Teukka/FlexHomeElPower/README.md

# JouKo - FlexHomeElPower (suom. 'Joustava Kotitalous')

Flexible Power Usage at Home, JouKo project main repository
This repository contains the public documentation of JouKo project.
The leader of the JouKo project is XAMK, Digital Economy: https://www.xamk.fi/en/digital-economy-spearheads-of-competence/

Links to the software of JouKo Project:
- Control Device software repository: https://github.com/Teukka/Jouko
- Server and user interfaces software repository: https://github.com/Metatavu/jouko
- Server API (interface desctriptions): https://github.com/Metatavu/jouko-api-spec
