Teukka/FlexHomeElPower/ControlDeviceDocuments/README.md

# Jouko Control Device Software documents

This folder contains the installation guides of JouKo control device.
