Teukka/FlexHomeElPower/HW_Descriptions/Voltage Source for GSM 2G/JouKo 5 V Source Schematics.pdf

# Home Electricity IoT

PROJECT ”JOUKO” BY SOUTH-EASTERN FINLAND UNIVERSITY OF APPLIED SCIENCES LTD
WWW.XAMK.FI/EN/FRONTPAGE/

# 5 V 2 A AC/DC Voltage Source for the JouKo GSM versions ( Countryside Control Unit )

THE MOTHERBOARD CONVERTS THIS 5 V DC INTO 4 V DC ACTUALLY REQUIRED BY THE GSM RADIO CHIPS BY SIMCOM. THIS CIRCUIT GENERATES

### 5 V 2 A FROM THE MAINS VOLTAGE. THERE ARE COUNTERMEASURES

AGAINST BOTH RADIATED AND CONDUCTED DISTURBANCE EMISSIONS
( EMI ) . THIS MODULE IS NOT REQUIRED WITH THE LORAWAN ONLY OR BLUETOOTH ONLY VERSIONS.

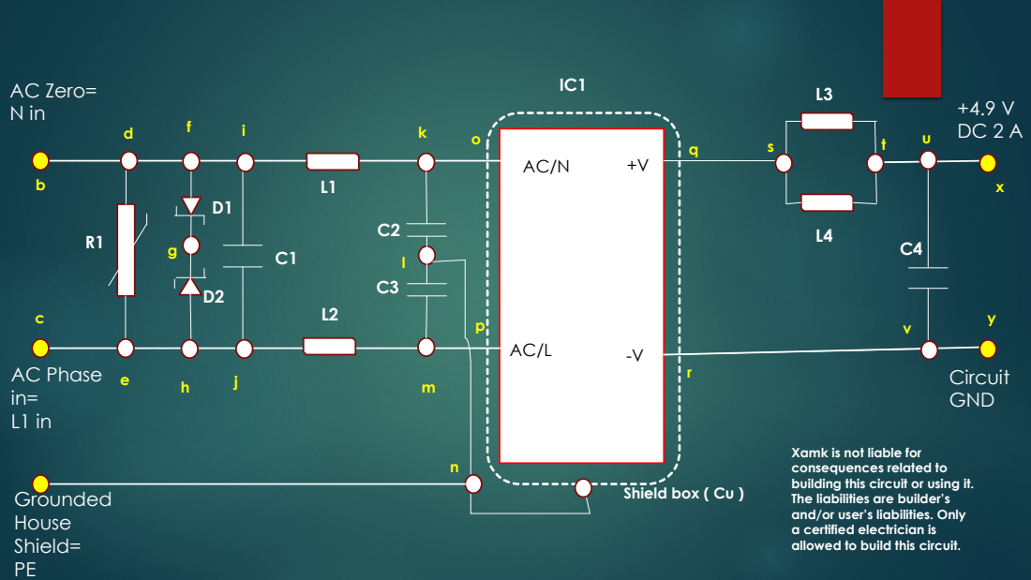
[picture p6: page 3]
AC Phase in= L1 in; AC Zero= N in; Grounded House Shield; Circuit GND

Xamk is not liable for consequences related to
building this circuit or using it.
The liabilities are builder’s
and/or user’s liabilities. Only
a certified electrician is
allowed to build this circuit

Shield box ( Cu
