Teukka/FlexHomeElPower/BusinessStudies/Business_Studies_Report_JouKo_in_Finnish.pdf

## Marjo Puikkonen & Roope Raati

# JouKo-joustava kotitalous projekti

## Kysyntäjoustopalvelun liiketoimintamallit

2018

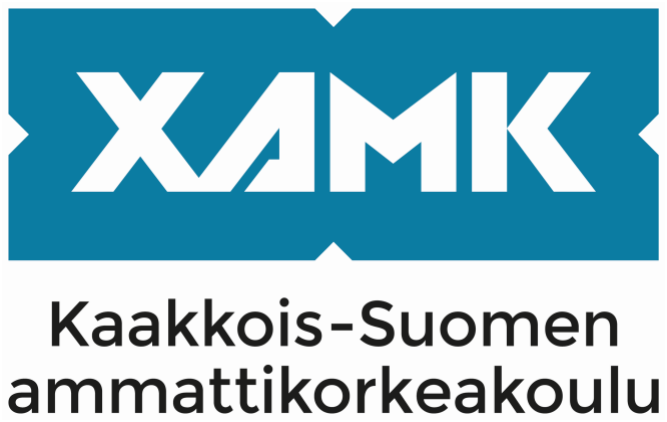
[picture p7: figure]

SISÄLLYS

LIITTEET

Liite 1. Haastattelun esitys

Liite 2. Kuvaluettelo

### 1 JOHDANTO

Tämä raportti käsittelee JouKo – laitteen kotitalousasiakkaille suunnatun ky-

syntäjoustopalvelun liiketoimintamallien tutkimista, potentiaalisten markkina-

paikkojen selvittämistä sekä laitteen teknistä soveltuvuutta kysyntäjoustoon.

Tutkimuksen lähdeaineistona olemme käyttäneet älysähköverkkoon liittyviä ai-

kaisempia tutkimusaineistoja sekä suorittamiemme haastatteluiden aineistoja.

### 2 KYSYNTÄJOUSTO SUOMESSA

Tähän mennessä kysyntäjoustoon ollaan osallistuttu teollisuuden isoilla kuor-

milla. Lisäksi muutamia pilotti kokeiluja on tehty muun muassa kauppakeskus-

ten kuormien ohjauksella sekä varavoiman hyödyntämisenä sähköverkkoon.

Kotitalouksien keskuudessa kysyntäjoustosta on kokeiluja muutamien sähkö-

yhtiöiden toteuttamana erilaisten projektien tiimoilta, jossa kotitalouksien läm-

minvesivaraaja ohjataan käyttämään lämmitykseen sähköpörssin halvimpia

tunteja kulutuksen tasaamiseksi. Tällaisia kokeiluja ovat toteuttaneet esimer-

kiksi Fortum ja Helen.

Uusia toimijoita kysyntäjoustoon ovat aggregaattorit, jotka osallistuvat markki-

noille keräämänsä pienkulutuksen ja –tuotannon avulla. Tällainen toiminta

mahdollistaa myös tulevaisuudessa kotitalouksien osallistumisen kysyntäjous-

toon. Vaikka alkuinvestoinnit ovat aluksi suuret, katsotaan sen olevan pitkällä

aikavälillä kustannustehokas niin itse yrittäjälle kuin koko kansantaloudellekin.

Tehomäärältään eniten kauppaa käydään taajuusohjatun häiriöreservin, sää-

tösähkö- sekä vuorokausimarkkinoilla (kuva 1). [8.]

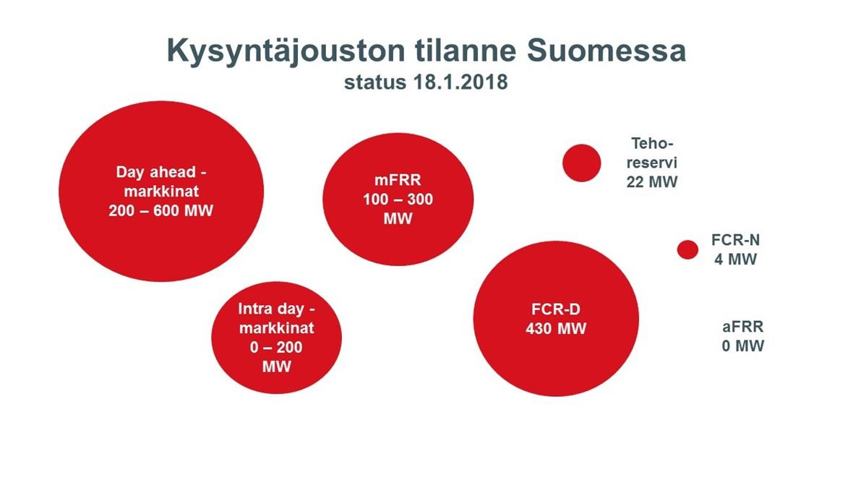
[picture p8: figure]

Kuva 1. Kysyntäjouston tilanne Suomessa. (Fingrid, 2018)

Sähkön hinta kuluttajalle rakentuu sähkön siirrosta (29%), myynnistä (37 %)

sekä sähköverosta (34%). Energiavirasto valvoo sähkön siirtohinnan kohtuulli-

suutta vuoden valvontajaksoissa. Mikäli siirtoliiketoiminnan tuotto ylittyy koh-

tuullisen tuoton rajan koko valvontajaksolla, otetaan se huomioon hinnoitte-

lussa seuraavalla valvontajaksolla. Sähkön siirtohinnasta peritään kulloinkin

voimassa olevat sähköverot. [15.]

Sähköliittymä on hinnoiteltu niin, että niillä katetaan jakeluverkon rakennus-

kustannuksia. Se koostuu liittymis- ja mittarointiosasta, ja on kokonaisuudes-

saan arvonlisäverotonta. Energiahinta määräytyy kunkin yhtiön sopimusten

mukaisesti joko määräaikaisena, toistaiseksi voimassa olevana tai Spot-hin-

taan perustuvana sopimuksena. [15.]

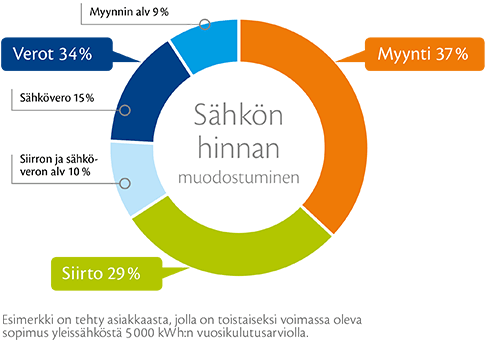
[picture p9: figure]

Kuva 2. Sähkön hinnan muodostuminen. (Lappeenrannan energia oy)

### 2.1 Tulevaisuuden energiamarkkinat 2019-2024

Tulevaisuudessa energia-alan toimintatavat tulevat muuttumaan, joka näkyy

niin energian tuotannossa, käytössä kuin siirrossakin. Järjestelmät pyritään te-

kemään hiilineutraaleiksi, jossa fossiilisilla polttoaineilla toimiva perusvoima

korvataan vaihtelevalla tuotannolla. Tämä tuotetaan uusiutuvalla tai muuten

päästöttömillä energialähteillä kuten tuuli-, aurinko- ja vesivoimalla. Pariisin il-

mastosopimuksen mukaan energiajärjestelmä tulee olla päästötön vuoteen

2050 mennessä, joka tarkoittaa sitä, että fossiilisista polttoaineista on luovut-

tava kokonaan muutaman vuosikymmenen aikana. Suurin osa näistä polttoai-

neista käytetään energiana liikenteessä sekä lämmön ja sähkön tuotannossa.

Kehitys tuo tullessaan muutoksen, jossa edetään suurista tuotantoyksiköistä

kohti hajautetumpaa ja kaksisuuntaista järjestelmää. Muutosta pyritään vauh-

dittamaan myös erilaisilla ohjauskeinoilla kuten päästökaupalla ja tukijärjestel-

millä. [9]

Energiamurros kattaa koko Eurooppaa, sillä energian siirtoverkkoja ja markki-

noita integroidaan ja harmonisoidaan koko EU:n tasolla. Esimerkiksi Fingrid ja

Ruotsin kantaverkkoyhtiö ovat päättäneet toteuttaa uuden pohjoiseen sijoittu-

van rajasiirtoyhteyden vuoteen 2025 mennessä, jolloin edullista sähköä pää-

see virtaamaan Suomeen. Tämä parantaa muun muassa käyttövarmuutta ja turvaa sähkön riittävyyteen talvipakkasilla. Yhteisten markkinoiden avulla saa-

vutetaan järjestelmän mahdollisimman tehokas käyttö, joka tuo vakautta toi-

mintaan. [10.]

Asiakkaan rooli tulee myös muuttumaan. Tämän hetkisestä passiivisesta ku-

luttaja-asiakkaasta muovautuu aktiivinen markkinatoimija, kun vaihtelevan tuo-

tannon lisääntyessä myös kulutuksen pitää joustaa enemmän. Kehittyneen

teknologian myötä myös asiakas pääsee toimimaan osana vallitsevaa markki-

naa. Heidän rooli etenkin kysyntäjouston, pientuotannon sekä varastoinnin

osalla tulee olemaan tärkeässä osassa. Menestyäkseen energiamurroksessa,

vaatii se rohkeita toimijoita energiamarkkinoille. Heiltä odotetaan uudenlaista

ajattelua, innovaatioita, rohkeita päätöksiä ja kokeiluhalukkuutta. Kuluttajien

houkutteleminen energiamarkkinoille nousee myös tärkeäksi asiaksi ja se,

kuinka heitä tulisi aktivoida mukaan. Kuluttajien muuttuminen markkinatoimi-

joiksi vaatii kuitenkin helppokäyttöisiä ja ymmärrettäviä palveluita, joilla heräte-

tään kuluttajan kiinnostus palvelua kohtaan. Tämä luo vaatimukset itse sovel-

lukselle, jonka avulla omaa kulutusta ja tuotantoa ohjataan. [11.]

Aggregaattoritoiminnalle nähdään tarvetta tulevaisuudessa kulutuksen tasaa-

misessa. Mikäli siirrytään tehopohjaiseen hinnoitteluun, tarve kasvaa entises-

tään. Tällöin myös kotitalousasiakkaiden kiinnostus kysyntäjoustopalvelua

kohtaan kasvaa. Tulevaisuudessa myös ympäristötekijöiden merkitys kasvaa

ja kuluttajat ovat entistä tietoisempia kulutuksen lisääntymisen vaikutuksesta

ympäristötekijöihin. Näin ollen he ovat myös valmiimpia toimimaan sen eteen.

Tulevaisuuden tietoyhteiskunta edellyttää jakeluverkolta suurempaa jousta-

vuutta ja luotettavuutta. Sähkönkulutus kotitalouksissa tulee kasvamaan enti-

sestään, sillä sähkölaitteiden määrä lisääntyy. Näiden lisäksi sähköautojen

yleistyminen luo omat haasteensa verkon kapasiteetin riittävyydelle. Hajau-

tettu energiatuotanto vaatii nykyistä kehittyneempien säätö- ja tietoliikennelait-

teiden käyttöönottoa. [12]

Tulevaisuus avaa mahdollisesti uusia markkinapaikkoja ja näin tuo tullessaan

uusia mahdollisuuksia erilaiselle liiketoiminnalle. Näihin muutoksiin on kuiten-

kin kyettävä reagoimaan jo hyvissä ajoin, jolloin säästytään mahdolliselta te-

hopulalta. Ideaalisinta olisi pitää kuormat tasaisena, jolloin varavoimalaitoksia

ei tarvitsisi kytkeä päälle. Se olisi taloudellisesti kannattavaa, mutta ennen kaikkea ympäristöystävällistä. Kotitalouksien omatuotanto tulee tulevaisuu-

dessa kasvamaan sekä sen varastointi. Näin ollen kotitaloudet pystyvät myös

helpommin osallistumaan kysyntäjoustoon. Kokonaisvaltaisen kulutuksen opti-

mointi asiakkaan puolesta tulee olemaan avainasemassa uuden tyyppiselle

sähkösopimukselle. Datahub, energian keskuspankki ja energian internet tule-

vat olemaan tulevaisuuden kehityssuuntaa, jotka omilta osiltaan ovat muok-

kaamassa energiamarkkinoita.

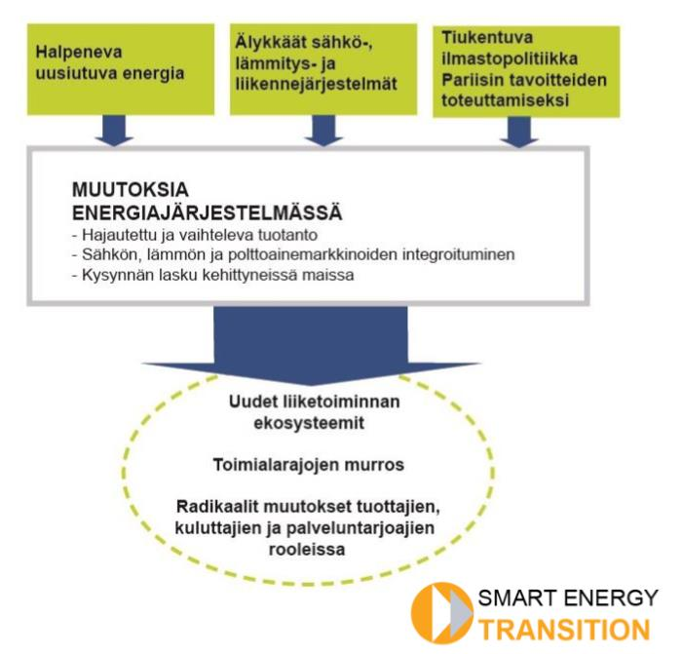
[picture p10: figure]

Kuva 3. Energiamarkkinan muutos. (Honkapuro, S. 2017).

### 2.2 Smart Grid – Älysähköverkko

Älykkäässä sähköverkossa yhdistyvät sähkövoimatekniikka sekä automaatio-,

tieto- ja viestintäteknologioiden ratkaisut. Älyverkko tarkkailee sähkön virtaa-

mista ja optimoi sähkön kulutusta sekä tuotantoa jatkuvasti. Tämä mahdollistaa kustannustehokkaan siirtymisen kohti hajautetumpaa ja vähähiilistä sähköjärjestelmää. Älyverkko toimii myös alustana uusille, innovatiivisille sähköön

liittyville palveluille. [2.]

Älyverkon avulla sähkönkuluttajalla on enemmän vaikutusmahdollisuuksia ja

hän voi osallistua nykyistä helpommin sähkömarkkinoille. Asiakkaalla on pa-

remmat mahdollisuudet vaikuttaa sähkönkäytön kokonaiskustannuksiin sekä

tehdä erilaisia arvovalintoja omassa energian käytössä. Kuluttaja voi tarjota

esimerkiksi sähkölämmityksen, lämminvesivaraajan tai sähköauton latauksen

ohjaamista sähkömarkkinoille. Tämä pitää tehdä ilman, että asumismukavuus

kärsii. [2.]

Suomessa sähköverkkoon investoidaan 2020-luvun loppuun mennessä yli 8

miljardia euroa. Tämä tarkoittaa jakeluverkoston uudelleen rakentamista suu-

relta osin. Samalla verkon rakenne muuttuu, kun ilmajohdoista siirrytään maa-

kaapelointiin. Kun sähköverkkoa täydennetään tietoliikenneverkolla sekä älyk-

käällä energiankäytön seurannalla, tuloksena on tulevaisuuden haasteisiin vastaava älykäs sähköjärjestelmä. Älykäs energiamittari sekä kaksisuuntainen

tiedonsiirto asiakkaan ja verkon välillä ovat keskeisiä asioita sähköverkkoa uu-

distettaessa. [14]

### 3 KYSYNTÄJOUSTOPALVELUN TARPEEN KARTOITUS

Suoritimme haastattelut hankkeessa mukana oleville sähköyhtiöille sekä kan-

taverkkoyhtiölle. Haastattelut suoritettiin osaksi paikan päällä sekä Skype for

Business-sovellusta käyttäen. Haastattelut toteutettiin heinä – elokuun 2018

aikana. Yhteensä yhtiöitä oli mukana 6 ja haastatteluihin osallistui niistä 11

henkilöä. Haastatteluiden pohjalta laadimme yhteenvedon saaduista tulok-

sista. Haastattelun esitys liitteenä (liite 1).

### 3.1 Haastattelun keskeisimmät kysymykset

Haastatteluiden tarkoituksena oli selvittää yhtiöiden intressi kuluttajille suun-

nattuun kysyntäjoustopalveluun sekä JouKo-laitteen sopivuus heidän tarpeeseensa nähden. Haastattelut koostuivat projektin lyhyestä esittelystä, kysy-

myksistä yhtiöille sekä kesän aikana saavutetuista tuloksista. Vastausten

avulla rakensimme lopullisen liiketoimintamallin, joka esitellään luvussa 4.

Haastattelu koostui seuraavista kysymyksistä:

- Millaisiin tarpeisiin sähköyhtiöt tarvitsevat kysyntäjoustopalvelua?
- Miten lyhyt säätöviiveen tulisi olla, jotta yhtiöt pystyttäisivät vastaamaan markkinoiden tarjouspyyntöihin?
- Miten näette hitaan, 32 min tai yli, kysyntäjouston mahdollisuudet?
- Onko tulevaisuudessa mahdollista, että tulisi uusi kysyntäjoustolle suunnattu tarjouspyyntötyyppi? Jos löytyy uusi tai olemassa oleva tarjouspyyntötyyppi, johon voi vastata JouKo-palvelulla, pitääkö silloin olla valmis myös myymään lisäkulutusta?
- Onko tällä hetkellä olemassa sähkömyyntiyhtiöillä oma markkinapaikka JouKo:n kaltaiselle laitteelle?
- Kuinka usein ja kuinka pitkiä katkot tulisi olla, jotta vastaisivat
- tarpeeseen? Kuinka suuri tehomäärä jouston piirissä tulisi olla?
- Kattaako tämän hetkiset laiteominaisuudet tulevaisuuden tarpeet
- Kysyntäjoustopalvelussa (Lora verkko, suositus 5-30 min ja Gsm minimissään noin 5 sek)?
- Aggregaattorin asema lähitulevaisuudessa?
- Mihin suuntaan hinnoittelumallia tulisi kehittää?
- Asiakassegmentit: passiivinen, osittain aktiivinen vai aktiivinen asiakasmalli?
- Kotitalousasiakkaiden suhtautuminen kysyntäjoustoon?
- Hyötyykö sähköyhtiö joustosta itsessään vai tuleeko heille maksaa kompensaatiota katkoista, mikäli aggregaattori toimii kuluttajan ja sähköyhtiön välissä?
- Ovatko sähköyhtiöt valmiita maksamaan joustosta? Laitekustannukset? Palvelun ylläpitomaksut?
- Mahdollisia lisäominaisuuksia nykyiseen käyttöliittymään ja mobiilisovellukseen?
- Millaisia ominaisuuksia sähköyhtiön JouKo-palvelun käyttöliittymällä tulisi olla?
- Mitä dataa pitää kulkea JouKon ja sähköyhtiön verkkopalvelun välillä?

### 3.2 Yhteenveto haastatteluista

Yllä oleviin kysymyksiin perustuen, olemme laatineet seuraavan yhteenvedon

vastauksista. Haastattelemamme yhtiöt kokevat tarvitsevansa kysyntäjousto-

palvelua enemmän sähkönmyyntiyhtiöiden tarpeeseen kuin verkkoyhtiöiden tarpeeseen. Kysyntäjoustopalvelu vahvistaisi myyntiyhtiön kilpailukykyä mark-

kinoilla, jolloin he voisivat tarjota kokonaisvaltaista kulutuksen optimointia koti-

talousasiakkaalle.

### 3.2.1 Kysyntäjouston tarpeen kartoitus

Myyntiyhtiöt kokivat kysyntäjouston tarpeelliseksi muun muassa seuraaviin

asioihin: kulutuspiikkien tasaaminen, taseen hallinta, suojaksi sähkökaup-

paan sekä pääsy Fingridin säätösähkömarkkinoille asiakkaiden kysyntäjousto-

kuormien avulla. Verkkoyhtiöt olivat sitä mieltä, että sähköverkon kapasiteetti

on mitoitettu riittävästi yläkanttiin. Kysyntäjoustolle ei ole tarvetta verkon kapa-

siteetin puolesta. Tulevaisuudessa olosuhteet tulevat muuttumaan, jolloin

huipputeho kasvaa. Tämä voi aiheuttaa ongelmia mahdollisissa verkon pullon-

kauloissa. Verkkoyhtiö voisi ostaa kysyntäjoustopalvelua tarvittaessa esimer-

kiksi tehopulassa.

Tiedustelimme myös Jouko-laitteen nopeuden riittävyyttä. JouKo-laitteesta on

erilaisia versioita, joilla päästään erilaisiin tiedonsiirtonopeuksiin. Hitaimmalla

laitteella nopeus olisi luokkaa 32 min. Useiden yhtiöiden mielestä tämä no-

peus on liian hidas, koska sillä ei voida osallistua kaikille Fingridin markki-

noille. Säätöviiveen tulisi olla mahdollisimman lyhyt, jolloin päästäisiin reaaliai-

kaiseen säätöön. Hitain laite soveltuu tällä hetkellä pääasiassa vuorokausi-

markkinoille (Spot-markkinat). Nopeammalla (2G-yhteydellä) sekä kehitteillä

olevalla 4G-yhteydellä voitaisiin osallistua esimerkiksi säätösähkömarkkinoille

(mFFR) tai häiriöreservimarkkinoille (FCR-N). Tulevaisuudessa vuorokausi-

markkinoilla siirrytään tunnin kauppa-ajasta 15 minuutin kauppa-aikaan, jolloin

nopeaa säätöä tullaan tarvitsemaan enemmän. Myös muita uusia markkina-

paikkoja pidetään mahdollisena kaikkien yhtiöiden mielestä. Sähköyhtiöillä ei

ole omia markkinapaikkoja kysyntäjoustolle tällä hetkellä.

Katkon pituuteen tai niiden määrään, jolla joustoon osallistutaan, eivät yhtiöt

osanneet määrittää. Sopivana tehomääränä pidettiin Fingridin markkinoiden

nykyisiä vaatimuksia. Osa yhtiöistä arveli, että nykyiset säätökoot tulevat mah-

dollisesti pienenemään ja katkojen pituudet monipuoleistumaan. Katkoja to-

teuttaessa on huomioitava niiden aloituksen ja lopetuksen porrastaminen, jot-

tei verkkoon syntyisi hetkellisiä tehopiikkejä.

### 3.2.2 Aggregointi

Tiedustelimme yhtiöiltä aggregaattorin asemasta lähitulevaisuudessa. Heidän

mukaan aggregoinnille nähdään tarvetta itsenäisen aggregaattorin sekä säh-

kömyyntiyhtiön toteuttamana. Aggregaattorit voisivat erikoistua tiettyyn toi-

mialaan esimerkiksi kotitaloudet tai pienteollisuus. Itsenäinen aggregaattori

nähdään myös mahdollisena ongelmana sähkömyyntiyhtiölle, mikäli aggre-

gaattori ja myyntiyhtiö eivät tee yhteistyötä kysyntäjouston toteuttamisessa. It-

senäisen aggregaattorin toiminta voi sotkea myyntiyhtiöiden liiketoimintaa lain-

säädännön puutteellisuuden vuoksi. Ohjeistusta aggregointiin tulisikin tarken-

taa, sekä rooleista ja oikeuksista eri toimijoiden välillä sopia.

Myyntiyhtiöt kokevat aggregointipalvelun tarjoamisen asiakkaille tärkeäksi hei-

dän itsensä suorittamana, sillä se tukisi hyvin heidän muuta liiketoimintaa ja

samalla he pystyisivät tarjoamaan kokonaisvaltaisempaa palvelua asiakkail-

leen. Suurten asiakasmäärien kerääminen etenkin pienten yhtiöiden keskuu-

dessa saattaa koitua haasteelliseksi. Mahdollisuutena nähtiin, että pienet yh-

tiöt voisivat perustaa yhteisen aggregaattorin.

Tulevaisuuden hinnoittelusta yhtiöt olivat yhtä mieltä siitä, että tehoperustei-

nen hinnoittelumalli on tulevaisuutta ja osa yhtiöistä on siihen siirtynytkin.

Tämä hinnoittelumalli kannustaisi asiakasta tarkkailemaan ja leikkaamaan

huipputehoaan. Nykyinen 2-tariffihinnoittelu eli yö- ja päiväsähkö on yhtiöiden

mielestä vanhentunut perinne, joka haittaa kysyntäjouston toteuttamista. Siitä

tulisi luopua, jolloin se tarjoaisi paremmat mahdollisuudet myös kysyntäjous-

tolle. Hinnoittelumallia ja siihen liittyvää kysyntäjoustoa tulisi viedä kohti koko-

naisvaltaista palvelua (Energy As a Service), joka olisi asiakkaan kannalta hel-

poiten ymmärrettävissä. Tämä vaatii eri järjestelmien rajapintojen tuomista yh-

teen paikkaan, jotta muun muassa laskutus saadaan yksinkertaisemmaksi.

Suunnitteilla oleva Datahub helpottaa tämän toteutumista tulevaisuudessa.

Yhtiöt näkivät, että kuukausiperusteinen pakettihinnoittelu ja kiinteä alennus

kysyntäjoustoon osallistumisesta houkuttelisi asiakkaita helpoiten palvelun pii-

riin. Passiivinen ja osittain aktiivinen asiakasmalli saivat yhtiöiltä eniten kanna-

tusta. (Asiakasmallit kuvataan tarkemmin luvussa 4.5). Yhtiöt olivat samaa mieltä siitä, että asiakkaat eivät ole valmiita maksamaan laitetta, mikäli se pe-

rustuu pelkkään kuormanohjaukseen. Mikäli asiakas maksaisi laitteen tulisi

heidän saada lisäarvoa palvelusta tai kunnollinen korvaus joustoon osallistu-

misesta. Mikäli sähköyhtiö tai itsenäinen aggregaattori maksaa laitteen asiak-

kaalle, tulisi sen olla valmistuskustannuksiltaan, asennukseltaan ja ylläpidol-

taan edullinen. Isommat yhtiöt olivat valmiimpia maksamaan laitekustannukset

kuin pienet. Yhteisasennusta asiakkaan oman tuotannon kanssa pidettiin

mahdollisena vaihtoehtona.

Monet yhtiöt kokevat itsenäisen aggregaattorin tulemisen haastavaksi sähkö-

myyntiyhtiön näkökulmasta. Aggregaattorin tulisikin tehdä yhteistyötä myynti-

yhtiön kanssa joustoa toteuttaessa tai maksaa yhtiölle kompensaatiota mah-

dollisista joustoista aiheutuneista profiilikustannusten kasvusta. Roolit näiden

toimijoiden välillä tulisi selkeästi määritellä, jotta molempien liiketoimintamah-

dollisuus säilyy kannattavana.

Haastattelun lopussa esittelimme suunnittelemamme liiketoimintamallit an-

saintamahdollisuuksineen sekä asiakassegmentit. Yhtiöt näkivät toiminnan

edelleen mahdollisena, vaikka kannattaviin tuottoihin tämän hetkisillä markki-

noilla ei päästäkään. Kotitalouksille suunnattu kysyntäjoustopalvelu sai kanna-

tusta vähäisistä tuotto-odotuksista huolimatta.

### 3.2.3 Palvelussa kehitettävät asiat

Nykyisten käyttöliittymän ja mobiilisovelluksen ominaisuuksien lisäksi yhtiöt pi-

tivät huonelämpötilanmittausta, laskutustietojen saatavuutta, asunnon koko-

naiskulutus tietoa reaaliajassa, kysyntäjoustoon osallistumisesta saadun sääs-

tön määrää sekä kotona/pois-kytkin mahdollisuutta tärkeinä kehitettävinä omi-

naisuuksina. Tietojärjestelmien rajapintojen luominen JouKo-palvelun ja yhtiöi-

den välillä sai ristiriitaisia vastauksia, sillä osa yhtiöistä piti sitä hankalana ja

kalliina toteuttaa. Osa puolestaan ei kokenut sen olevan ongelma.

Haastatteluissa esitettiin ajatusta sähköautonlatauksen ohjauksesta. Osa yhti-

öistä piti tätä kehittämisen arvoisena ideana ja osa koki sen vielä liian kau-

kaiseksi tarpeeksi. Taloyhtiöiden sähköjärjestelmien kapasiteetti tiedostettiin tulevaisuuden ongelmaksi, kun sähköautojen lataaminen lisääntyy. Ongel-

maksi kuitenkin koettiin sähköautojen vähäinen määrä sekä epävarmuus mää-

rän kasvamisesta. Myöskin ohjauksen toteutuksen hankaluus koettiin ongel-

maksi.

Kaiken kaikkiaan yhtiöt olivat samaa mieltä kysyntäjouston mahdollisuuksista

sekä heikkouksista. Palvelun tarve tulevaisuudessa kasvaa ja kotitalousasiak-

kaat nähdään potentiaalisena joustoryhmänä. Haasteelliseksi kuitenkin koe-

taan heidän saaminen kysyntäjouston piiriin. Yhtiöiden vastaukset helpottivat

liiketoimintamallien suunnittelussa suuresti.

### 4 KYSYNTÄJOUSTON LIIKETOIMINTAMALLIT

Tässä luvussa esittelemme suunnittelemamme liiketoimintamallit kysyntäjous-

topalvelulle, jotka perustuvat suorittamiimme haastatteluihin sekä muuhun tut-

kimaamme aineistoon. Kerromme tarkemmin myös tämän hetkisestä markki-

natilanteesta sekä Jouko-laitteen mahdollisuuksista markkinoilla.

### 4.1 Markkinatilanne

Tällä hetkellä kysyntäjoustoon pystytään osallistumaan vain Fingridin markki-

noilla, joten kannattavuuslaskelmamme perustuvat näihin markkinoihin. Koska

osalla markkinapaikalla säätöaika on hyvinkin pieni, olemme käsitelleet vain

niitä markkinoita, joille JouKo-laitteella on mahdollisuus osallistua. Osalla

markkinoista pitää pystyä myymään myös lisäkulutusta, mutta lisäkulutuslas-

kelmia emme ole tässä esittäneet. Sen toteutus kotitalouksissa on haastavaa

ilman erillistä akkua. Näin ollen laskelmat perustuvat vain ylössäätötarjouksiin

Fingridille.

Osallistuminen kysyntäjoustoon tarkoittaa sitä, että sähkönkäyttöä siirretään

korkean kulutuksen ja hinnan tunneilta edullisempaan ajankohtaan. Tämä voi

olla myös käytön hetkellistä muuttamista tehotasapainon hallinnan tarpeisiin.

Tällä hetkellä tehotasapainon ylläpidossa ovat toimineet suurteollisuuden

kuormat, mutta tulevaisuudessa entistä enemmän tarvetta tulee myös pienem-

pien toimijoiden osallistumiselle. Fingridin markkinoille osallistuessa on otettava huomioon minimitarjouskoot, ennen kuin markkinoille pystytään osallistu-

maan. Olemme laskeneet JouKo-palvelun ansaintamallit seuraaville Fingridin

markkinoille: Säätösähkömarkkinat (mFFR), taajuusohjattu käyttöreservi

(FCR-N), vuorokausimarkkinat (Elspot) sekä päivän sisäiset markkinat (El-

bas). [1] Nämä markkinapaikat vaativat useamman tuhannen asiakkaan ryh-

män kotitalouksista. Jotta markkinoille voidaan osallistua, tulee Fingridin vaati-

musten täyttyminen osoittaa säätökokeilla. Tarkemmat tekniset vaatimukset

löytyvät Fingridin sivuilta sekä kunkin markkinapaikan omasta sovellusoh-

jeesta. Sieltä löytyvät myös raportointiin ja seurantaan liittyvät vaatimukset.

Ansaintalaskelmat on esitelty kohdassa 4.4.

### 4.1.1 Taajuusohjattu käyttöreservi (FCR-N)

Taajuusohjattua käyttöreserviä käytetään jatkuvaan taajuuden hallintaan ja se

aktivoituu automaattisesti taajuudenmuutoksista. Taajuusohjatun käyttöreser-

vin tehtävänä on pitää taajuus normaalitaajuusalueella eli 49,9 – 50,1 Hz vä-

lillä. Säädön vähimmäiskoko markkinapaikalla on 0,1 MW ja sen aktivoitumi-

nen tulisi tapahtua 3 minuutissa. [5.] Tällä markkinapaikalla toteutetaan sym-

metristä säätöä eli osallistuessaan markkinoille, tulee toimijan pystyä sekä te-

honlisäykseen että –pudotukseen. [6.]

Taajuusohjattujen reservien markkinapaikat perustuvat vuosi- sekä tuntimark-

kinoihin. Vuosimarkkinoilla tarjouskilpailu järjestetään aina syksyisin seuraa-

valle vuodelle, jossa määritellään toimijakohtainen vuosisopimusmäärä sekä

vuosimarkkinahinta. Vuosimarkkinahinta määräytyy kalleimman hyväksytyn

tarjouksen mukaisesti ja on kaikille toimijoille sama. Kesken kalenterivuotta ei

pystytä osallistumaan markkinoille. Reservinmyyjä tulee jättää sitovat tuntikoh-

taiset reservisuunnitelmat (MW) ylläpitämästään reservistä edellispäivänä klo

18:00 mennessä ja Fingrid puolestaan ostaa reservisuunnitelman mukaisesti

täysimääräisenä kiinteällä hinnalla. [6.]

Tuntimarkkinoille pystytään osallistumaan mihin aikaa vuotta tahansa. Myy-

dessään tuntimarkkinoilla, reservinmyyjä jättää tuntikohtaiset reservitarjoukset

edellisenä päivänä klo 18:30 mennessä. Fingrid puolestaan ostaa vain tarvit-

semansa määrän kullekin tunnille. Huomioitava on, että välttämättä kaikkina

tunteina ostoa ei tapahdu ja kullekin tunnille tulee oma hintansa. Tuntihinnat määräytyvät kalleimman käytetyn tarjouksen mukaisesti. Tärkeää on myös tie-

dostaa, että vuosisopimuksen omaava reservimyyjä voi osallistua tuntimarkki-

noille vain, jos kyseisellä tunnilla vuosisopimusmäärä on täyttynyt täysimääräi-

sesti. [6.]

### 4.1.2 Säätösähkömarkkinat (mFFR) ja nopea häiriöreservi

Säätösähkömarkkinoille tuotannon ja kuorman haltijat voivat antaa säätötar-

jouksia säätökykyisestä kapasiteetistaan. Säätösähkömarkkinoille osallistumi-

nen edellyttää säätösähkömarkkinasopimuksen tekemistä Fingridin kanssa.

Kantaverkkoyhtiö aktivoi tarvittaessa tarjouksia säätösähkömarkkinoilta teho-

tasapainon hallitsemiseksi normaalitilanteessa ja häiriötilanteissa. [13.]

Säätösähkömarkkinoille osallistuminen edellyttää Fingridin säätökokeiden lä-

päisyä. Säätösähkömarkkinoilla 5MW:n tehonmuutos pitää kyetä tekemään 15

minuutin kuluessa aktivointipyynnöstä. Tarjoukset tulee jättää erikseen ylös- ja

alassäädöistä. Tarjoukset jätetään Fingridille viimeistään 45 minuuttia ennen

käyttötuntia säätösähkötarjousohjeen mukaisesti. Korvaus säädöstä lasketaan

tilatun energian ja kalleimman tunnin aikana käytetyn tarjouksen mukaan. [13.]

Säätötarjouksen tulee sisältää seuraavat tiedot säädettävästä kapasiteetista:

- Teho (MW)
- Hinta (€/MW)
- Tuotanto/kulutus
- Siirtoalue, jossa tarjottu resurssi sijaitsee
- Säätöresurssin nimi, esimerkiksi voimalaitos, tuotantolaji tai muu vastaava
Säätökapasiteettimarkkinoilla Fingrid varmistaa, että heillä on riittävästi käytet-

tävissä ylössäätötarjouksia säätösähkömarkkinoille seuraavana päivänä. Sää-

tökapasiteettimarkkinoita käytetään varavoimalaitosten huoltojen ja muun epä-

käytettävyyden aikaiseen nopean häiriöreservin hankintaan. Säätökapasiteetti

kilpailutetaan viikoksi kerrallaan. Valituksi tullut reservinmyyjä sitoutuu jättä-

mään ylös säätötarjouksia edellispäivänä klo 13.00 mennessä. Säätökapasi-

teettitarjoukset käytetään säätösähkömarkkinoilla markkinaehtoisten säätötar-

jousten jälkeen. Säätösähkömarkkinoista poiketen reservinmyyjä saa korvausta ylössäätötarjouksen jättämisestä. Tarjouksen mahdollisesta aktivoitu-

misesta saatavat korvaukset sekä sen pysyvyys vaikuttavat myyjän saamaan

korvaukseen. [13.]

### 4.1.3 Päivän sisäinen markkina (Elbas) ja vuorokausimarkkina (Elspot)

Päivän sisäisen markkinan ja vuorokausimarkkinan hinnat määräytyvät Poh-

joismaiden sähköpörssin (Nord Pool) mukaisesti. Vuorokausimarkkinoilla käy-

dään kauppaa seuraavan vuorokauden jokaiselle tunnille tarvittavasta sähkön-

tuotannosta tyydyttämään kysynnän tarpeet. Näiden markkinoiden sulkeudut-

tua, siirrytään kauppaa käymään jokaiselle tunnille erikseen päivän sisäisille

markkinoille. Tämän markkinapaikan kaupoilla pystytään täsmäyttämään ky-

syntä ja tarjonta, mikäli niissä tapahtuu muutosta päivän kuluessa. Näille säh-

kön tukkumarkkinoille pystyvät osallistumaan sähkön tuottajat sekä sähkön

suuret kuluttaja- ja välittäjäyhtiöt. [7.]

Vuorokausimarkkinoille tarjous tulee jättää edellisenä päivänä klo 13 men-

nessä ja päivän sisäiselle markkinalle 30 minuuttia ennen käyttötuntia. Aktivoi-

tumisaika vuorokausimarkkinoilla on 12 tuntia, kun taas päivän sisäisellä

markkinalla 1 tunti. [7.]

### 4.2 JouKo-laitteen SWOT analyysi

SWOT-analyysissä olemme käyneet läpi JouKo-laitteen ja palvelun vahvuuk-

sia, heikkouksia, mahdollisuuksia ja uhkia. Olemme verranneet laitetta alalla

toimiviin kilpaileviin laitteisiin. Koska laite on valmistettu sähköyhtiöiden tar-

peita ajatellen, ovat laitteen lisäominaisuudet olemattomat. Mahdollisuus on

kuitenkin räätälöidä tuotetta suhteellisenkin edullisilla lisäkomponenteilla tuo-

den asiakkaalle lisämukavuutta.

Laitteen vahvuuksina voidaankin pitää tuotteen edullisuutta muihin kilpaileviin

tuotteisiin nähden. Se on myös yksinkertainen käyttää, joten tuotteen sekä

palvelun käyttöönotto ei vaadi kotitalousasiakkailtakaan paljoa. Vaikka laite on

halpa, on se tietoturvaltaan erittäin hyvä. Se ei käytä kodin verkkoa tiedonsiir-

toon, jolloin tietomurron riski on pienenpieni. Halpa hinta tuo kuitenkin heik-

kouksia, joita ovat muun muassa hitaus, yksinkertaisuus ja ominaisuuksien vähyys. Kotitalousasiakkaan saama arvo ja hyöty ovat suhteessa vähäistä

verrattuna kilpaileviin laitteisiin ja siihen, mitä hän joutuu mahdollisesti maksa-

maan laitteesta ja miten hän joutuu rajoittamaan itse sähkönkäyttöä.

Jouko-laite avaa mahdollisuuksia sähkömyyntiyhtiöille ja itsenäisille aggre-

gaattoreille osallistua kysyntäjoustoon hyödyntäen kotitalousasiakkaiden säh-

könkulutusta. Tämä täydentäisi etenkin sähkömyyntiyhtiöiden jo olemassa ole-

vaa liiketoimintaa. Tällä tavoin he pystyisivät myös sitouttamaan kotitalous-

asiakkaat paremmin asiakkaakseen. Kilpailu sähkömarkkinoilla on kovaa ja

olemassa olevia asiakassuhteita tulisi pystyä säilyttämään. JouKo-laitteen

avulla ja uudella kysyntäjoustopalvelulla he pystyisivät osallistumaan jo ole-

massa oleville Fingridin markkinoille. Tulevaisuus tuo tullessa varmasti myös

uusia markkinapaikkoja.

Suurimpana uhkana laitteen ja palvelun menestykselle nähdään sen hitaus.

Tällaisenaan se ei tule palvelemaan tulevaisuuden tarpeita, sillä tulevaisuu-

dessa mennään yhä lyhyempiin aktivointiaikoihin. Nopean säädön tarve kas-

vaa. Kotitalouksia ajatellen myös laitteen ominaisuuksien vähyys saattaa koi-

tua haasteelliseksi houkuttamaan palvelun piiriin. Kokonaisvaltaisen palvelu-

konseptin rakentaminen (EaaS) kotitalousasiakkaille motivoisi paremmin si-

toutumaan siihen.

Seuraavassa kuvassa (kuva 4.) on esiteltyinä JouKo – laitteen vahvuudet,

heikkoudet, mahdollisuudet ja uhat.

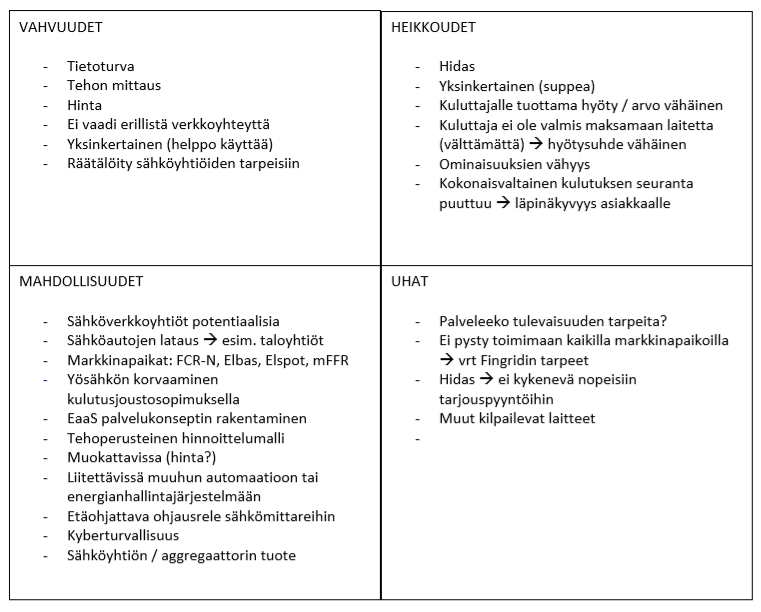
[picture p11: figure]

Kuva 4. JouKo-laitteen SWOT-analyysi.

### 4.3 Teknillinen toteuttaminen kodeissa

JouKo-laite on suunniteltu katkaisemaan ja uudelleen kytkemään 16 ampeerin

virran kolmelta vaiheelta. Kotitalouksissa tyypillisiä kolmivaiheisia laitteita ovat

kiuas, liesi/uuni sekä kolmivaiheinen lämminvesivaraaja. Kiuas ja liesi ovat

molemmat suuritehoisia laitteita ja tehon puolesta ne sopisivatkin hyvin kysyn-

täjoustoon. Ongelmaksi kuitenkin muodostuu näiden laitteiden käyttötarve, -

ajankohta sekä –määrä. Esimerkiksi liesi on päällä vain silloin kun sillä laite-

taan ruokaa, ja kuluttaja ei ole valmis keskeyttämään ruuanlaittoa kysyntä-

jouston vuoksi. Kiukaassa vastaan tulee saman tyyppinen ongelma. Kuluttaja

ei kovin herkästi ole valmis siirtämään saunomisen ajankohtaa. Molemmissa

tapauksissa ongelmaksi muodostuu laitteiden vähäinen käyttö, kumpaakaan

laitetta ei välttämättä käytetä päivittäin ja käyttöajat ovat melko lyhyitä. Nämä

kuormat eivät siis sovellu kysyntäjouston piiriin.

Lämminvesivaraaja sekä sähköinen lämmitys ovat järkevimpiä jouston piiriin

kytkettäviä kuormia kotitalouksissa. Laskimme, että asunnon lämmitys jakau-

tuisi eri vuoden ajoille seuraavasti: kylmät kuukaudet joulu-helmikuu 2kW, syys-marraskuu + maalis-toukokuu 1kW eli 50 prosenttia kylmienkuukausien

tehosta ja kesä-elokuu 0kW. Tämän lisäksi mukaan voidaan kytkeä lämminve-

sivaraaja, joka kasvattaa kokonaiskuormaa hieman. Asunnon koko lämmityk-

sen sekä lämminvesivaraajan liittäminen JouKo-laitteeseen vaatii useamman

kuin kolme relettä. Tämä tarkoittaa, että tarvitaan kahden JouKo-laitteen eli

niin kutsutun TuplaJoukon asennus.

JouKo-laitteen releitä ohjataan JouKo-palvelimen kautta etänä. Suunnitellusta

katkosta tulee ilmoitus asiakkaalle ja hänellä on mahdollisuus kieltäytyä kat-

kosta sopimuksesta riippuen. Mikäli sopimuksessa ei ole mahdollisuutta kat-

kon kieltoon, voidaan kyseistä kuormaa ohjata mahdollisesti nopeammin. No-

peampi ohjaus mahdollistaa osallistumisen useammalle Fingridin markkina-

paikalle, jolloin mahdollisuus suurempaan ansaintaan kasvaa.

### 4.4 Ansaintamallit

Ansaintamalleissa olemme keskittyneet Fingridin tällä hetkellä olemassa ole-

viin markkinoihin. Laskelmat perustuvat Fingridin sivuilta löytyvään ansainta-

malliin, jotka ovat laskettu pääasiassa vuoden 2017 keskiarvomarkkinahinnan

mukaisesti. Laskelmilla olemme pyrkineet osoittamaan ylössäädöstä saata-

vissa olevat tuotot. Laitekustannukset asennuksineen on laskettu joustoon tar-

vittavan kotitalousasiakasmäärän mukaisesti. Mitä lyhyempi aktivointiaika

markkinoilla, sen parempiin tuottoihin pystytään pääsemään.

Laskelmissa olemme tehneet seuraavia olettamuksia:

- JouKo – laite on kytketty kodin sähkökäyttöiseen lämmitykseen sekä lämminvesivaraajaan. Lämminvesivaraajan tehoa emme ole huomioineet laskelmissa.
- JouKo-laitteena toimii haja-asutukseen suunniteltu Tupla-JouKo, joka mahdollistaa sen, että kaikki kodin edellä mainitut laitteet saadaan kytkettyä siihen. Kysyntäjoustossa ohjataan siis näitä laitteita. Kyseinen laite käyttää 2G verkkoyhteyttä, hitaamman ja halvemman Lora-verkon sijaan.
- Asunnon lämmityksen kulutus jakautuu vuoden aikana seuraavasti: Joulu – helmikuu → 2 kW
Maalis – toukokuu + syys – marraskuu → 50%:a (2 kW:sta) eli 1 kW Kesä – elokuu → 0 % eli 0kW
Keskiarvo ajalle syyskuu – toukokuu on 1,33 kW ja päiviä 273
- Markkinoille osallistutaan markkinapaikan minimitarjouskoon mukaisella määrällä

Seuraavaksi on esiteltyinä, millaisia ansaintamahdollisuuksia Fingridin eri

markkinapaikoilla on mahdollista saavuttaa.

- FCR-N (3min) korvaus reservin ylläpidosta vuosimarkkinoilla, kun saatava korvaus on 14 e / MWh (v. 2018 markkinahinta) ja oletetaan, että markkinoille osallistutaan 80 %:n tuntimäärällä jokaisena mahdollisena vuorokautena 24 h ajan eli
- 273 vrk x 24 h x 0,8 = 5241 h
- 0,1 MW x 14 e / MWh x 5241 h = 7337 e / vuosi
- 1MW osallistuessa tuotto olisi jopa
1 x 14 e x 5241 h = 73 374 e / vuosi
- FCR-N (3min) korvaus taajuusohjattua käyttöreserviä tuntimarkkinoilla, kun oletetaan, että markkinoille osallistutaan 57 %:n tuntimäärällä edellisestä tuntimäärästä eli
- 5241 h x 0,57 = 2987 h
- 0,1 MW x 27,40 e / MWh x 2987 h = 8184 e / vuosi
- 1 MW osallistuessa tuotto olisi jopa
1 MW x 27,40 e / MWh x 2987 h = 81 843 e / vuosi
- Korvaushintana ollaan käytetty vuoden 2017 tuntimarkkinatoteumahintaa
- Aktivoituneen energian korvausta emme ole laskelmissa huomioineet
- Osallistuessaan näille markkinoille, tulisi asiakkaita olla mukana vähintään 2400, jotta tarvittava 0,1 MWh teho saavutetaan vuorokauden jokaisena tuntina. 0,1 MWh x 24 h = 2,4 MWh = 2400 kW => 2400 asiakasta [4.]
- mFFR (15 min) säätösähkömarkkinat vuoden keskiarvo tuotto
- Minimi tarjouskoko tälle markkinapaikalle on 5 MW, jolloin 1,33 kW keskiarvokulutuksella tarvitsee asiakkaita olla mukana vähintään 3760 asiakasta. Ottaen huomioon se, että maalis – toukokuussa ja syys – marraskuussa saatavilla oleva teho on vain 1kWh / asiakas, tulisi näin ollen mukana olla vähintään 5000 asiakasta.
- Markkinoille osallistutaan kaikkina mahdollisina vuorokausina yhden tunnin ajan eli 273 vrk x 1 h = 273 h. Laskelmassa olemme käyttäneet vuoden 2017 keskiarvo markkinahintaa, jota voitto-osuutta laskiessamme olemme verrannut saman vuoden vuorokausimarkkinan keskihintaan €/MWh eli
37,27 €/MWh - 33,19 € / MWh = 4 € / MWh [3.]
- 1,33 kWh x 5000 asiakasta = 6650 kWh eli 6,65 MWh
- 6,65 MWh x 273 (h) = 1815,45 MWh
- 1815,45 MWh x 37,27 €/MWh = 67 661 € / vuosi (1h säätö / pv)
- Sähkön osto huomioiden, voittoa jää: 1815,45 MWh x 4 e / MWh = 7261 e/v [1.]
- mFFR (15 min) säätösähkömarkkinat osallistuminen tietyille tunneille (ylössäätö), kun tuntihinta ylittää 100 € / MWh
- 5 MW ylössäätötarjous 100 €/MWh hintaan säätösähkömarkkinoille, oletuksena vuoden 2017 toteumat ja tarjouksen hyväksyntä kaikkina tunteina, kun ylössäätöjä on tehty ja säätöhinta on ylittänyt 100 €/MWh (137 kertaa eli 2 % tunneista). Korvaus määräytyy kalleimman hyväksytyn tarjouksen mukaisesti, tälle ajalle yli 100 €/MWh ylössäätöjen keskihinta on ollut 176 €/MWh.
- 273 vrk x 24 h = 6552 h
- 6552 h x 0,02 = 131 h
- 5 MW * 176 €/MWh * 131 h = 115 280 € / vuosi
- Kun huomioidaan sähkön osto, voitto-osuudeksi jää:
Laskelma on tehty käyttäen vuoden 2018 päivän sisäisen markkinan kesä - heinäkuun keskiarvohintojen keskiarvoa eli
48,50 €/MWh x 5 MWh x 131 h = 31 767 € / vuosi, jolloin voittoosuus on 115 280 € - 31 767 € = 83 513 € / vuosi
- Laskelmassa emme ole huomioineet sitä, että hinta saattaa olla korkea (yli 100 € / MWh) monta tuntia peräkkäin. Tällöin ei välttämättä voida kaikilla tunneilla osallistua.
- Laskelmissa olemme myös olettaneet, että kalliit tunnit jakautuvat tasaisesti koko vuoden ajalle.
- Laskelmat perustuvat Fingridin sivuilta löytyvään ansaintamalliin [4.]
- Päivän sisäisen markkinan (Elbas 1h) minimitarjouskoko on 0,1 MW. Olemme laskeneet tuoton käyttäen samaa asiakaspotentiaalia kuin yllä mainituilla markkinoilla eli 5000 asiakasta 1,33 kW teholla. Säätöä tehdään jokaisena mahdollisena vuorokautena (273 vrk) yhden tunnin ajan.
- 6,65 MWh x 273 h = 1815,45 MWh
- 1815,45 MWh x 48,50 € / MWh = 88 049 € / vuosi
- Laskelma on tehty käyttäen vuoden 2018 päivän sisäisen markkinan kesä – heinäkuun keskiarvohintojen keskiarvoa.
- Laskelmassa emme ole huomioineet seuraavien tuntien kulutuspiikkiä. [1.]
- Vuorokausimarkkina (Elspot 12h) minimitarjouskoko on 0,1 MW, joten laskelmassa käytetään samaa olettamusta kuin päivän sisäisessä markkinassa. Tuoton laskennassa tuntikorvaushintana toimii vuoden 2017 keskiarvo markkinahinta eli 33,19 €/MWh.
- 6,65 MWh x 273 h = 1815,45 MWh
- 1815,45 MWh x 33,19 € / MWh = 60 254 € / vuosi
- Laskelmassa emme ole huomioineet seuraavien tuntien kulutuspiikkiä [1.]
- Laitteen valmistushinta asennuksineen 5000 asiakkaalle, kun kyseessä on TuplaJouKon haja-asutusversio.
- Laite 5000 asiakasta x 150 € / laite = 750 000 € ja asennus 5000 asiakasta x 100 € / laiteasennus = 500 000 €, joka on yhteensä 1 250 000 €
- Asiakaskuntaa hankkiessa tulisi huomioida se, että kaikki asiakkaat eivät välttämättä osallistu / pysty osallistumaan joustoon (n. 25%). Näin ollen todelliset laitekustannukset tulevat olemaan kalliimmat.
- Jos asiakastarve jouston piiriin on 5000 asiakasta, todellisuudessa asiakkaita tulisi olla tällöin 25%:a enemmän eli
5000 / 0,75 = 6667 asiakasta, jotta haluttu jousto saavutetaan Asennus + TuplaJouko 6667 asiakkaalle
666 700 e + 1 000 050 e = 1 666 750 €

### 4.5 Asiakassegmentit

Suunnittelimme JouKo-palvelulle seuraavat asiakassegmentit: Passiivinen-,

osittain aktiivinen ja aktiivinen asiakas. Passiiviselle asiakkaalle sähkömyynti-

yhtiö tai aggregaattori maksaa laitteen asennuksen hänen kotiin. Asiakas lu-

pautuu sähköyhtiön katkoihin, eikä hän voi halutessaan kieltäytyä niistä. Hän

ei voi myöskään itse suorittaa katkoja. Hinnoittelumallina tässä asiakasmal-

lissa toimii kiinteähintainen kuukausimaksu ja kiinteä alennus kysyntäjoustoon

osallistumisesta. Tämä tekee laskutuksesta asiakkaalle helposti ymmärrettä-

vän sekä sähkömyyntiyhtiölle helposti toteutettavan.

Osittain aktiivisessa asiakasmallissa sähkömyyntiyhtiö tai aggregaattori mak-

saa laitteen asennuksen. Asiakas lupautuu sähköyhtiön katkoihin, mutta hän

voi halutessaan myös kieltäytyä niistä. Tässäkään sopimusmallissa asiakas ei

voi itse suorittaa katkoja. Hinnoittelumallina tässä asiakastyypissä toimii kiin-

teähintainen kuukausimaksu ja kiinteä alennus kysyntäjoustoon osallistumi-

sesta. Mikäli asiakas kuitenkin kieltäytyy asetetuista katkoista, ei alennusta

tule ja hän saa sanktiona jopa lisämaksua.

Aktiivisessa asiakasmallissa asiakas maksaa itse laitteen asennuksen ko-

tiinsa. Asiakas lupautuu sähköyhtiön katkoihin, mutta hän voi halutessaan

myös kieltäytyä niistä. Tässä sopimusmallissa asiakas voi suoritta myös itse

katkoja. Asiakas saa alennusta sähkölaskusta kiinteän alennuksen verran. Tä-

hän sopimusmalliin suositellaan pörssisähköön perustuvaa tuntihinnoittelua,

sillä se kannustaa seuraamaan pörssihintaa ja katkomaan kalleimmat tunnit

pois. On kuitenkin huomioitavaa, että peräkkäisissä katkoissa sähköyhtiön tai

aggregaattorin asettamat katkot menevät etusijalle. Asiakkaan itseasettama

katko ei saa estää näiden yhtiöiden katkoja. Mikäli asiakas kieltäytyy kaikista

asetetuista katkoista, ei alennusta tule ja hän voi jopa saada lisämaksua.

### 4.6 Sähköauton latauksen ohjaus

Kesän aikana havaitsimme, että Fingridin markkinoilta saatava tuotto lämmi-

tyksen ja lämminvesivaraajan kysyntäjoustosta ei ole kovin merkittävä inves-

tointeihin nähden. Pohdinnoissa ja haastatteluissa kävi ilmi, että mikäli sähkö-

autot lisääntyvät, kotitalouksien ja taloyhtiöiden sähköliittymien kapasiteetin raja alkaa tulla vastaan. Aloimme tutkimaan voisiko JouKo-laitetta hyödyntää

sähköauton latauksen ohjauksessa. Seuraavissa kappaleissa ovat esimerkit

sähköauton latauksen ohjauksesta omakotitalossa ja taloyhtiöissä.

JouKo-laitteita asennetaan 1-2 kpl taloon, riippuen käyttääkö latauslaite 1-

vaihe vai 3-vaihe sähköä. Laitteeseen kytketään sähköauton latauslaitteen li-

säksi lämmitys. Applikaation avulla määritetään, milloin sähköauton akun ha-

lutaan olevan täysi, esimerkiksi klo 07:00. JouKo-laite vuorottelee sähköauton

ja lämmityksen välillä, jotta huipputeho tai yhden vaiheen kuormitus ei nouse

liian korkeaksi. Sähkömittariin kytkettävä kulutuksen mittauslaite helpottaisi

kodin kokonaiskulutuksen ohjausta. Vastaavasti tiedot voitaisiin saada Data-

hubin kautta. Tämän avulla voidaan asentaa latureita tai tehokkaampia latu-

reita asuntoihin, joiden kapasiteetti ei meinaa riittää. Tämä suosisi myös teho-

perusteiseen mittaukseen siirryttäessä, koska talon huipputehoa rajoitettai-

siin. Vaihtoehtoisesti laitteeseen voitaisiin kytkeä liesi/uuni/kiuas ja sähköauto.

Kun joku kyseisistä laitteista menee päälle, sähköauton laturi menee pois

päältä. Ja näin hetkellinen huipputeho ei pääse nousemaan liian korkeaksi.

Taloyhtiöissä ohjaus voisi tapahtua seuraavasti. JouKo-laitteita asennetaan

tarpeen mukainen määrä. Asukas määrittää applikaation avulla, mihin aikaan

sähköauton akun tulee olla täynnä. Palvelin ohjaa ja vuorottelee latauksia eri

latauspaikkojen välillä. Palvelimen sekä laturin välille olisi hyvä saada raja-

pinta, josta selviäisi akun varauksen taso. Näin pystyttäisiin priorisoimaan mitä autoa ladataan ensimmäisenä. Älykkäämmäksi latausjärjestelmästä tekisi

vielä mahdollinen tieto tai analyysi käyttäjäprofiilista. Käytetäänkö jotakin au-

toa enemmän kuin toista eli tarvitseeko auton akun olla edes täysi joka kerta.

Taloyhtiössä voitaisiin myös käyttää niin kutsuttua Bufferakustoa. Tätä akus-

toa ladattaisiin jatkuvasti niin suurella teholla kuin taloyhtiön kapasiteetti antaa

periksi ja akustosta syötettäisiin virtaa edelleen latureihin. Tämä mahdollistaisi

taloyhtiön kapasiteettia suuremmalla teholla lataamisen.

### 4.7 Kilpailija-analyysi

Yksi kesän työtehtävistä oli analysoida mahdollisia kilpailijoita. Merkittävimmät

kilpailija JouKo-laitteelle ja palvelulle ovat There Corporationin kehittämä Z-

wave teknologiaan perustuva kodin energianhallintajärjestelmä sekä OptiWatti kodin energianhallintajärjestelmä. Molemmat järjestelmät ovat JouKo-laitetta

huomattavasti kalliimpia, mutta asiakkaan saama arvo laitteistosta on niin

suuri, että asiakkaat ovat valmiita maksamaan laitteiston itse.

### 4.7.1 There Corporation

There Corporationin järjestelmää kauppaa muun muassa Fortum ja Karhu

Voima. Fortumilla palvelu on Fortum Fiksu sähkölämmittäjälle. Laitteisto sisäl-

tää ohjausyksikön, lämmityksen ohjauskytkimiä (releitä), lämpömittarin ja lisä-

hinnasta ilmalämpöpumpun IR-ohjaimen. [17.]

Ohjausyksikkö ohjaa kodin lämmitystä ja seuraa kodin lämpötilaa langatto-

masti ohjauslaitteiden avulla. Tämän lisäksi ohjausyksikkö on yhteydessä For-

tumin etäpalveluihin ja käyttöliittymään, josta se saa lämmitys-, sää- ja hinta-

tiedot sekä käyttäjäasetukset. Ohjausyksikkö käyttää kodin internetyhteyttä

langallisesti tai langattomasti. Lämmityksen ohjauskytkimet kytkevät suoran

sähkölämmityksen varaavan lattialämmityksen sekä lämminvesivaraajan

päälle ja pois annettujen ohjauskomentojen mukaisesti. Ohjauskytkimet asen-

netaan kodin sähkökeskukseen. Lämpötilamittari mittaa sähkölämmitystä sekä

mahdollista ilmalämpöpumpun asetuslämpötilaa varten kodin lämpötilaa. Ilma-

lämpöpumpun IR-ohjain ohjaa ilmalämpöpumpun asetuslämpötilaa ja se

asennetaan lähelle sitä. [17.]

Lämmitykselle voi antaa eri tavoitelämpötilan kodin eri tilanteille (kotona,

poissa, yö tai pitkään poissa). Näin lämpötilaa pystytään laskemaan asun-

nossa ja luomaan säästöjä asumismukavuutta huonontamatta, kun taloa ei

lämmitetä tarpeettomasti. Käyttöliittymä huomioi sähkön tuntihinnat lämmityk-

sessä ja luo säästöä myös tätä kautta. [17.]

### 4.7.2 OptiWatti

OptiWatti-laitteiston voi ostaa OptiWatin omilta sivuilta tai Helenin sivuilta säh-

kösopimuksen yhteydessä. OptiWatti-laitteisto ei ole sidottu mihinkään tiettyyn

sähköyhtiöön. Laitteisto sisältää keskusyksikön, langattomia releitä joilla ohjataan lämmittimiä, lämminvesivaraajan ohjaimen, lämpötilamittareita sekä lisä-

hinnasta ilmalämpöpumpun ohjauksen, vuotovahdin ja autonlämmityksen oh-

jauksen. [16.]

Keskusyksikkö ohjaa lämmitystä ja muodostaa yhteyden internettiin. Internet

yhteys muodostetaan Ethernet-kaapelilla tai OptiWatin kautta tilattavalla netti-

tikulla. Keskusyksikkö ohjaa releitä, ilmalämpöpumpun infrapunalähetintä ja

kerää anturitietoja langattomasti. Käytettävä taajuus on 868,8 MHz. Keskusyk-

sikkö mittaa antureiden avulla jatkuvasti huonekohtaista lämpötilaa ja huo-

neen lämmittämiseen kuluvaa energiaa. Datan perusteella laite oppii kuinka

kauan eri lämpötilojen saavuttaminen kestää. Huoneen datan lisäksi huomioi-

daan ulkolämpötila sekä sääennuste. [16.]

Releiden katkaisukyky on 2300W/230V=10A. Releet sijoitetaan lämmityslait-

teen kytkentärasiaan patterin taakse, lattialämmitystermostaatin taakse koje-

rasiaan tai sähkökeskukseen. Jokaiseen lämmittimeen tarvitaan oma rele.

Rele ohjaa lämmityslaitteeseen menevää sähkövirtaa keskusyksikön anta-

mien käskyjen mukaisesti. Kun huoneen lämpötila on käyttäjän määrittele-

mällä tasolla, rele sulkee sähkönsyötön lämmityslaitteeseen. Lämpötila-anturit

mittaavat huoneen lämpötilaa sekä kosteutta. Jokaiseen huoneeseen asenne-

taan oma mittari. [16.]

Lämminvesivaraajalle voidaan valita lämmitykseen tietyt tunnit. Mikäli käy-

tössä on pörssisähkö, laite hakee automaattisesti halvimmat tunnit. Lämmin-

vesivaraajan rele soveltuu ohjaamaan 1-vaiheen kuormaa. Lämminvesivaraa-

jan ohjaus edellyttää, että varaajan sähkönsyötössä on oltava kontaktori, jota

releellä ohjataan. Sellainen on mahdollista lisätä muun asennuksen yhtey-

dessä. OptiWatti ei mittaa veden lämpötilaa eikä veden lämmitysenergian ku-

lutusta. Varaajan oma termostaatti vastaa veden lämpötilan säädöistä. [16.]

Ilmalämpöpumppua ohjataan IR-lähettimen avulla. Muut lämmityslaitteet kyt-

keytyvät automaattisesti pois, kun ilmalämpöpumppu viilentää. Autonlämmi-

tykselle määritetään kellonajat, jolloin auton halutaan olevan lämmin. Laite

huomioi ulkolämpötilan ja ajoittaa lämmityksen siten, että auto on lämmin ha-

luttuna ajankohtana. Laitteeseen voidaan myös kytkeä langattomia vesivuo-

don tunnistavia antureita. [16.]

Keskusyksikköön on tallennettu jokaisen huoneen viikko-ohjelma. Jos inter-

net-yhteys katkeaa, laite ohjaa huoneen lämmitystä viimeisimpien asetusten

mukaan ja tarkistaa asetukset internet-yhteyden palattua ja ottaa uudet ase-

tukset tarvittaessa käyttöön. Järjestelmän tietoliikenneyhteydet suojataan pan-

keista tutulla salaustekniikalla. [16.]

### 5 YHTEENVETO

Projektissa tehtävänamme oli selvittää JouKo – laitteen mahdollisuuksia koti-

talouksille suunnatussa kysyntäjoustopalvelussa. Taustateorian tueksi haas-

tattelimme kuutta hankkeessa mukana olevaa yhtiöitä, sekä pyrimme selvittä-

mään heidän vaatimukset ja tarpeet kyseiselle palvelulle. Vastaukset olivat hy-

vin yhtenäisiä, joiden avulla oli helppo lähteä rakentamaan liiketoimintamallia

palvelun ympärille. Myös kyseisen palvelun tarve kotitalousasiakkaita hyödyn-

täen korostui.

Yhdeksi suureksi haasteeksi kysyntäjoustopalvelussa nousi kuitenkin kotita-

lousasiakkaiden sitouttaminen ja saaminen palvelun piiriin sekä se, että liike-

toiminnasta jäävä tuotto on varsinkin alkuvaiheessa hyvin pieni. Osallistumi-

nen kysyntäjoustomarkkinoille vaatii alkuun suuria investointeja, joiden takai-

sinmaksuaika on hyvin pitkä. Yhtiöt näkivätkin tämän palvelun ennemminkin

muun liiketoimintansa tukena, jolla saataisiin sitoutettua asiakkaat pidemmäksi

ajaksi. Kilpailun kiristyessä nämä keinot ovat ensiarvoisen tärkeitä. Myös li-

sääntyvä kulutus sekä sähköverkon kapasiteetin riittävyys tukevat tällaista

markkinamallia. Optimoimalla kotitalousasiakkaiden sähkön käyttöä voidaan

saavuttaa molemminpuolinen hyöty.

Palavereissa ja haastatteluissa tuli myös esille se, että täyttääkö JouKo-laite

Fingridin teknisiä vaatimuksia eri markkinapaikoille osallistumiseen kuten te-

hon leikkaamisen todentaminen. Fingrid vaatii, että leikatun tehon määrä pitää

pystyä todentamaan. Tästä emme ole Fingridin kanssa keskustelleet vielä ja

suosittelemmekin, että se on yksi projektin vaiheista jatkossa. Suosittelemme

myös JouKo-laitteen taajama-version hylkäämistä ja keskittymistä vain no-

peimpiin gsm-versioihin.

Jatkotutkimuksena ehdotamme kotitalousasiakkaille muodostuvan arvon tutki-

mista sekä heidän sitouttamista kysyntäjousto palveluun. Myös sähköauton la-

tauksen ohjaamisesta olisi hyvä tehdä lisätutkimuksia esimerkiksi latureiden

soveltuvuuksista sekä mahdollisen akuston asentamisesta taloyhtiöihin. Näitä

varten olisi hyvä tehdä haastatteluita niin kotitalouksien kuin taloyhtiöidenkin

keskuudessa.

Kysyntäjoustoon osallistuminen voitaisiin tehdä asiakkaalle myös houkuttele-

vammaksi. Laite ohjaisi lämmitystä pörssisähköön perustuen niin, että se kat-

koisi automaattisesti kalleimmat tunnit pois ja kytkisi lämmityksen päälle vasta

halvemmilla tunneilla. Mikäli laitetta ja sen ominaisuuksia kehitettäisiin enem-

män asiakaslähtöisiksi, asiakkaiden kiinnostus laitetta kohtaan kasvaisi ja he

olisivat jopa valmiita maksamaan sen itse.

LÄHTEET

Kirjoita tähän oma lähdeluettelosi. Alla on esimerkkejä Harvard-mallisesta läh-

deluettelosta. Lähteisiin viittaaminen esitellään lähdemerkintäohjeessa.

1.Fingrid (2018): Markkinapaikat. Viitattu [27.8.2018] https://www.fingrid.fi/sahkomarkkinat/kysyntajousto/markkinapaikat/. (https://www.fingrid.fi/sahkomarkkinat/kysyntajousto/markkinapaikat/)

2.Työ ja elinkeinoministeriö: Kysymyksiä ja vastauksia älykkäästä sähköjärjes-

telmästä. Viitattu [27.8.2018] https://tem.fi/perustietoja

3. NordPool (2018). Day-ahead prices. Viitattu [28.8.2018] https://www.nordpoolgroup.com/Market-data1/Dayahead/Area-Prices/FI/Yearly/?view=table. (https://www.nordpoolgroup.com/Market-data1/Dayahead/Area-Prices/FI/Yearly/?view=table)
4. Fingrid: Ansaintamallit. Viitattu [28.8.2018] https://www.fingrid.fi/sahkomark-

kinat/reservit-ja-saatosahko/kuinka-osallistua-reservimarkkinoille/ansaintamal-

lit/. (https://www.fingrid.fi/sahkomarkkinat/reservit-ja-saatosahko/kuinka-osallistua-reservimarkkinoille/ansaintamallit/)

5. Fingrid: Taajuusohjattu käyttö- ja häiriöreservi.Viitattu [28.8.2018] https://www.fingrid.fi/sahkomarkkinat/reservit-ja-saatosahko/taajuusohjattukaytto--ja-hairioreservi/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 (https://www.fingrid.fi/sahkomarkkinat/reservit-ja-saatosahko/taajuusohjattu-kaytto--ja-hairioreservi/)
6. Fingrid: Reservituotteet ja reservien markkinapaikat. Viitattu [28.8.2018]

https://www.fingrid.fi/globalassets/dokumentit/fi/sahkomarkkinat/reservit/reser-

vituotteet.pdf. (https://www.fingrid.fi/globalassets/dokumentit/fi/sahkomarkkinat/reservit/reservituotteet.pdf)

7. Nord Pool: See what Nord Pool can offer you. Viitattu [28.8.2018] https://www.nordpoolgroup.com/
8. Smart energy transition: Miten sähkömarkkinat toimivat. Viitattu [28.8.2018]

http://smartenergytransition.fi/fi/miten-sahkomarkkinat-toimivat/

9. Smart Energy Transition. Kysyntäjousto ja varastot markkinoille hinnoittelun

ja verotuksen uudistuksilla. Viitattu [29.8.2018] http://smartenergytransi-

tion.fi/fi/kysyntajousto-ja-varastot-markkinoille-hinnoittelun-ja-verotuksen-uu-

distuksilla/. (http://smartenergytransition.fi/fi/kysyntajousto-ja-varastot-markkinoille-hinnoittelun-ja-verotuksen-uudistuksilla/)

10. Fingrid (2018). Suomen ja Ruotsin kantaverkkoyhtiöt etenevät uuden siir-

toyhteyden rakentamisessa – tavoitteena saada yhteys käyttöön vuoteen

2025 mennessä. Viitattu [29.8.2018] https://www.fingrid.fi/sivut/ajankoh-

taista/tiedotteet/2016/suomen-ja-ruotsin-kantaverkkoyhtiot-etenevat-uuden-

siirtoyhteyden-rakentamisessa--tavoitteena-saada-yhteys-kayttoon-vuoteen-

2025-mennessa/. (https://www.fingrid.fi/sivut/ajankohtaista/tiedotteet/2016/suomen-ja-ruotsin-kantaverkkoyhtiot-etenevat-uuden-siirtoyhteyden-rakentamisessa--tavoitteena-saada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)

11. Nurmi. Simo (2018). Välttämättömyydestä mahdollisuudeksi. Reilua Ener-

giaa. Viitattu [29.8.2018] https://www.energiavirasto.fi/reilua-energiaa/-

/blogs/valttamattomyydesta-mahdollisuudeksi;jsessio-

nid=0CC9DDD2C91C767BB301EE9418F1512A?_33_redi-

rect=https%3A%2F%2Fwww.energiavirasto.fi%2Freilua-energiaa%3Bjsessio-

nid%3D0CC9DDD2C91C767BB301EE9418F1512A%3Fp_p_id%3D33%26p_

p_lifecycle%3D0%26p_p_state%3Dnor-

mal%26p_p_mode%3Dview%26p_p_col_id%3Dcolumn-

3%26p_p_col_pos%3D1%26p_p_col_count%3D3. (https://www.energiavirasto.fi/reilua-energiaa/-/blogs/valttamattomyydesta-mahdollisuudeksi;jsessionid=0CC9DDD2C91C767BB301EE9418F1512A)

12. Hirvonen, Ritva (2015). Suomen energiavisio 2030. Viitattu [29.8.2018] https://www.vtt.fi/files/projects/energy_book_series/ev_2030_tiivistelma.pdf
13. https://www.fingrid.fi/sahkomarkkinat/reservit-ja-saatosahko/saatosahko--ja-saatokapasiteettimarkkinat/
14. Energiateollisuus. Kohti älykästä energiajärjestelmää [Viitattu 29.8.2018]

https://energia.fi/energiateollisuuden_edunvalvonta/energiapolitiikka/energia-

verkot (https://energia.fi/energiateollisuuden_edunvalvonta/energiapolitiikka/energiaverkot)

15. Lappeenrannan energia oy. Sähkön hinnan muodostuminen. Viitattu

[29.8.2018] https://www.lappeenrannanenergia.fi/tuotteet/hinnas-

tot%20ja%20ehdot/sahkohinnasto/Sivut/Sähkön%20hinnastot%20ja%20eh-

dot.aspx.

16. OptiWatti. Viitattu [30.8.2018] https://www.optiwatti.fi/
17. Fortum Fiksu sähkölämmittäjälle. Viitattu [30.8.2018]

http://docplayer.fi/3143545-Fortum-fiksu-sahkolammittajalle.html

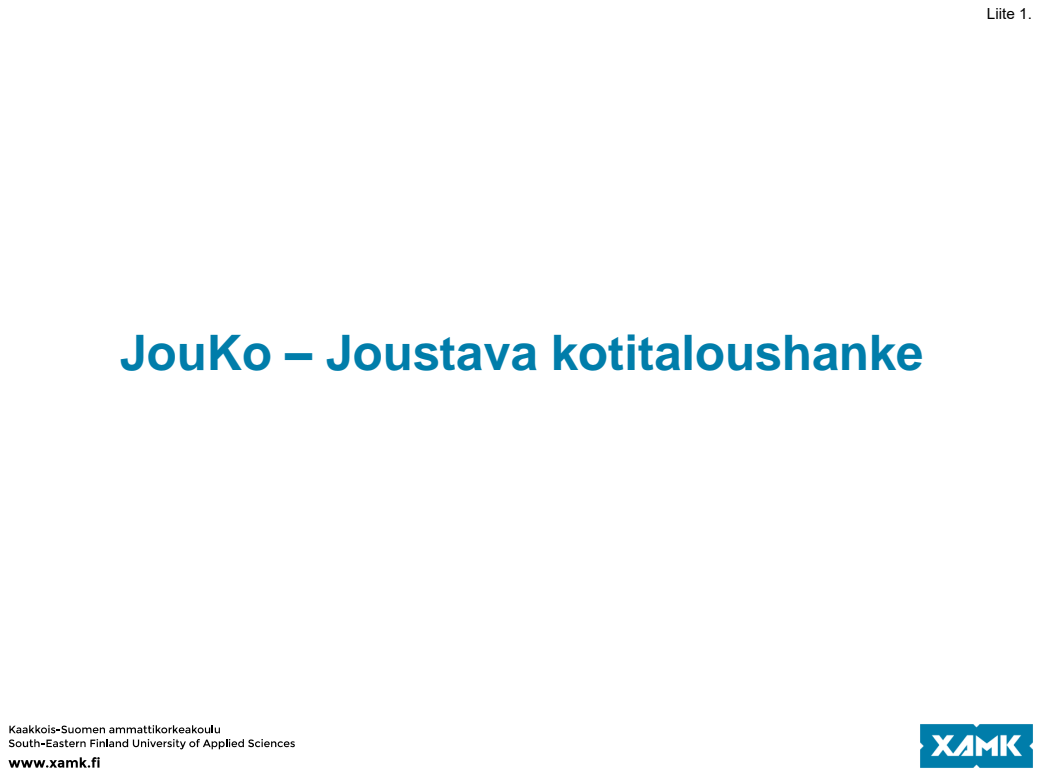
[picture p12: page 31]
Liite 1.

JouKo – Joustava kotitaloushanke

# Sisällys

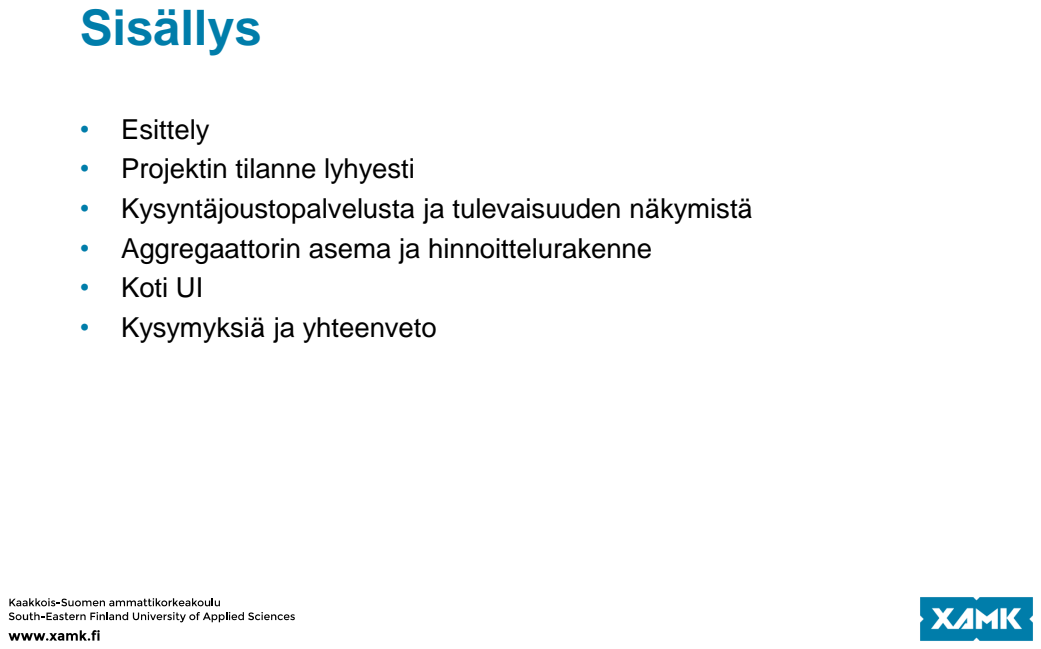
[picture p13: page 32]

• Esittely
• Projektin tilanne lyhyesti
• Kysyntäjoustopalvelusta ja tulevaisuuden näkymistä
• Aggregaattorin asema ja hinnoittelurakenne
• Koti UI
• Kysymyksiä ja yhteenveto

# Esittely

## Henkilöt: - Marjo Puikkonen (tietojärjestelmätieteiden, kauppatieteen maisteriopiskelija) ja Roope Raati (sähkötekniikan insinööriopiskelija) Projekti:

- JOUKO-hanke kehittää ratkaisuja, joiden avulla voidaan toteuttaa uudenlainen joustava sähkösopimus ja käyttää sitä myös jo rakennetuissa kodeissa. Kytkinlaite voi kytkeä sähkön syötön pois sähkösopimuksen perusteella myös kolmivaihelaitteilta, kuten kiukailta.
- Hanke kehittää sekä laitteistoja, ohjelmistoja, sähköisiä palveluja että liiketoimintamalleja.
- Kehitetään kodeissa käytettävät laitteet, joilla voidaan etäohjata/kytkeä 3-vaihevirran kulkua. Langattomat laitteet voidaan asentaa jo olemassa oleviin kotiympäristöihin ilman tietoliikennekaapelointeja.
– Malleja eri osapuolten välisiin sopimuksiin, jotta kysyntäjousto voidaan toteuttaa. – Kotiasiakkaan mobiilipalvelu, jolla hän hallitsee kotinsa helposti laitteiden kysyntäjoustoa.
– Ohjattavien laitteiden energiankulutusmittauksen, joka mahdollistaa seurantaa ja päätöksentekoa.
- Verkkopalvelun, joka palvelee aggregaattoriyhtiötä (joka kokoaa kodeista kysyntäjoustoryppäitä) , sähkön kantaverkkoyhtiötä sekä energiayhtiöitä. Koko järjestelmässä kiinnitetään huomiota erityisesti tietoturvaan.

# Projektin tilanne

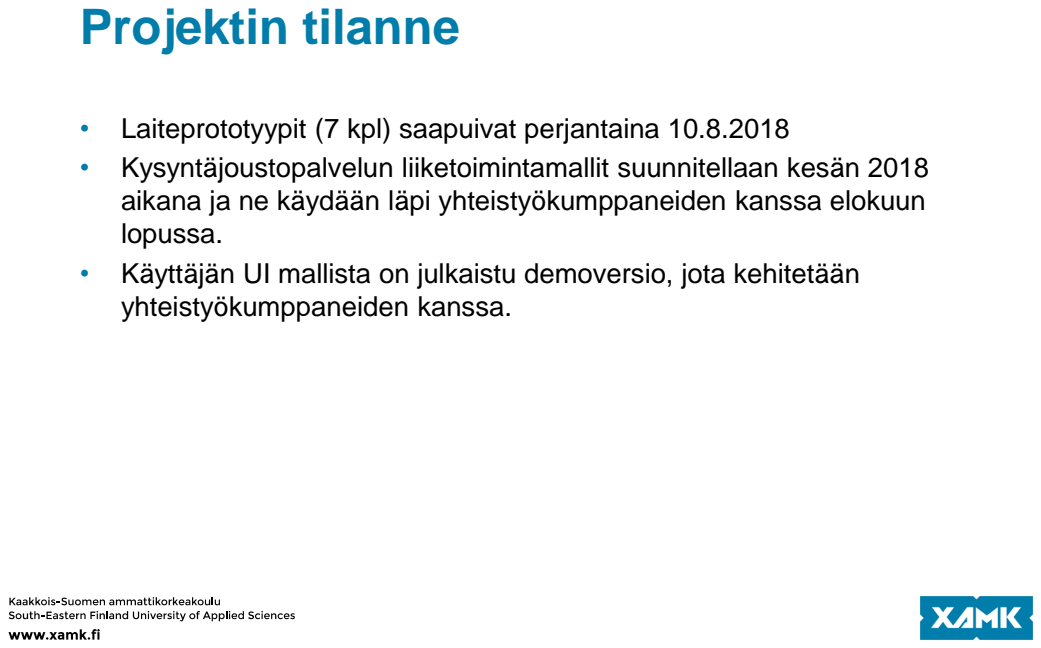
[picture p14: page 34]

• Laiteprototyypit (7 kpl) saapuivat perjantaina 10.8.2018
• Kysyntäjoustopalvelun liiketoimintamallit suunnitellaan kesän 2018
aikana ja ne käydään läpi yhteistyökumppaneiden kanssa elokuun
lopussa.
• Käyttäjän UI mallista on julkaistu demoversio, jota kehitetään
yhteistyökumppaneiden kanssa.

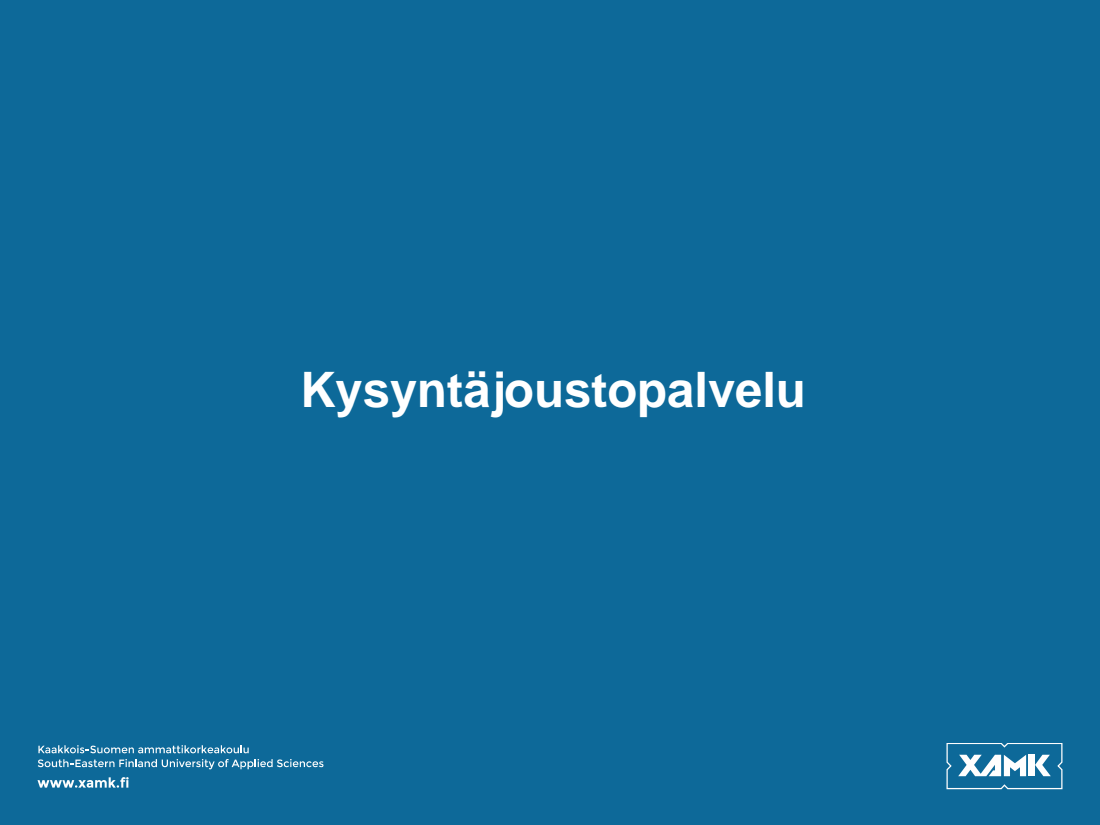
[picture p15: page 35]
Kysyntäjoustopalvelu

# Kysyntäjoustopalvelun mahdollisuudet lähitulevaisuudessa?

## - Millaisiin tarpeisiin sähköyhtiöt tarvitsevat kysyntäjoustopalvelua? - Miten lyhyt säätöviiveen tulisi olla, jotta firmat voisiva vastata

sähköyhtiöiden tarjouspyyntöihin? Miten näette hitaan, 32 min tai yli,

kysyntäjouston mahdollisuudet? - Onko tulevaisuudessa mahdollista, että tulisi uusi kysyntäjoustolle suunnattu tarjouspyyntötyyppi? – Jos löytyy uusi tai olemassa oleva tarjouspyyntötyyppi, johon voi vastata JouKo-palvelulla, pitääkö silloin olla valmis myös myymään lisäkulutusta? - Onko tällä hetkellä olemassa sähkömyyntiyhtiöillä oma markkinapaikka JouKo:n kaltaiselle laitteelle?

# Kysyntäjoustopalvelun mahdollisuudet lähitulevaisuudessa?

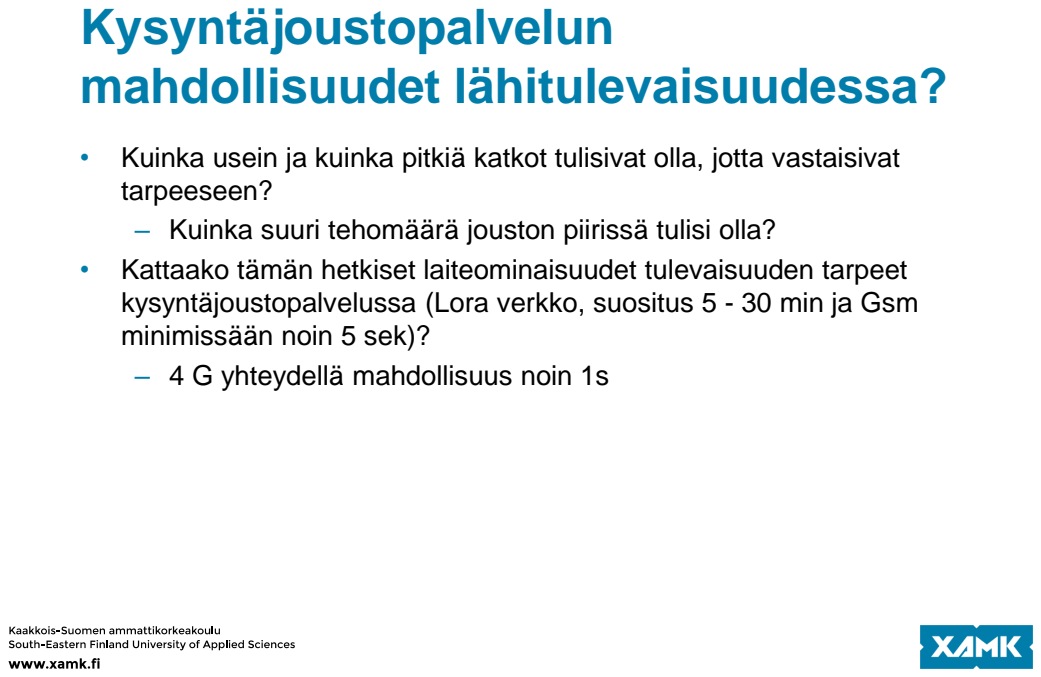
[picture p16: page 37]

• Kuinka usein ja kuinka pitkiä katkot tulisivat olla, jotta vastaisivat
tarpeeseen?
– Kuinka suuri tehomäärä jouston piirissä tulisi olla?
• Kattaako tämän hetkiset laiteominaisuudet tulevaisuuden tarpeet
kysyntäjoustopalvelussa (Lora verkko, suositus 5 - 30 min ja Gsm
minimissään noin 5 sek)?
– 4 G yhteydellä mahdollisuus noin 1s

# Aggregaattorin asema ja hinnoittelurakenne?

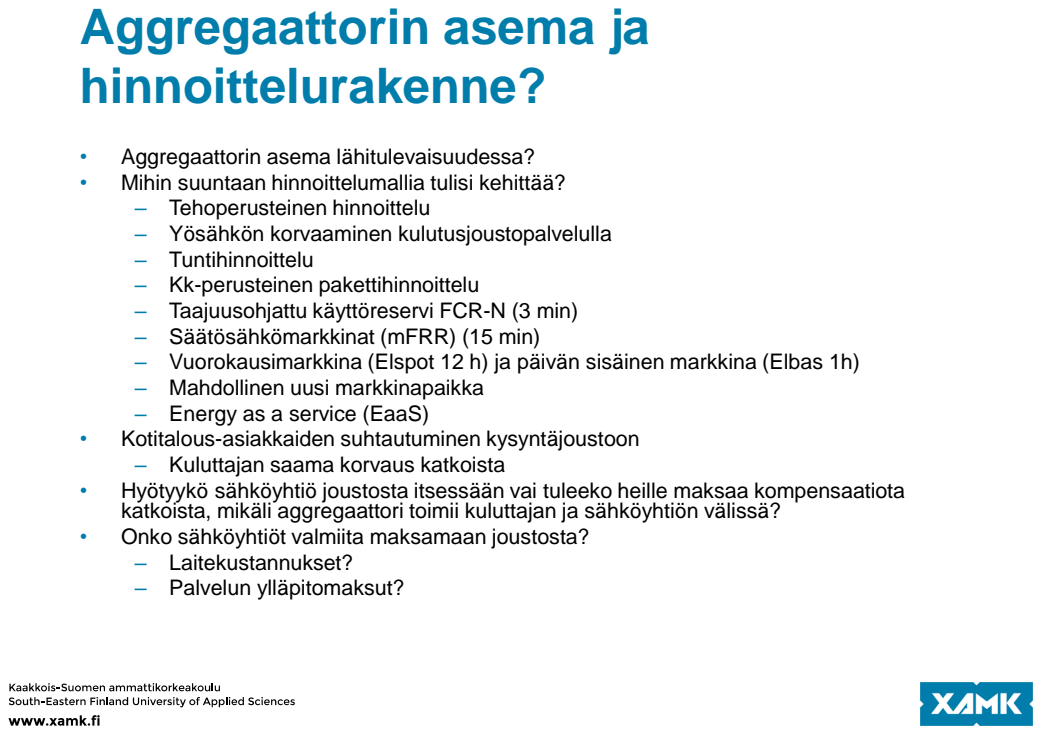
[picture p17: page 38]

• Aggregaattorin asema lähitulevaisuudessa?
• Mihin suuntaan hinnoittelumallia tulisi kehittää?
– Tehoperusteinen hinnoittelu
– Yösähkön korvaaminen kulutusjoustopalvelulla
– Tuntihinnoittelu
– Kk-perusteinen pakettihinnoittelu
– Taajuusohjattu käyttöreservi FCR-N (3 min)
– Säätösähkömarkkinat (mFRR) (15 min)
– Vuorokausimarkkina (Elspot 12 h) ja päivän sisäinen markkina (Elbas 1h)
– Mahdollinen uusi markkinapaikka
– Energy as a service (EaaS)
• Kotitalous-asiakkaiden suhtautuminen kysyntäjoustoon
– Kuluttajan saama korvaus katkoista
• Hyötyykö sähköyhtiö joustosta itsessään vai tuleeko heille maksaa kompensaatiota
katkoista, mikäli aggregaattori toimii kuluttajan ja sähköyhtiön välissä?
• Onko sähköyhtiöt valmiita maksamaan joustosta?
– Laitekustannukset?
– Palvelun ylläpitomaksut?

# BMC - Aggregaattori

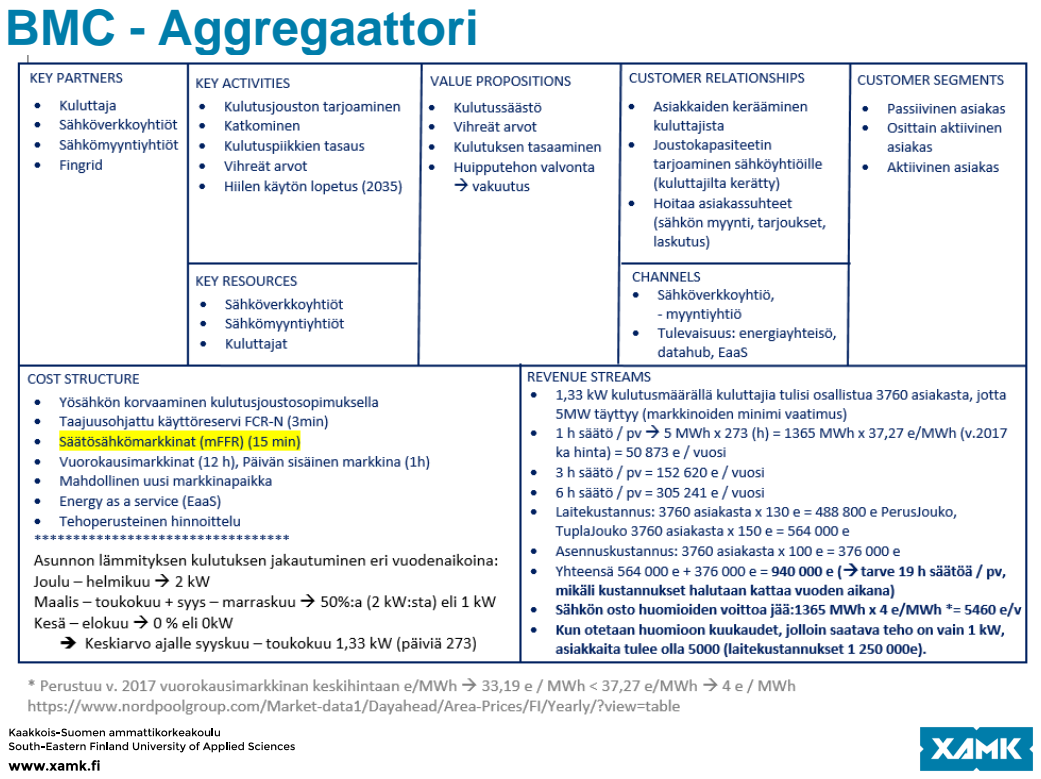
[picture p18: page 39]

# FCR-N taajuusohjattu käyttöreservi

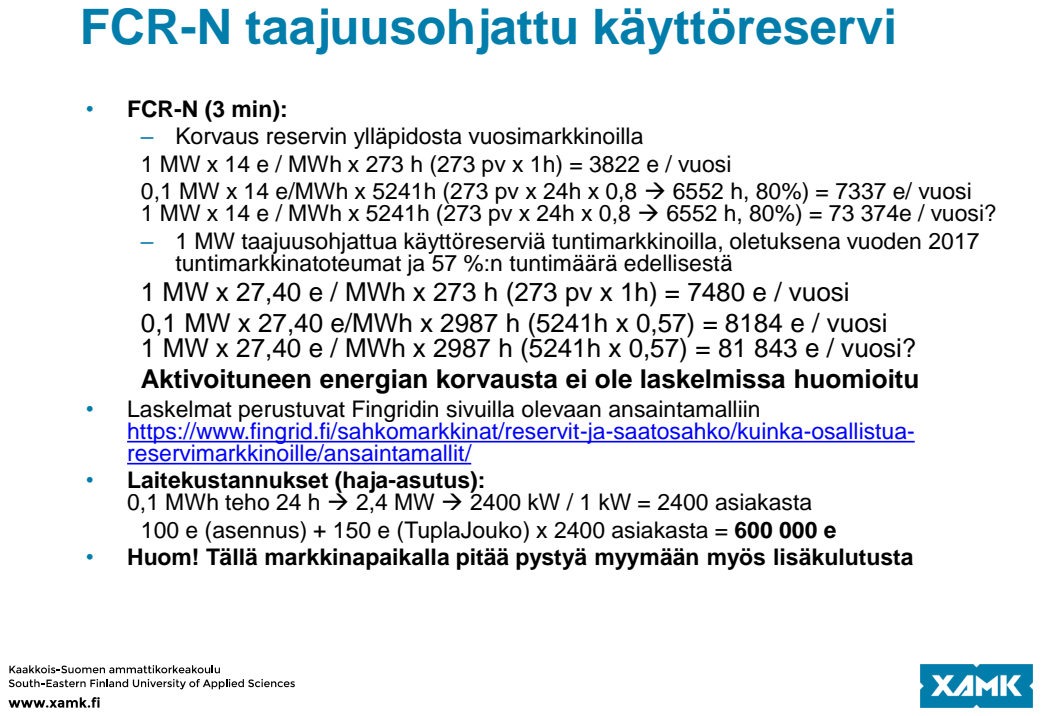
[picture p19: page 40]

• FCR-N (3 min):
– Korvaus reservin ylläpidosta vuosimarkkinoilla
1 MW x 14 e / MWh x 273 h (273 pv x 1h) = 3822 e / vuosi
0,1 MW x 14 e/MWh x 5241h (273 pv x 24h x 0,8 → 6552 h, 80%) = 7337 e/ vuosi
1 MW x 14 e / MWh x 5241h (273 pv x 24h x 0,8 → 6552 h, 80%) = 73 374e / vuosi?
– 1 MW taajuusohjattua käyttöreserviä tuntimarkkinoilla, oletuksena vuoden 2017
tuntimarkkinatoteumat ja 57 %:n tuntimäärä edellisestä
1 MW x 27,40 e / MWh x 273 h (273 pv x 1h) = 7480 e / vuosi
0,1 MW x 27,40 e/MWh x 2987 h (5241h x 0,57) = 8184 e / vuosi
1 MW x 27,40 e / MWh x 2987 h (5241h x 0,57) = 81 843 e / vuosi?
Aktivoituneen energian korvausta ei ole laskelmissa huomioitu
• Laskelmat perustuvat Fingridin sivuilla olevaan ansaintamalliin
https://www.fingrid.fi/sahkomarkkinat/reservit-ja-saatosahko/kuinka-osallistua-
reservimarkkinoille/ansaintamallit/ (https://www.fingrid.fi/sahkomarkkinat/reservit-ja-saatosahko/kuinka-osallistua-reservimarkkinoille/ansaintamallit/)
• Laitekustannukset (haja-asutus):
0,1 MWh teho 24 h → 2,4 MW → 2400 kW / 1 kW = 2400 asiakasta
100 e (asennus) + 150 e (TuplaJouko) x 2400 asiakasta = 600 000 e
• Huom! Tällä markkinapaikalla pitää pystyä myymään myös lisäkulutusta

# mFFR, Elbas ja Elspot - markkinat

- mFFR (15 min):
– | 1,33 kW / asiakas→ 5000 asiakasta → 6,65 MWh x 273 (h) = 1815,45 MWh
– | 1815,45 MWh x 37,27 e/MWh (v.2017 ka hinta) = 67 661 e / vuosi (1h säätö / pv)
– | Sähkön osto huomioiden, voittoa jää: 1815,45 MWh x 4 e / MWh = 7261 e/v
- Päivän sisäinen markkina (Elbas 1h):
– | 0,1 MW minimi koko → 1,33 kW / asiakas → 76 asiakasta 0,1 MW x 273 (h) x 48,50 e/MWh* = 1324,05 e / vuosi (yksi säätö / pv)
– | 5000 asiakasta → 6,65 MWh x 273 (h) = 1815,45 MWh 1815,45 MWh x 48,50 e/MWh* = 88 049,33 e / vuosi (1h säätö / pv)
– | * Laskettu v. 2018 päivän sisäisen markkinan kesä – heinäkuun keskiarvohintojen keskiarvon mukaan
– | Huom! Laskelmassa ei olla huomioitu seuraavien tuntien kulutuspiikkiä.
- Vuorokausimarkkina (Elspot 12h):
– | 0,1 MW minimi koko → 1,33 kW / asiakas → 76 asiakasta 0,1 MW x 273 (h) x 33,19 e/MWh* = 906 e / vuosi (yksi säätö / pv)
– | 5000 asiakasta → 6,65 MWh x 273 (h) = 1815,45 MWh 1815,45 MWh x 33,19 e / MWh* = 60 254 e / vuosi (1h säätö / pv)
– | * Laskettu v. 2017 ka-markkinahinnan mukaan
– | Huom! Laskelmassa ei olla huomioitu seuraavien tuntien kulutuspiikkiä.
- Laitekustannus (haja-asutus) ja asennus 5000 asiakkaalle:
– | Asennus: 5000 asiakasta x 100 e = 500 000 e
– | PerusJouko: 5000 asiakasta x 130 e = 650 000 e
– | TuplaJouko: 5000 asiakasta x 150 e = 750 000 e, asennuksen kanssa 1 250 000 e
– | Huom! Asiakaskuntaa hankkiessa tulisi huomioida se, että kaikki eivät välttämättä osallistu / pysty osallistumaan joustoon (n. 25%). Näin ollen todelliset laitekustannukset tulevat olemaan kalliimmat.
| • Jos tarve jouston piiriin 5000 asiakasta → todellisuudessa asiakkaita tulisi olla 5000 / 0,75 = 6667 asiakasta, jotta haluttu jousto saavutetaan
| • Asennus + TuplaJouko 6667 asiakkaalle → 666 700 e + 1 000 050 e = 1 666 750 euroa

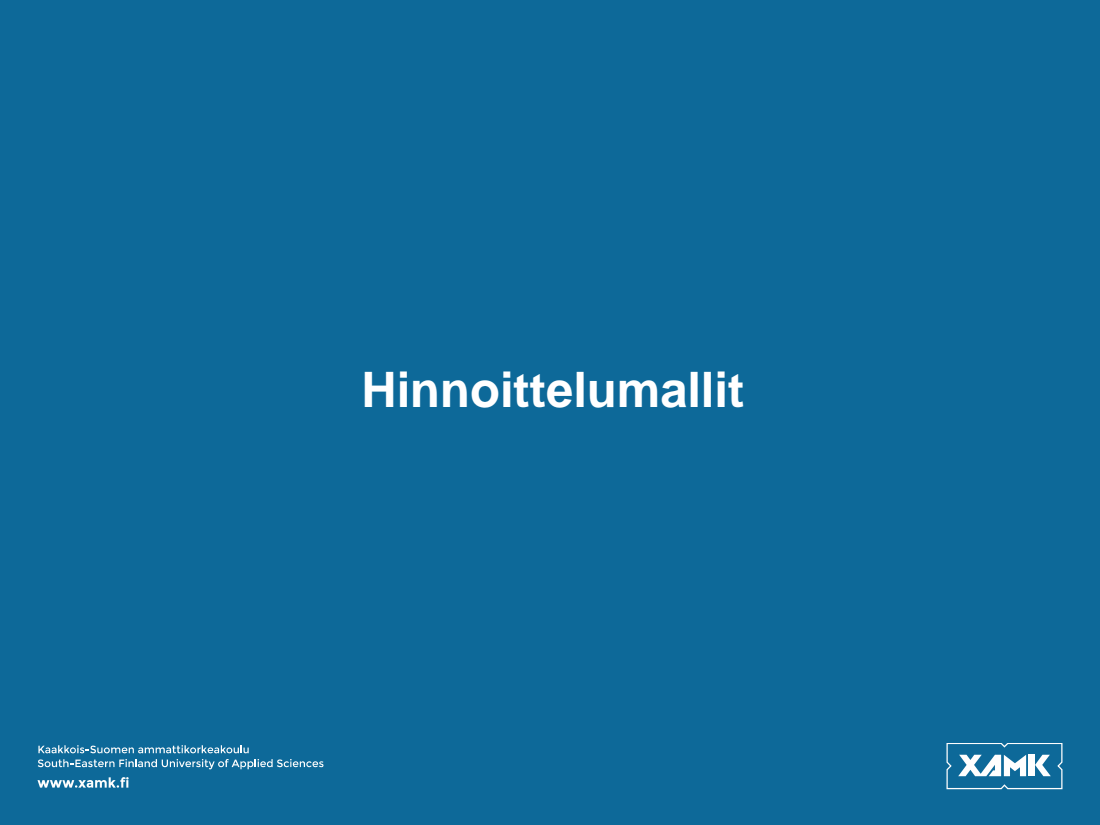
[picture p20: page 42]
Hinnoittelumallit

# Asiakassegmentit

- Passiivinen asiakas:
– Sähköyhtiö / aggregaattori maksaa laitteen asennuksen asiakkaan kotiin. Asiakas lupautuu sähköyhtiön katkoihin, eikä asiakas ei voi halutessaan kieltää katkoa. Asiakas ei voi myöskään suorittaa itse katkoja. Asiakas saa alennusta kiinteähintaisesta sähkösopimuksesta x%(perusprosentti + toteutuneista katkoista/vain perusprosentti/vain toteutuneista katkoista).
- Osittain aktiivinen asiakas:
– Sähköyhtiö / aggregaattori maksaa laitteen asennuksen asiakkaan kotiin. Asiakas lupautuu sähköyhtiön katkoihin, mutta asiakas voi halutessaan kieltää katkon. Asiakas ei voi suorittaa itse katkoja. Asiakas saa alennusta kiinteä hintaisesta sähkösopimuksesta x%(perusprosentti + toteutuneista katkoista/vain perusprosentti/vain toteutuneista katkoista). Mikäli asiakas kieltäytyy kaikista katkoista ei alennusta tule/jopa lisämaksua ”sakkoa” asiakkaalle?
- Aktiivinen asiakas:
– | Asiakas maksaa laitteen asennuksen kotiinsa. Asiakas lupautuu sähköyhtiön katkoihin, mutta asiakas voi halutessaan kieltää katkon. Asiakas voi suoritta myös itse katkoja. Asiakas saa alennusta sähkölaskusta x%. Asiakkaalla on käytössä pörssisähköön perustuva tuntihinnoittelu mikä kannustaa seuraamaan pörssihintaa ja katkomaan kalliit tunnit pois.
– | Peräkkäiset katkot: sähköyhtiön katko asetettava etusijalle. Asiakkaan itseasettama katko ei saa estää sähköyhtiön katkoa. Asiakas voi itse valita esimerkiksi 1-6 kalleinta tuntia riippuen mikä soveltuu hänen lämmitykseen parhaiten. Mikäli asiakas kieltäytyy kaikista katkoista ei alennusta tule/jopa lisämaksua ”sakkoa” asiakkaalle?
- Asiakkaan saama arvo:
– | Kulutussäästö
– | Vihreät arvot
– | Taloudelliset arvot
– | Oma tuotanto

# Hinnoittelurakenne / vaihtoehdot

- Passiivinen ja osittain aktiivinen asiakas: – Kiinteähintainen kk-maksu, kiinteä alennus + alennus toteutetuista katkoista – Kiinteä hintainen kk-maksu, kiinteä alennus – Kiinteä hintainen kk-maksu, alennus toteutuneista katkoista - Osittain aktiivinen asiakas saa sanktiota, mikäli hän kieltäytyy tulevista katkoista. Passiivinen asiakas ei pysty kieltäytymään

tulevista katkoista.

## - Aktiivinen asiakas: – Tuntihintainen sähkösopimus, kiinteä alennus + alennus

toteutetuista katkoista.

## - JouKo laite: perus okh = 140e (taajama), 150 e (haja-asutus), turbo 40% kalliimpi (100 kpl erä)

# JouKo-laitteen SWOT - analyysi

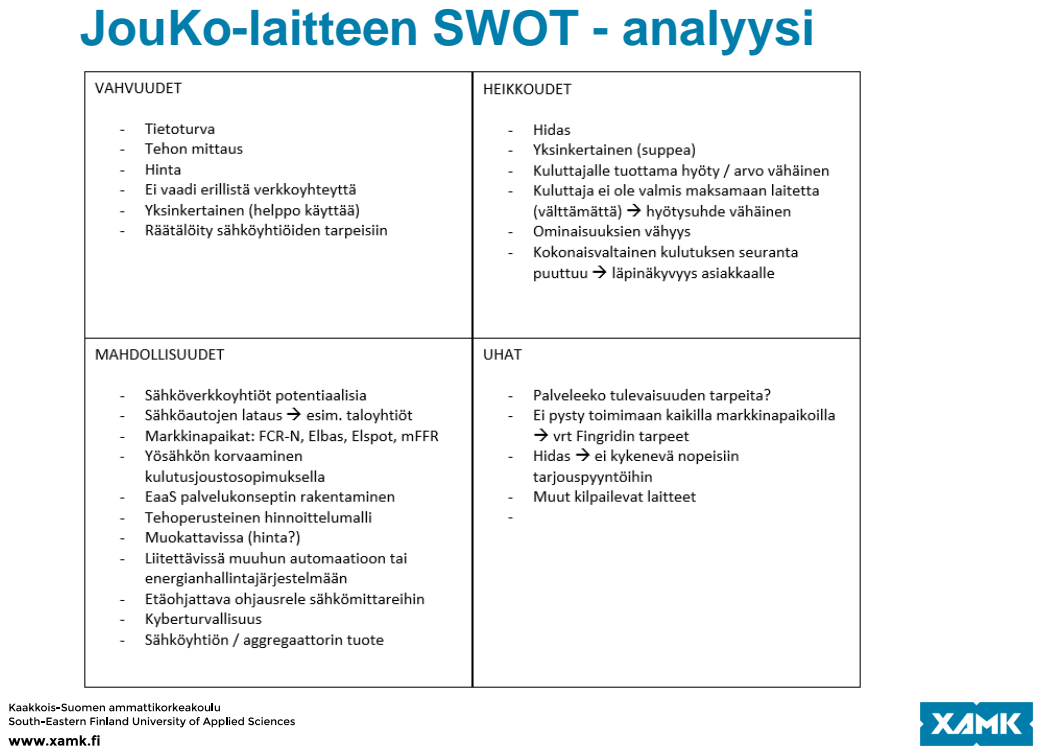
[picture p21: page 45]

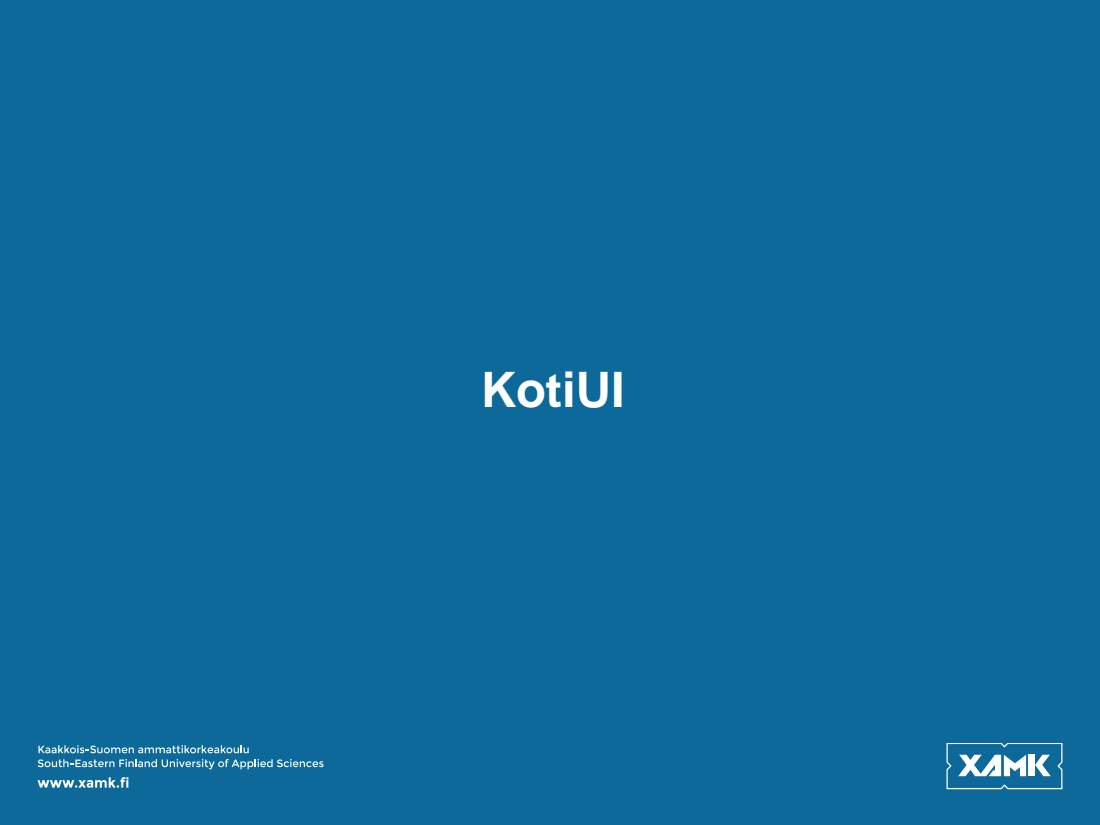
[picture p22: page 46]
KotiUI

# KotiUI selaimessa

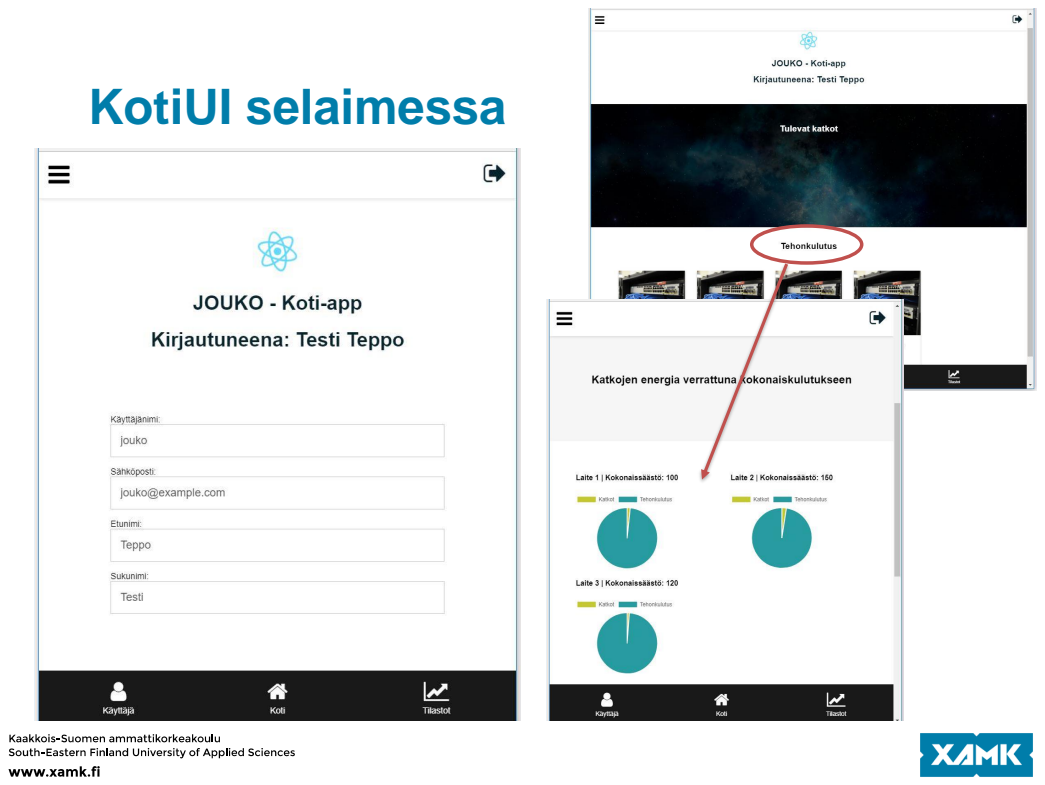
[picture p23: page 47]

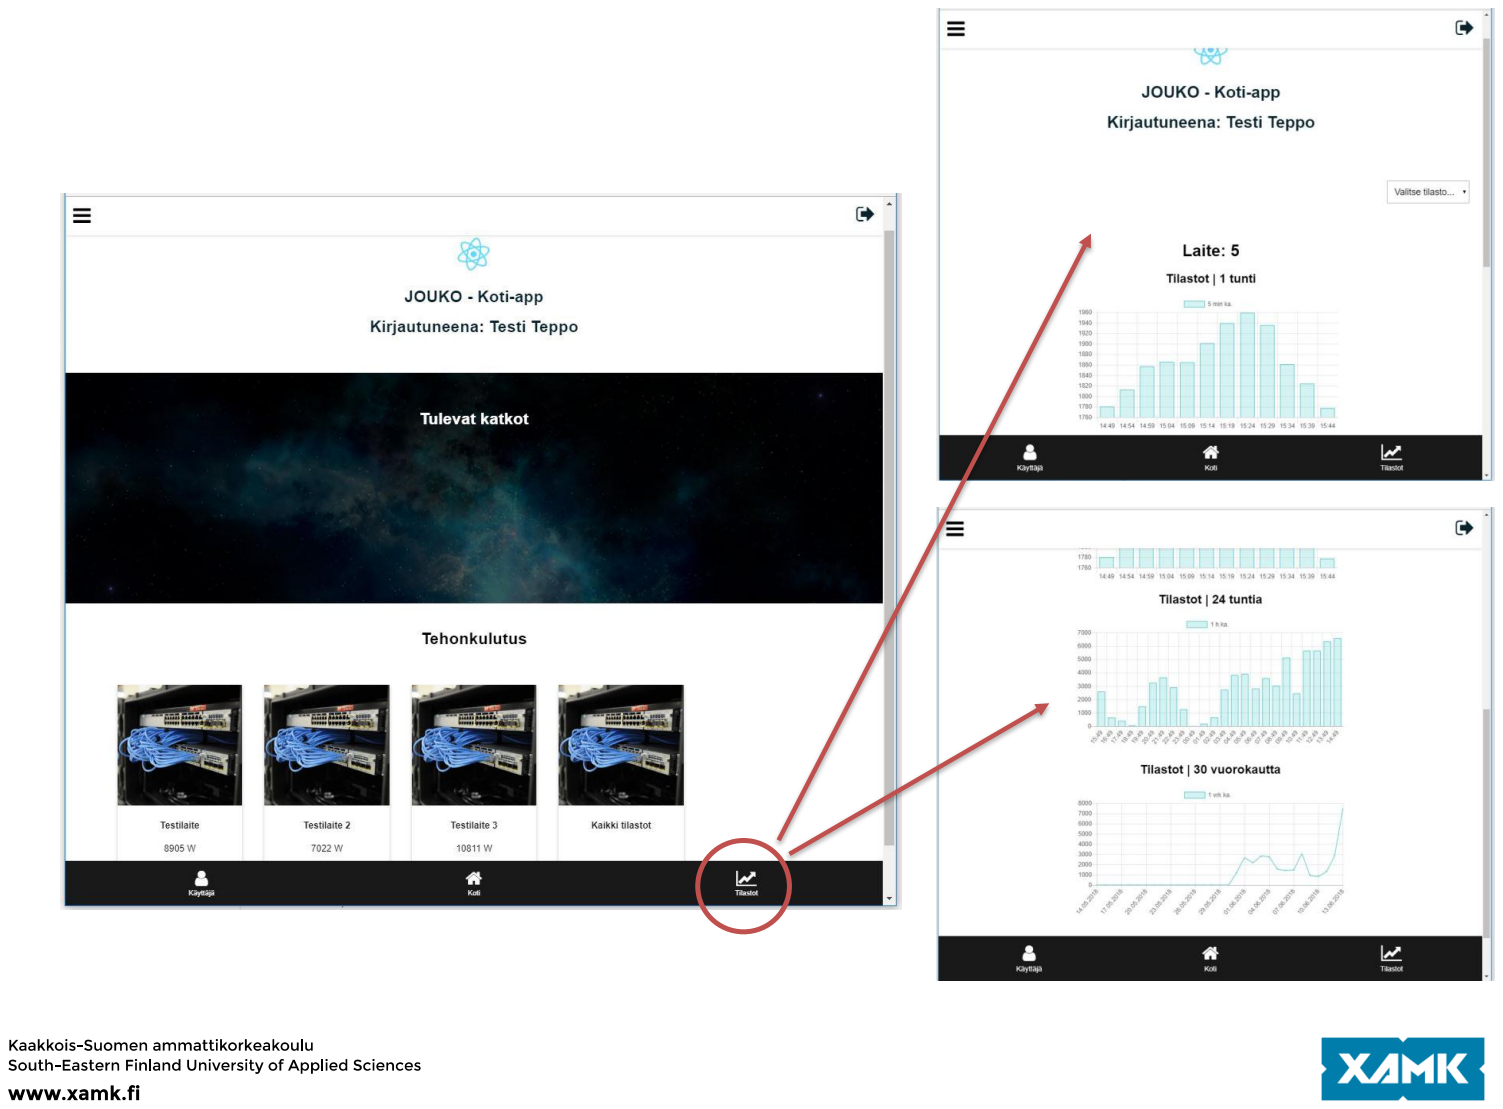
[picture p24: page 48]

# Mobiilisovellus

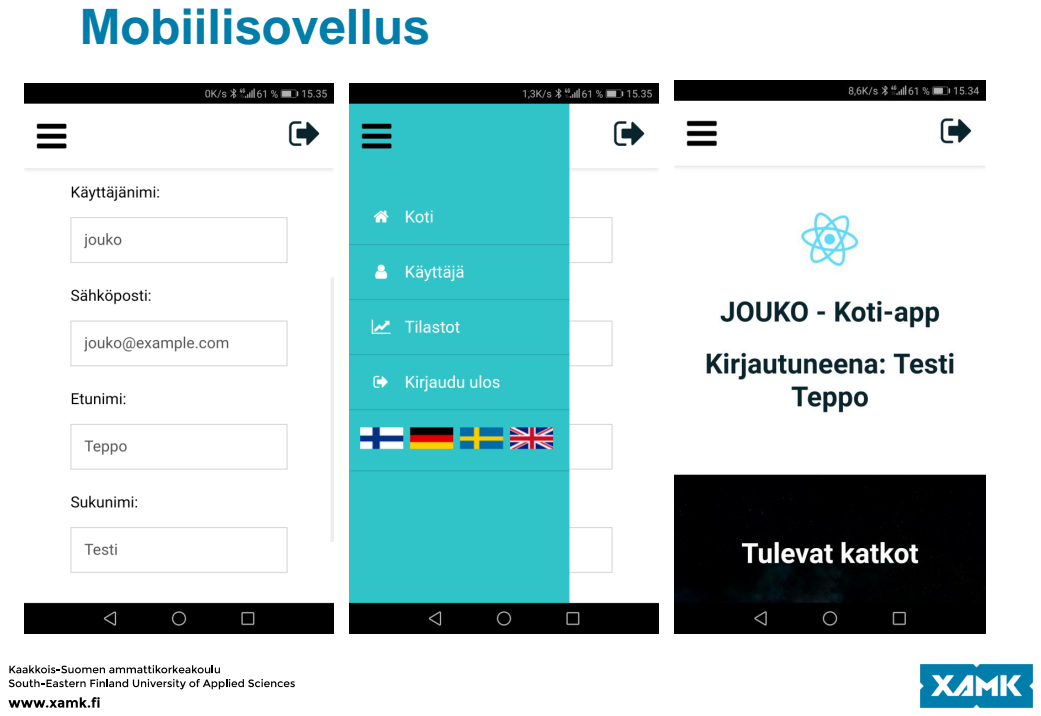
[picture p25: page 49]

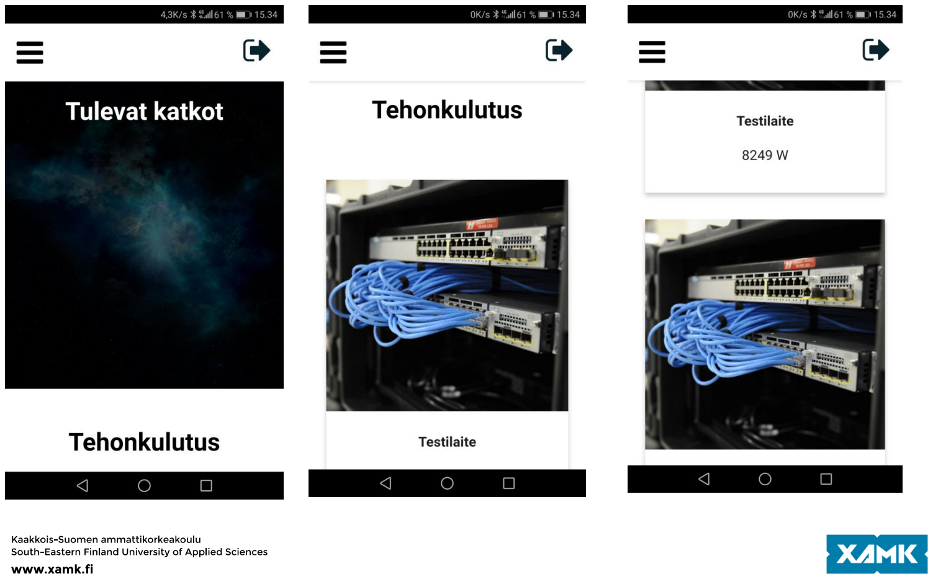
[picture p26: page 50]

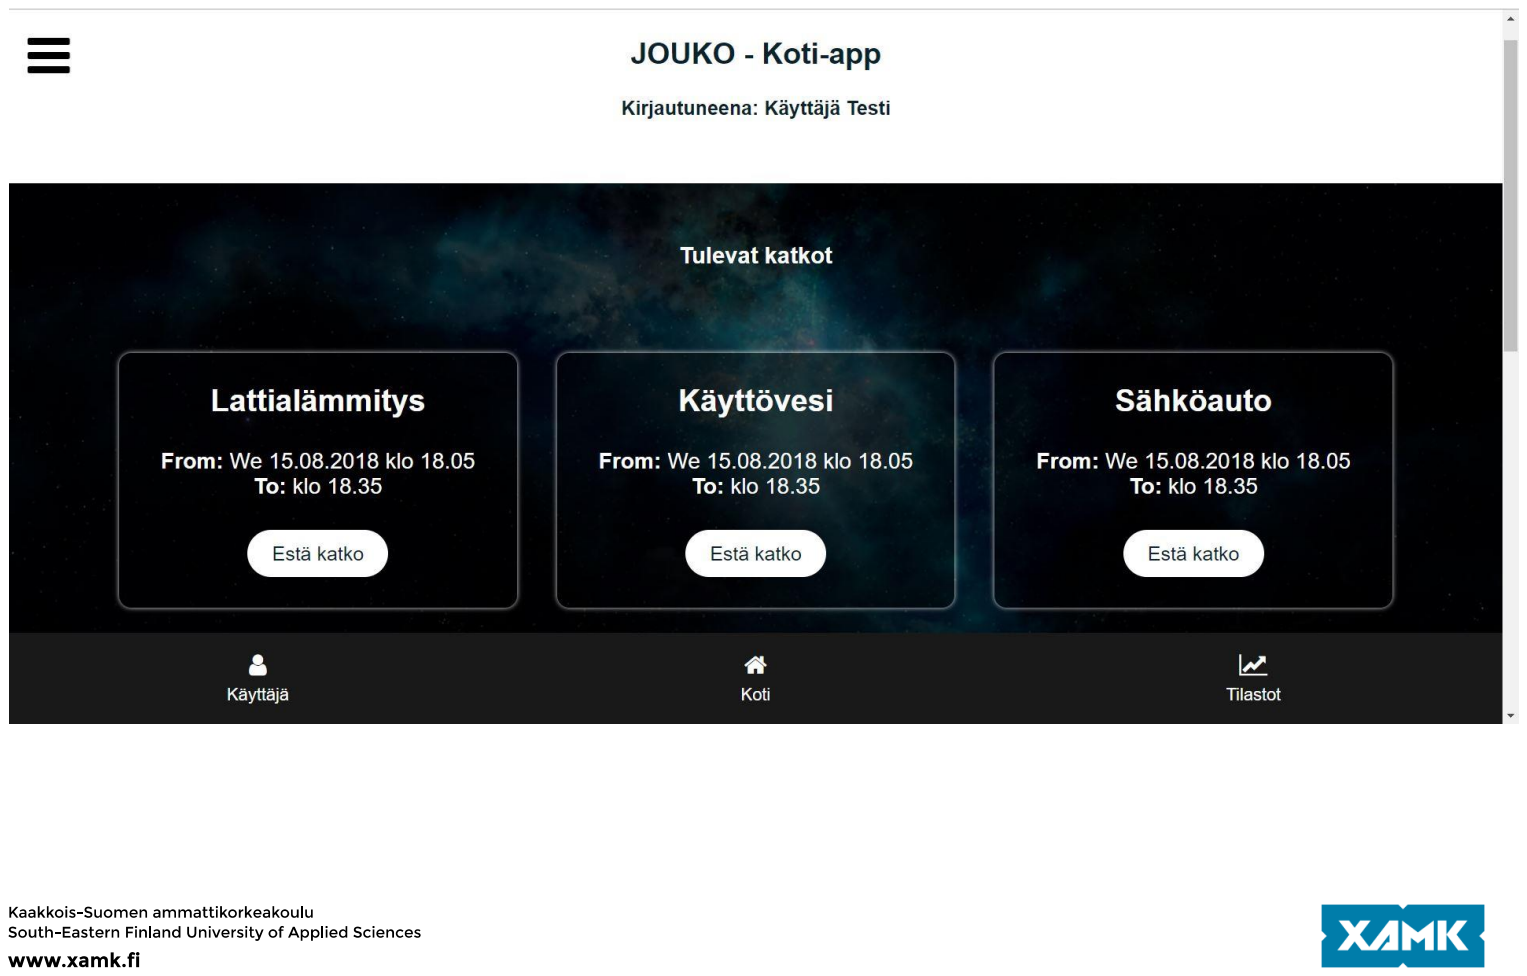
[picture p27: page 51]

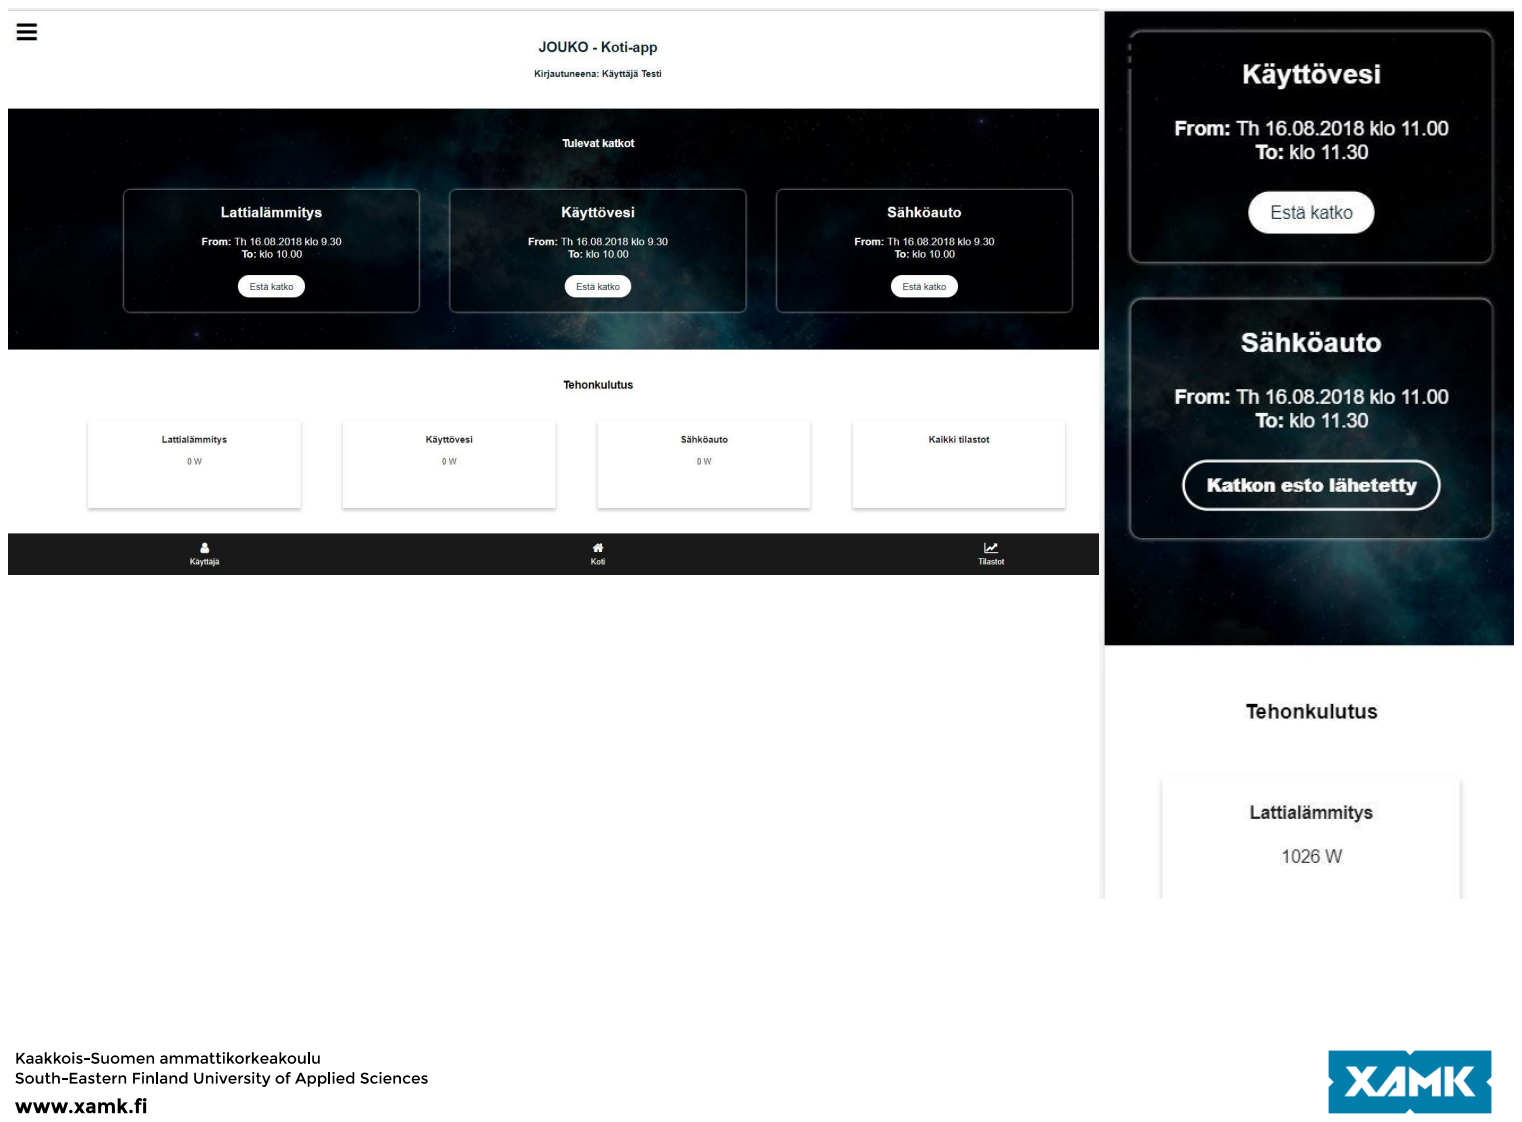
[picture p28: page 52]

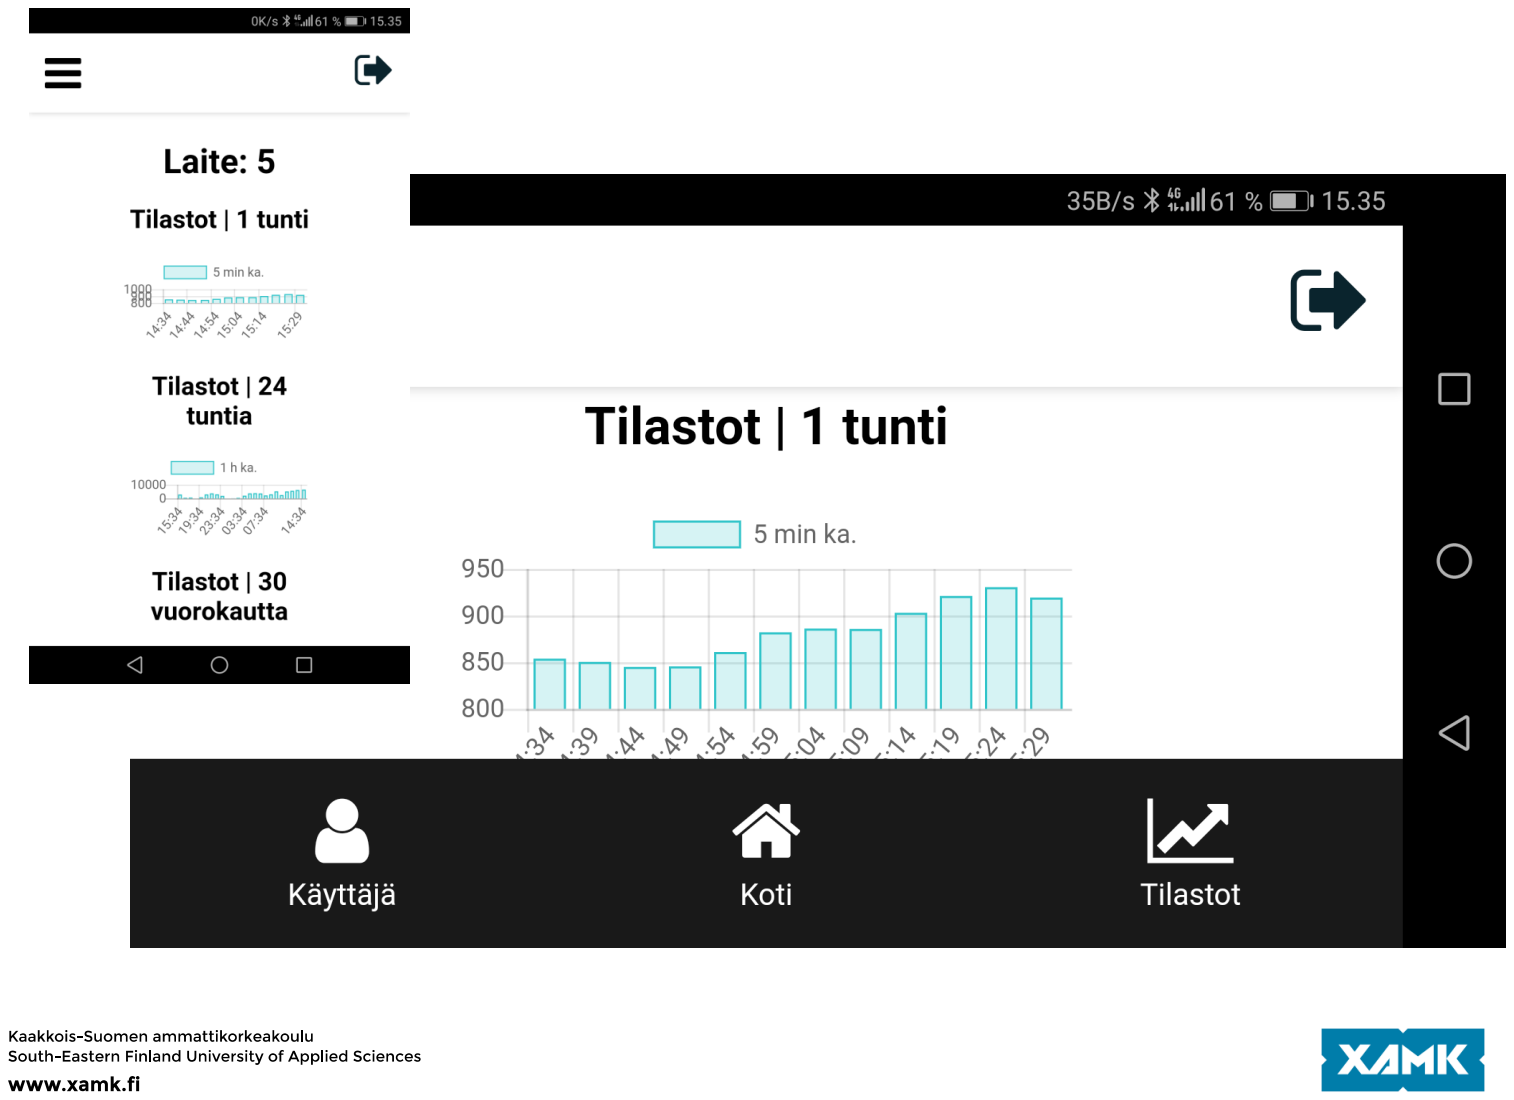
[picture p29: page 53]

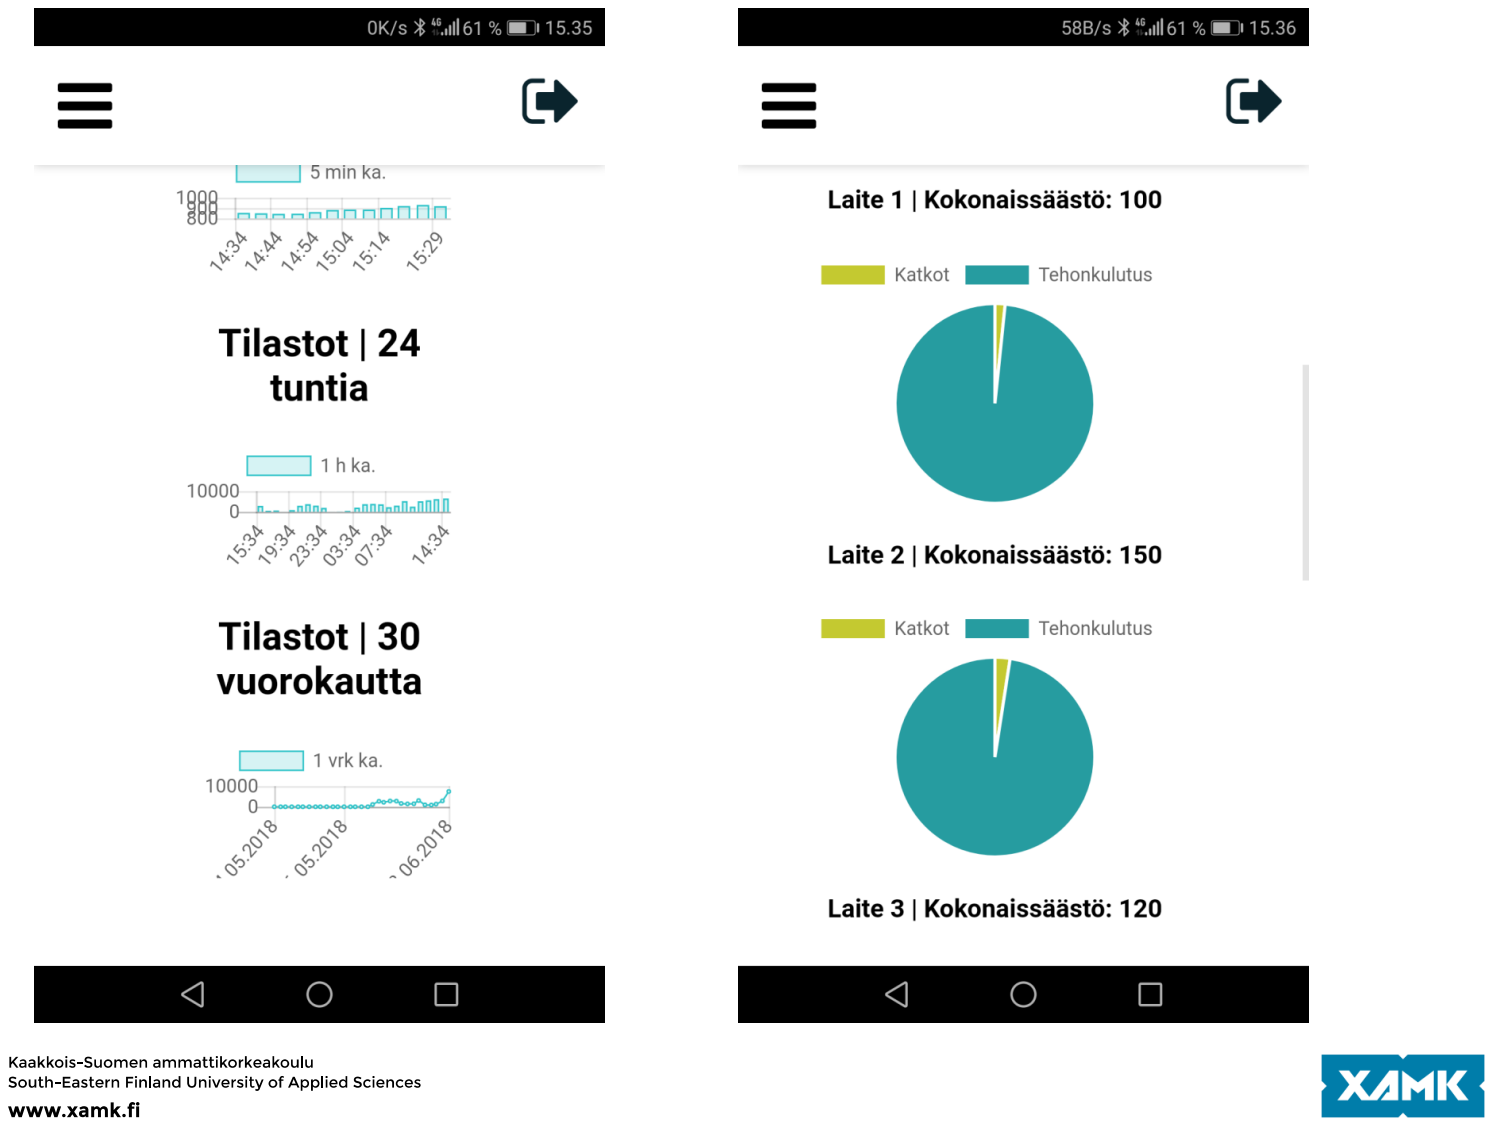
[picture p30: page 54]

# Ominaisuudet

- Tulevat katkot - Tehonkulutus tilastot laitteittain: 1h, 24 h ja 30 vuorokautta - Tehonkulutus vs katkot → kokonaissäästö laitteittain - Kuluttaja saa ilmoituksen tulevista katkoista, jolloin hän ennättää reagoida niihin - Mahdollisia lisäominaisuuksia nykyiseen käyttöliittymään ja mobiilisovellukseen? – Lämpötilamittaus? – Laskutustietoja? – Sähköpörssin hintatietoja? – Joustosta “tienatut” rahat? – Asunnon kokonaiskulutus? – Kotona / pois – kytkin? – Mitä muuta? - Millaisia ominaisuuksia sähköyhtiön JouKo - palvelun käyttöliittymällä tulisi olla? - Mitä dataa pitää kulkea JouKon ja sähköyhtiön verkkopalvelun välillä?

# Jouko -prototyypit

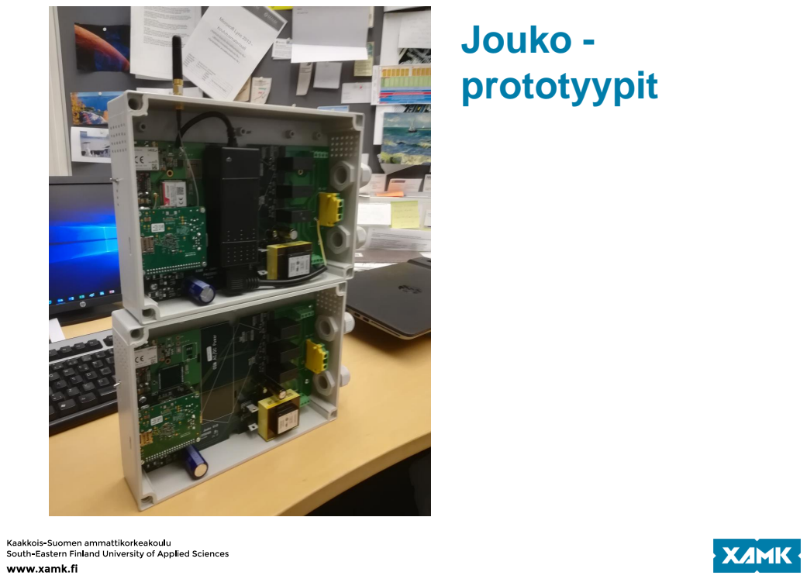
[picture p31: page 56]

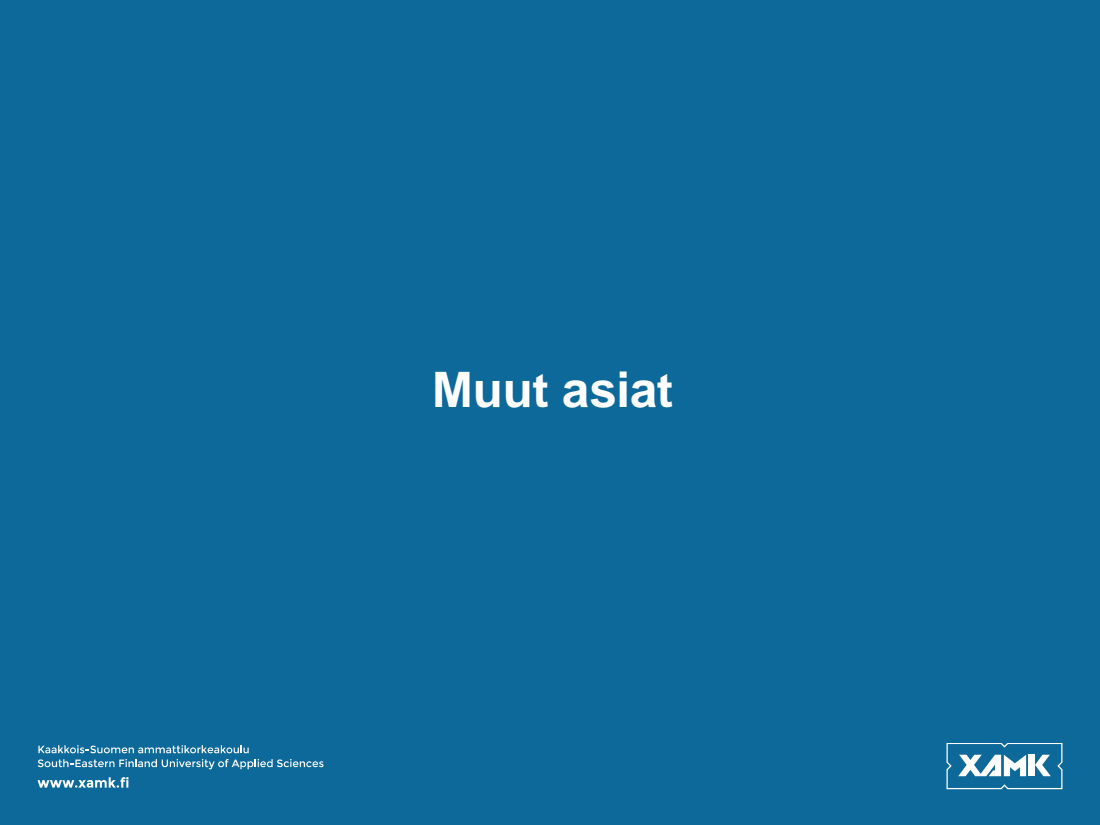
[picture p32: page 57]
Muut asiat

# Sähköauton latauksen ohjaus

## - Projekti on siirtynyt tutkimaan JouKo-laitteen edellytyksiä ja mahdollisuuksia taloyhtiöiden ja yksityisasuntojen sähköautojen

lautauksen ohjauksessa.

## – Kun sähköautojen määrä lisääntyy, kiinteistöjen verkon

kapasiteetin riittävyys alkaa tulla kyseenalaiseksi.

## – Mikäli JouKolla hallittaisiin kiinteistöjen kuormia, ei kiinteistön

liittymä/sulakekokoa tarvitsisi välttämättä kasvattaa.

# Sähköyhtiön kysymykset/huomiot

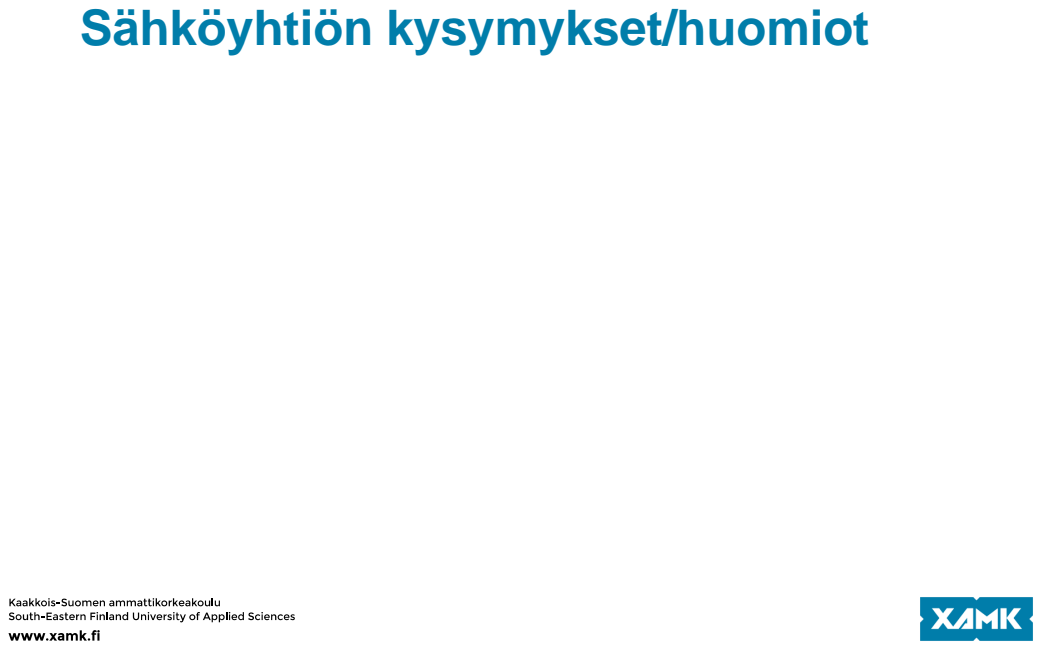
[picture p33: page 59]

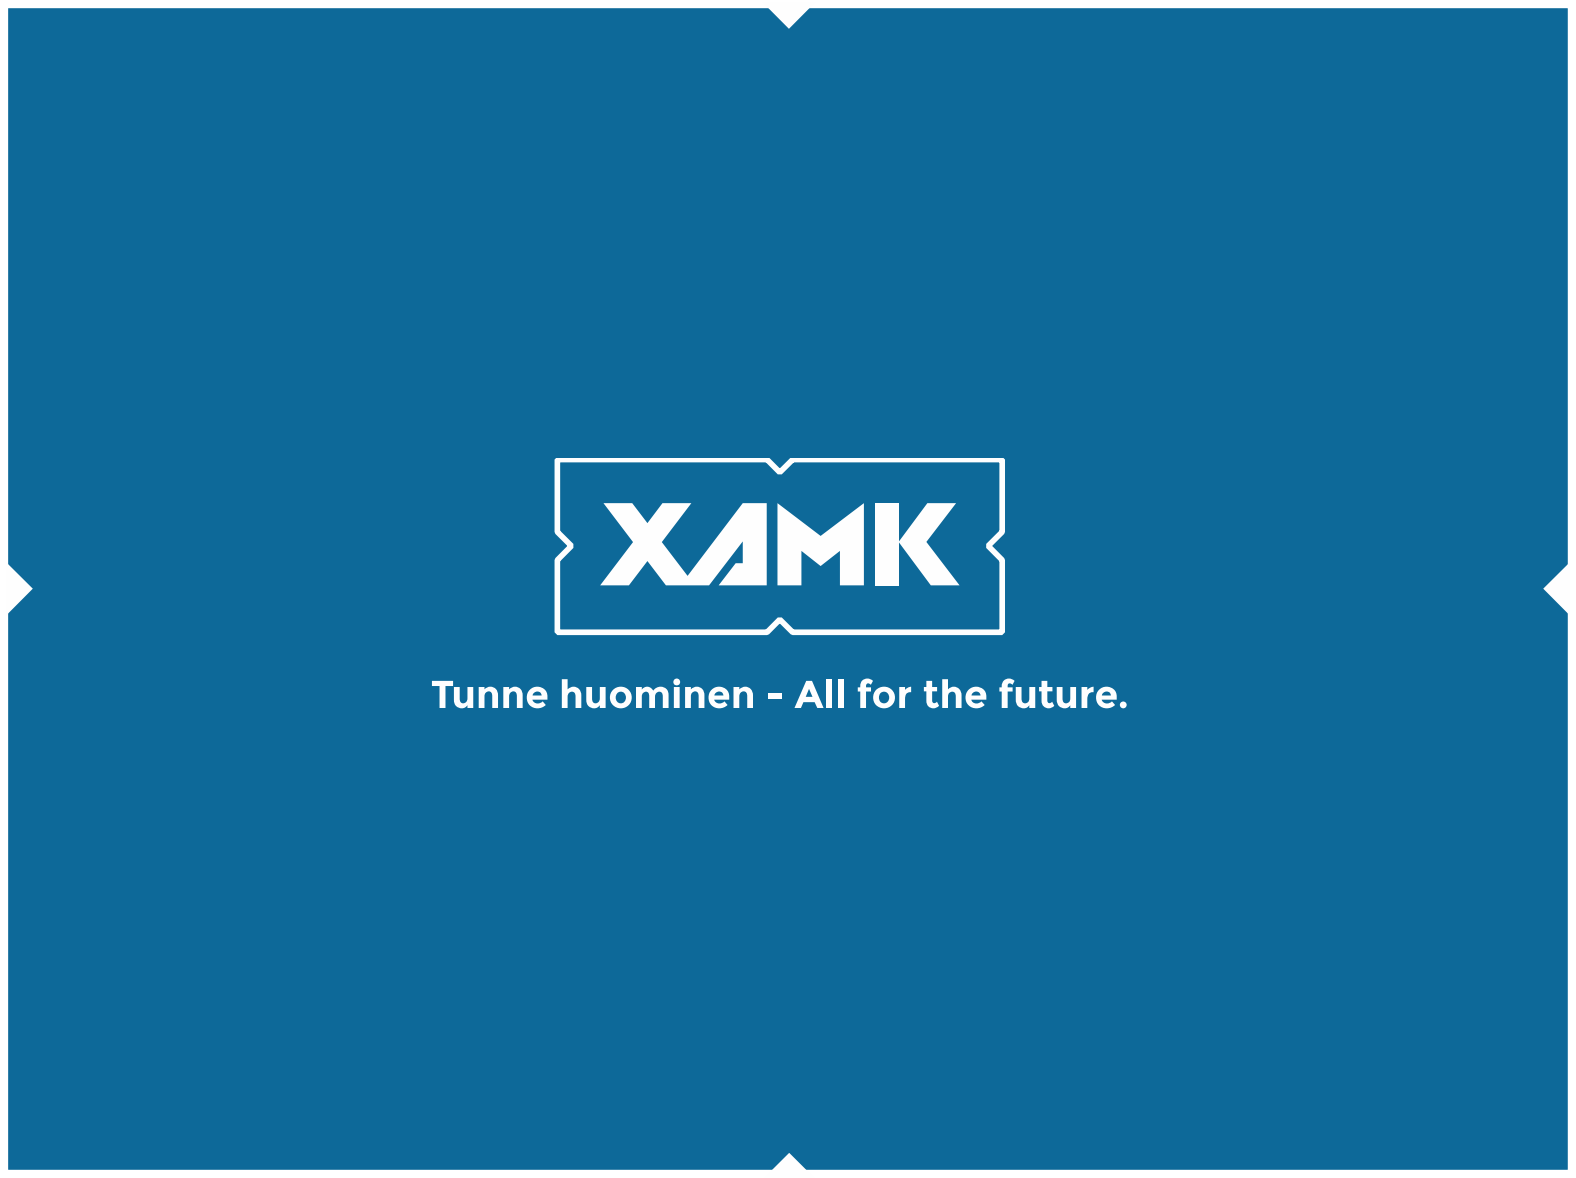
[picture p34: page 60]

Liite 2.

KUVALUETTELO

Kuva 1. Kysyntäjouston tilanne Suomessa. Fingrid

https://www.fingrid.fi/sahkomarkkinat/kysyntajousto/

Kuva 2. Sähkön hinnan muodostuminen Lappeenrannan energia oy. Sähkön hinnan

muodostuminen. Viitattu [29.8.2018]

https://www.lappeenrannanenergia.fi/tuotteet/hinnastot%20ja%20ehdot/sahkohinnas

to/Sivut/Sähkön%20hinnastot%20ja%20ehdot.aspx.

Kuva 3. Energiamarkkinan muutos Honkapuro, Samuli (2017). Näkökulmia energia-

ja ilmastostrategiaan. Viitattu [29.8.2018] https://docplayer.fi/52821329-Nakokulmia-

energia-ja-ilmastostrategiaan.html (https://docplayer.fi/52821329-Nakokulmia-energia-ja-ilmastostrategiaan.html)
