Teukka/FlexHomeElPower/BusinessStudies/Financing of the JouKo project.pdf

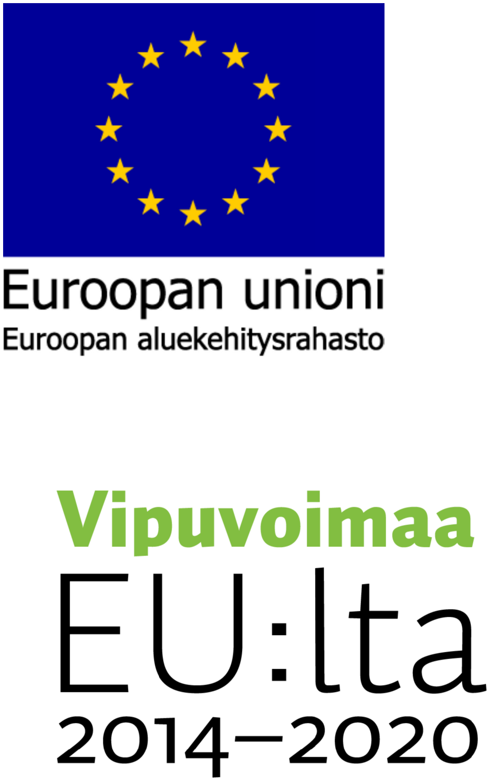
[picture p36: page 1]
