Teukka/FlexHomeElPower/HW_Descriptions/After Factory Modifications/Necessary modification to JouKo HW 0.8 _ D14.pdf

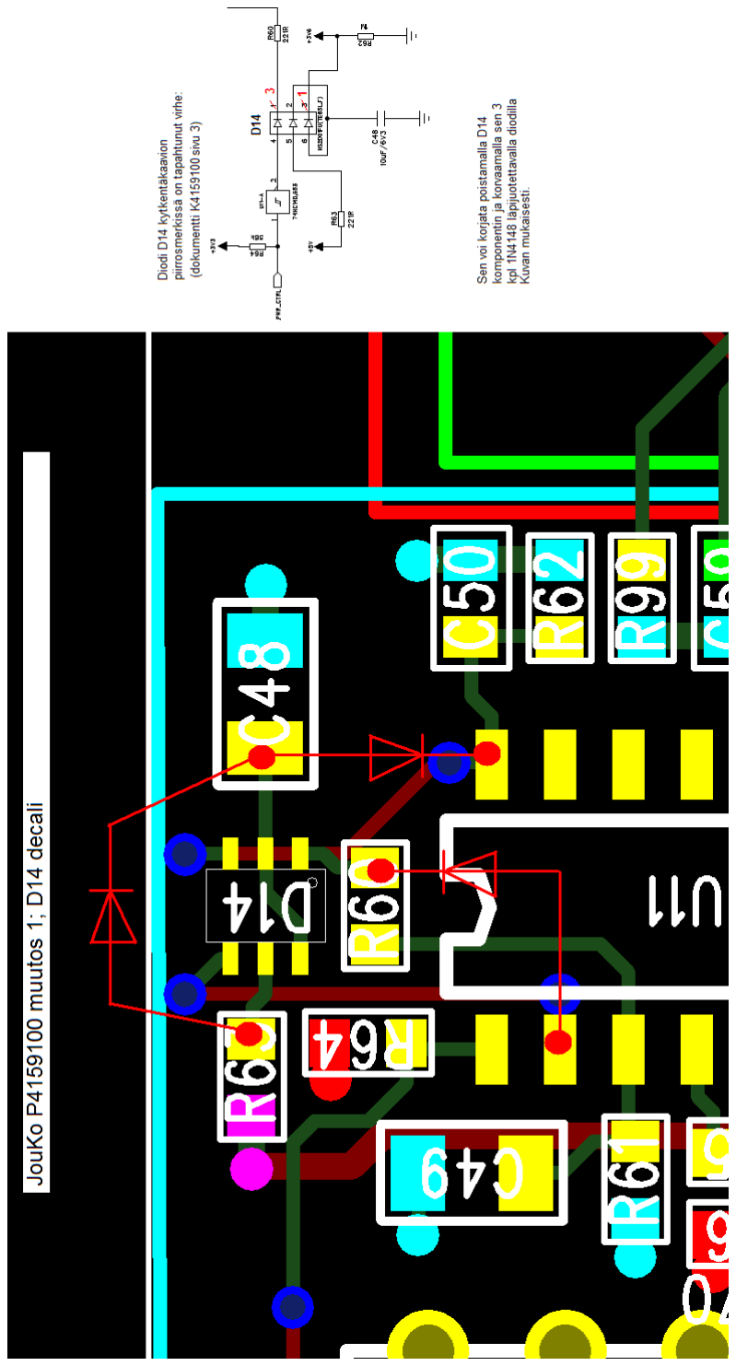
[picture p37: page 1]
