Teukka/FlexHomeElPower/HW_Descriptions/After Factory Modifications/Necessary modification to JouKo HW 0.8 _ D9 _D10 and TR1 pcb modification.pdf

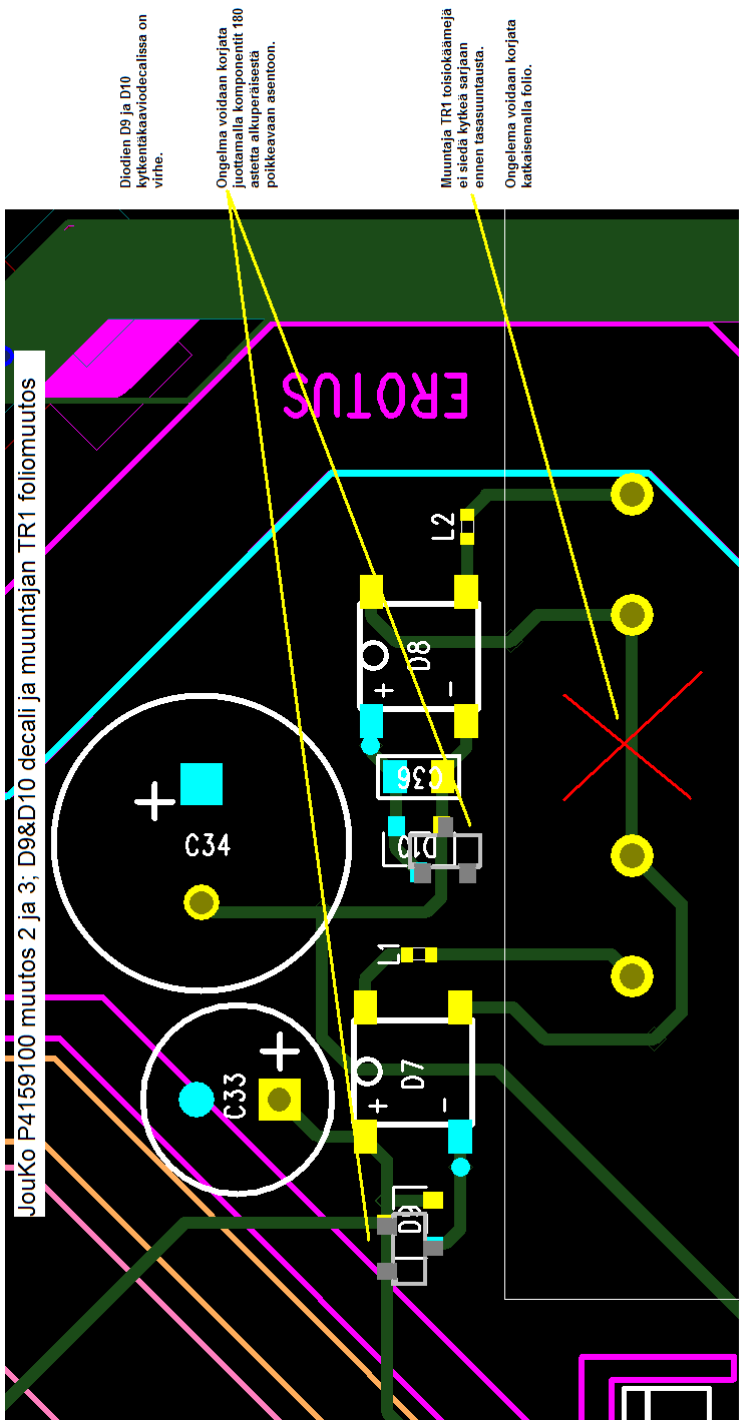
[picture p38: figure]
