Teukka/FlexHomeElPower/HW_Descriptions/Enclosure/enclosure - cooling holes 3.5 mm.pdf

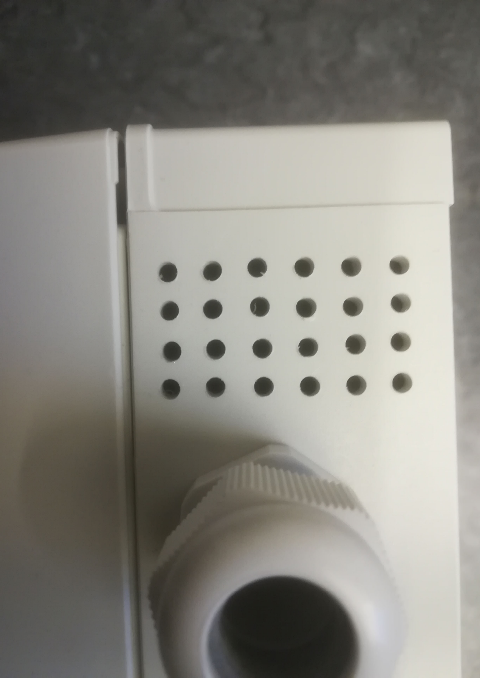
[picture p39: page 1]
