Teukka/FlexHomeElPower/HW_Descriptions/Enclosure/enclosure - holes LEDs and switch.pdf

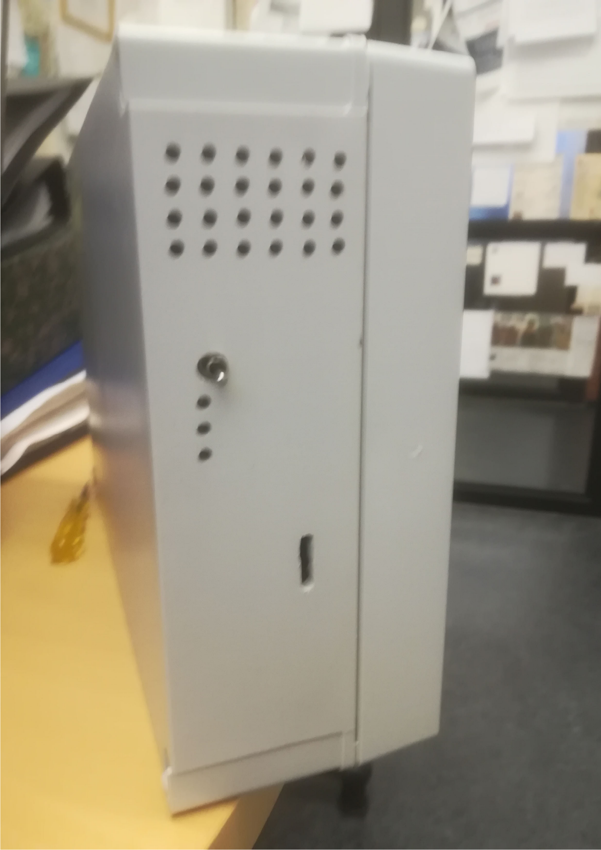
[picture p40: page 1]
