Teukka/FlexHomeElPower/HW_Descriptions/Enclosure/enclosure - recommended 1.pdf

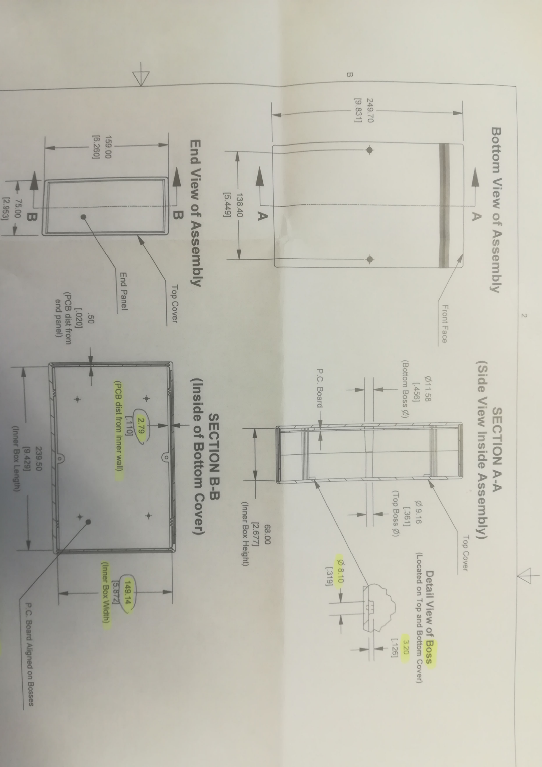
[picture p41: page 1]
