Teukka/FlexHomeElPower/HW_Descriptions/Enclosure/enclosure - recommended 2.pdf

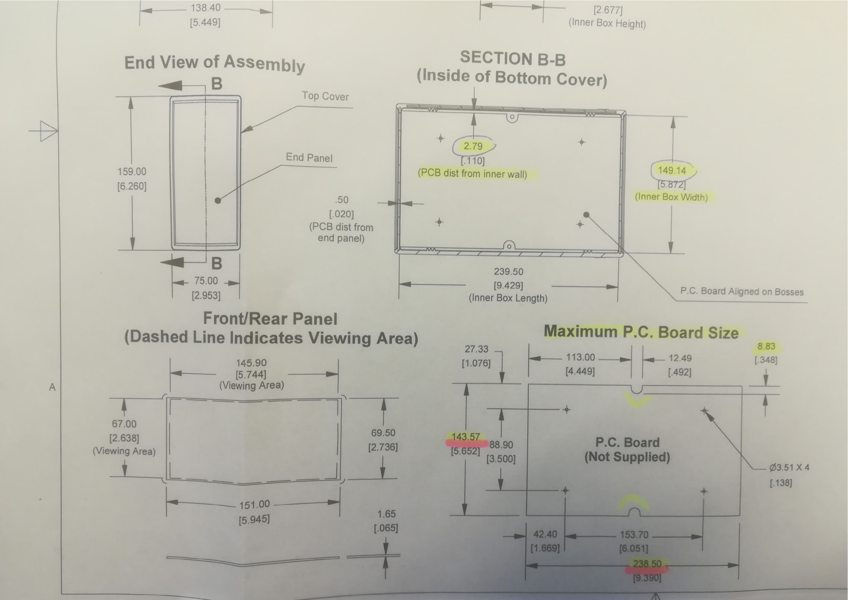
[picture p42: page 1]
