Teukka/FlexHomeElPower/HW_Descriptions/Enclosure/enclosure - recommended 3.pdf

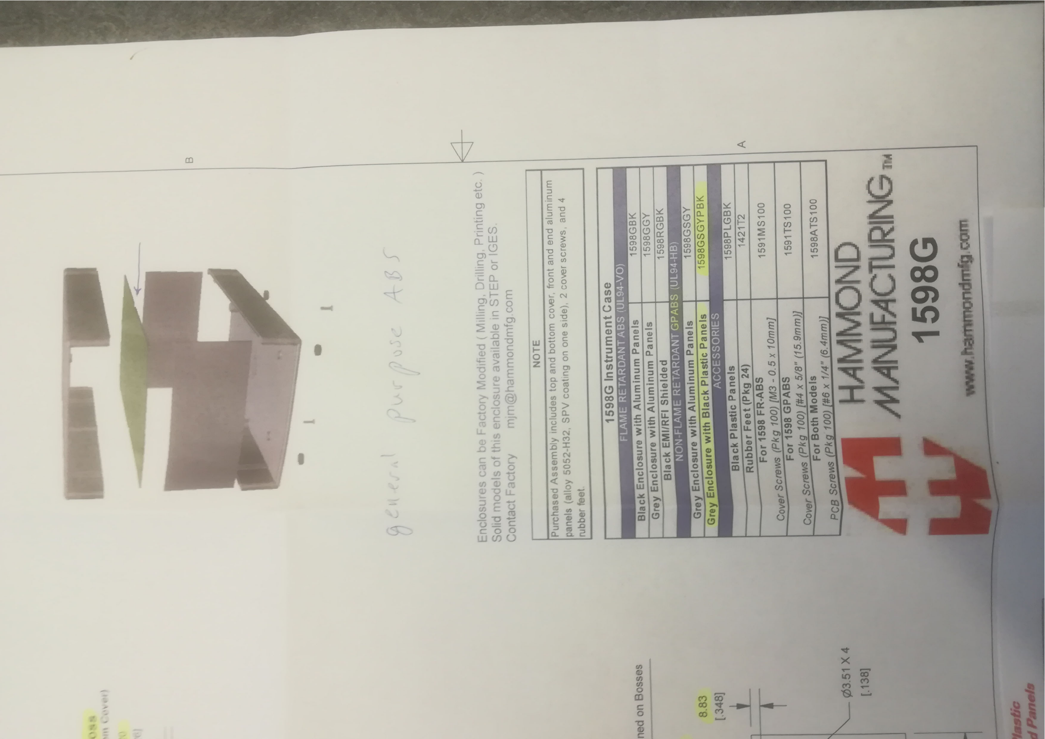
[picture p43: page 1]
