Teukka/FlexHomeElPower/HW_Descriptions/Enclosure/enclosure - recommended 4 of 4.pdf

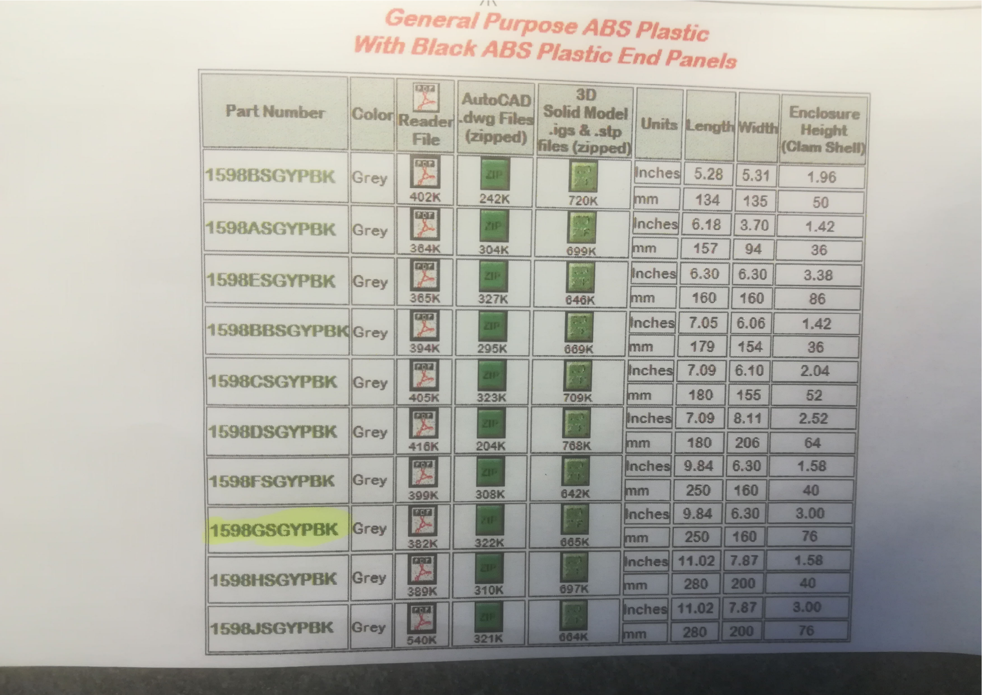
[picture p44: page 1]
