Teukka/FlexHomeElPower/HW_Descriptions/Voltage Source for GSM 2G/JouKo 5 V Source - photo of the EMI Shield Box.pdf

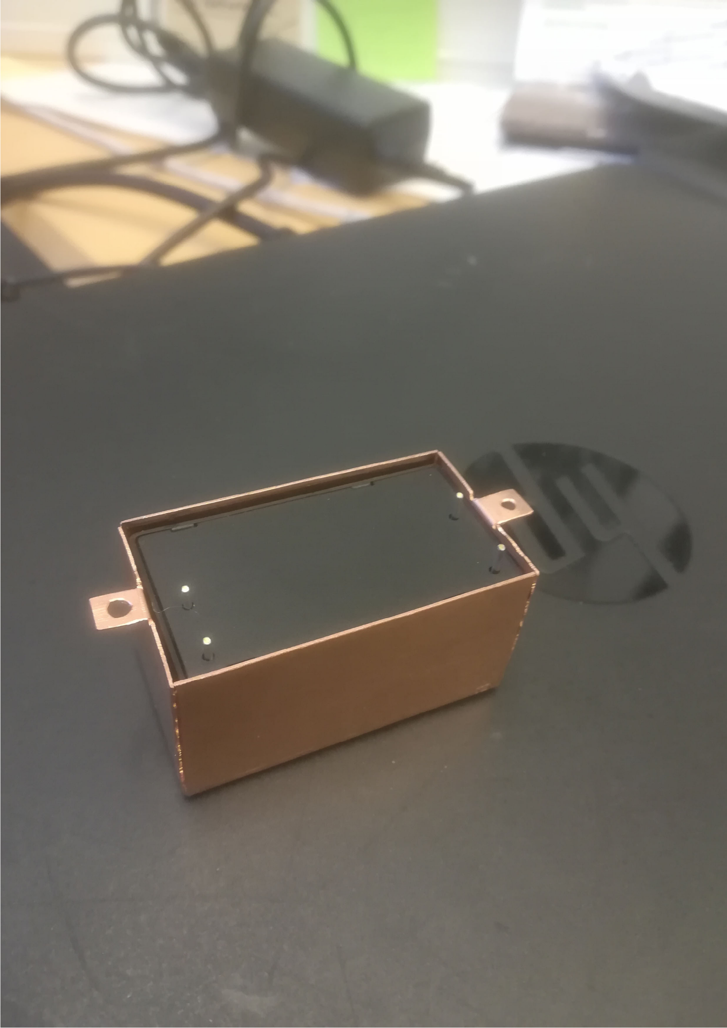
[picture p45: page 1]
