Teukka/FlexHomeElPower/HW_Descriptions/Voltage Source for GSM 2G/JouKo SMPS 5V -photo1.pdf

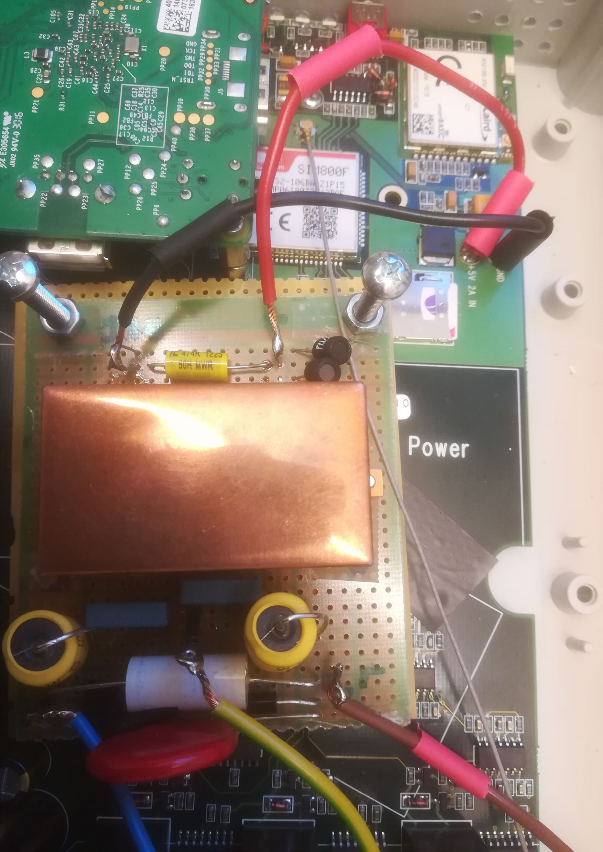
[picture p46: page 1]
