Teukka/FlexHomeElPower/HW_Descriptions/Voltage Source for GSM 2G/JouKo SMPS 5V -photo2.pdf

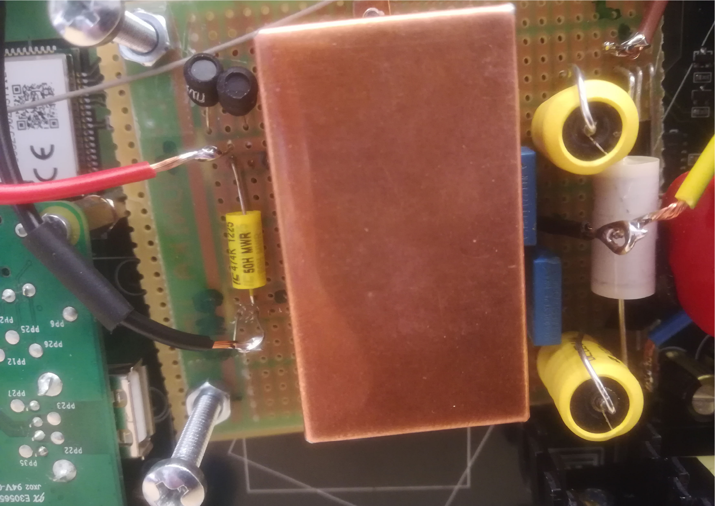
[picture p47: page 1]
