Teukka/FlexHomeElPower/HW_Descriptions/Cost/Manufacturing cost estimates.pdf

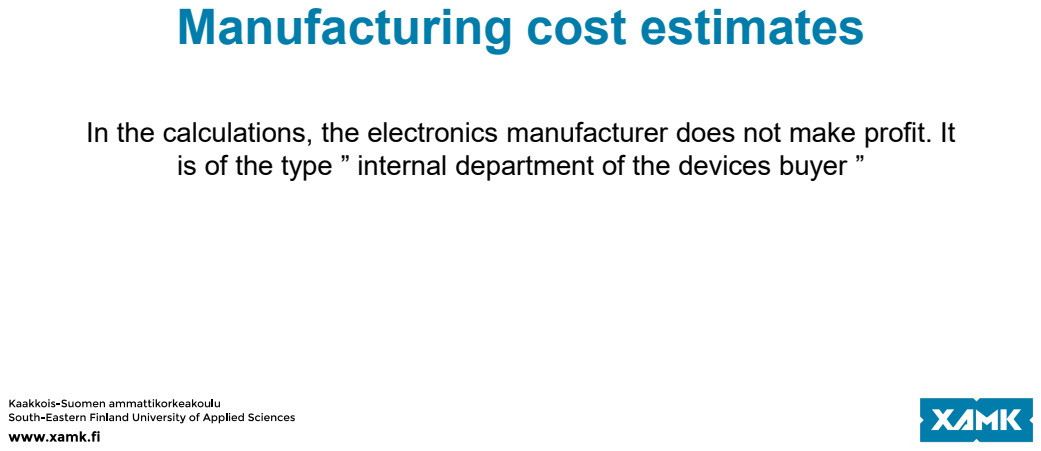
[picture p48: page 1]

Manufacturing cost estimates

In the calculations, the electronics manufacturer does not make profit. It
is of the type ” internal department of the devices buyer ”

# Approximate costs of different versions

- The Countryside Switcher ( currently with BT 4 ) is the cheapest one because it does not need an external antenna. It is 133 € ( in 100 pieces ). There is no monthly network fee.
- The City version is next cheapest, with an 0.7 € monthly network fee. It is 137 €.
- The Countryside Control unit is 168 €. The biggest added cost is the 5V voltage source. In Finland You can use a 1.5 € monthly bit limited GSM 2G SIM.
- If the hand fabricated 4G modified version of the Countryside Control unit is built, it is 219 €. In Finland the 4G SIM is 6 Euros per month.
- The prices are with the 25*16*7 cm enclosure from Hammond.
- When the device is assembled to a home You need to pay to the electrician to make the connections. In Finland this is about the same cost as the device cost.
