Teukka/FlexHomeElPower/HW_Descriptions/Voltage Source for GSM 2G/JouKo 5 V Source Manufacturer EMI Shield Box.pdf

Manufacturing SME for the JouKo Voltage Source EMI Shield Box

2G-laitteen hakkurin suojakotelon valmistaja :

T:mi Reijo Hujanen
LENTOKENTANKATU 17
50150 MIKKELI
Finland

posti@reepe.fi .
