Teukka/FlexHomeElPower/Manufacturing/Electronics/Pcb Manufacturing/panel_instr_P4159100.pdf

P4159100 PCB panel instruction.

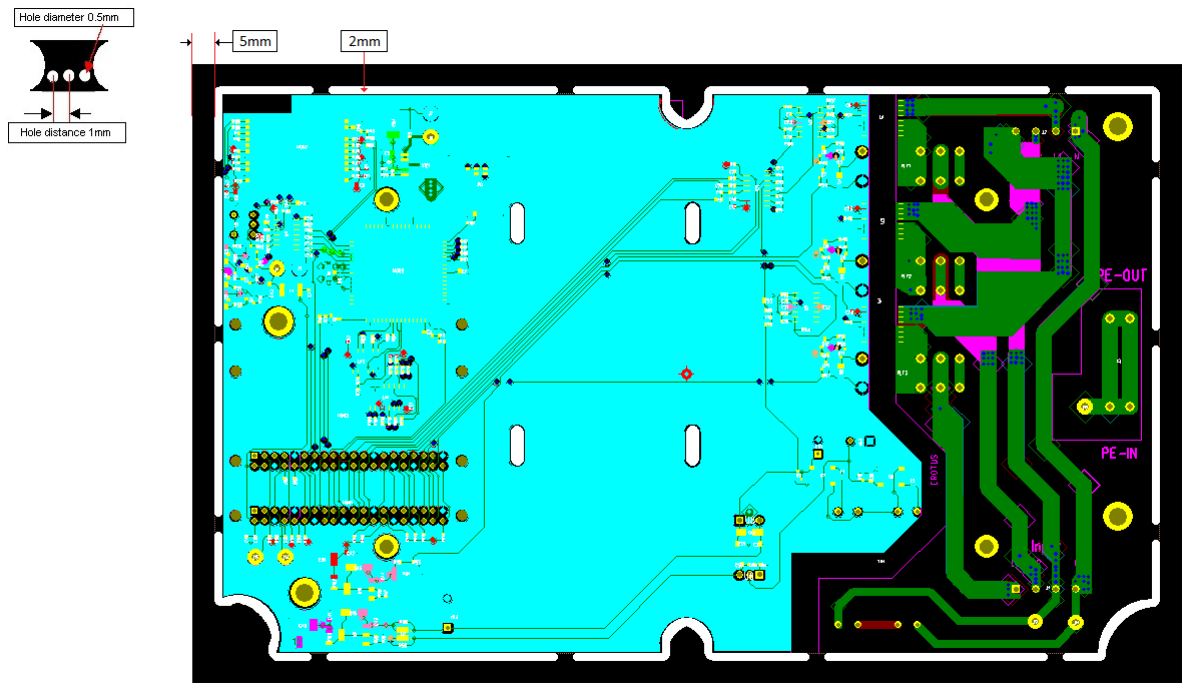
[picture p49: figure]

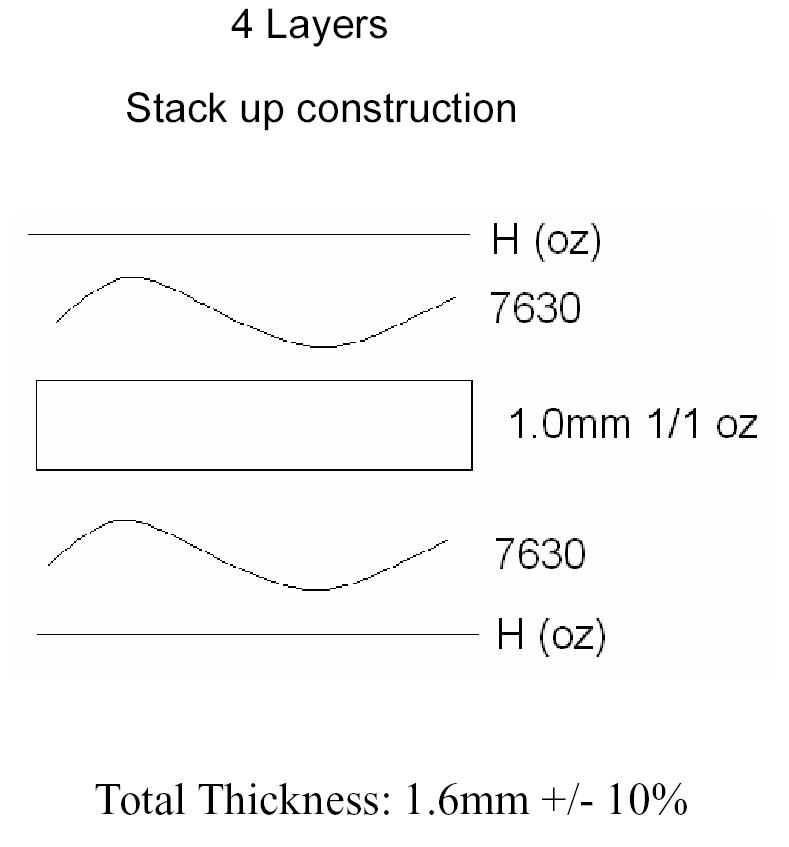
[picture p50: figure]

Plating: | NiAu
Cu: | 35um
UL Logo & Date Code: | Free place Silkscreen laye

r
Solder Mask: | Green
Silkscreen: | White
