Teukka/FlexHomeElPower/HW_Descriptions/Voltage Source for GSM 2G/JouKo 5 V Source Soldering Picture 1.pdf

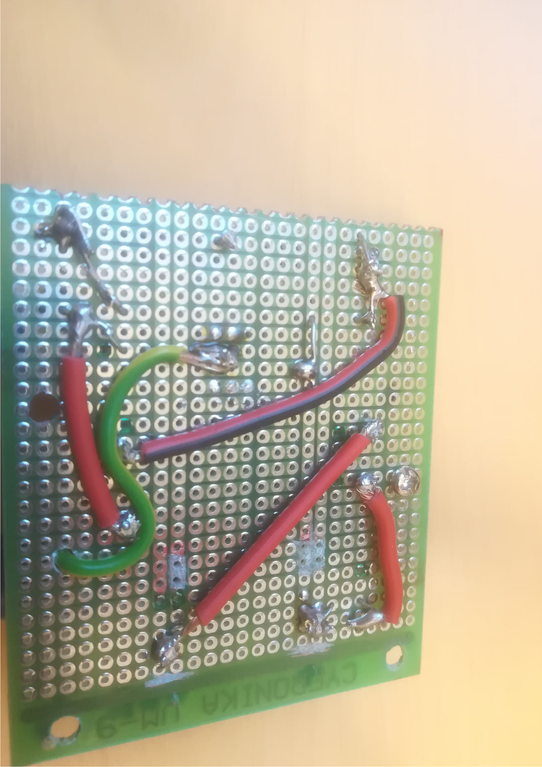
[picture p51: page 1]
