Teukka/FlexHomeElPower/HW_Descriptions/Voltage Source for GSM 2G/JouKo photo 2G EMI measured EN 55032 OK -1_5V board not in final pos.pdf

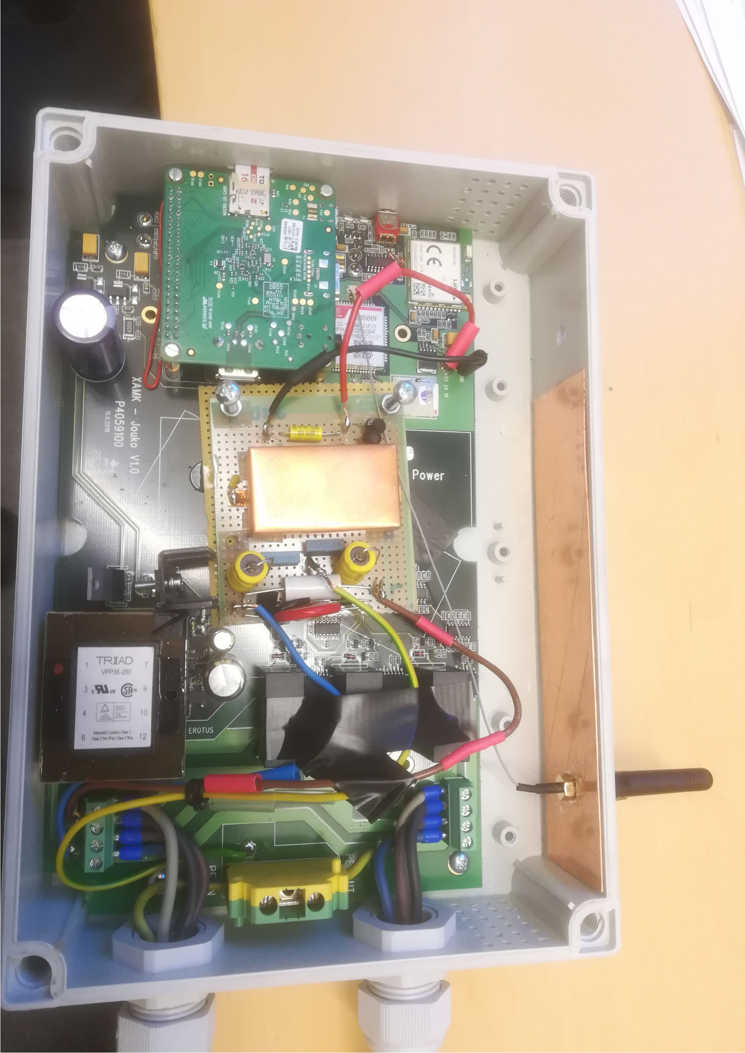
[picture p52: page 1]
