Teukka/FlexHomeElPower/HW_Descriptions/Voltage Source for GSM 2G/JouKo photo 2G EMI measured EN 55032 OK -2_5V board not in final pos.pdf

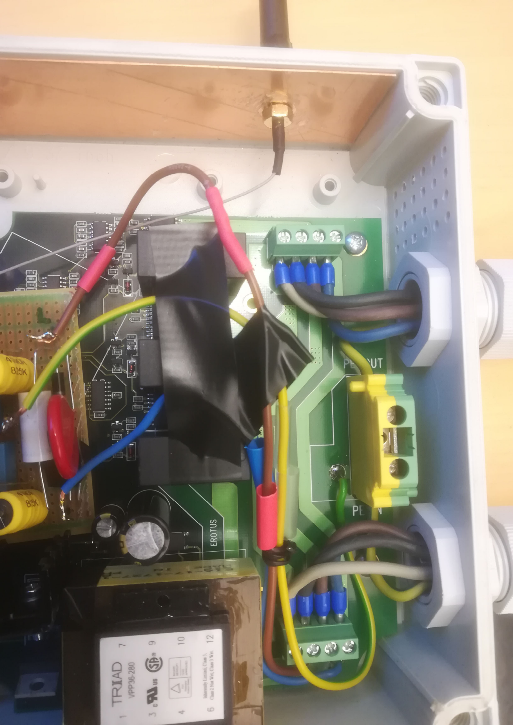
[picture p53: page 1]
