Teukka/FlexHomeElPower/Manufacturing/Mechanics/XAMK Jouko V1.0 liittimet ja korotusholkit.pdf

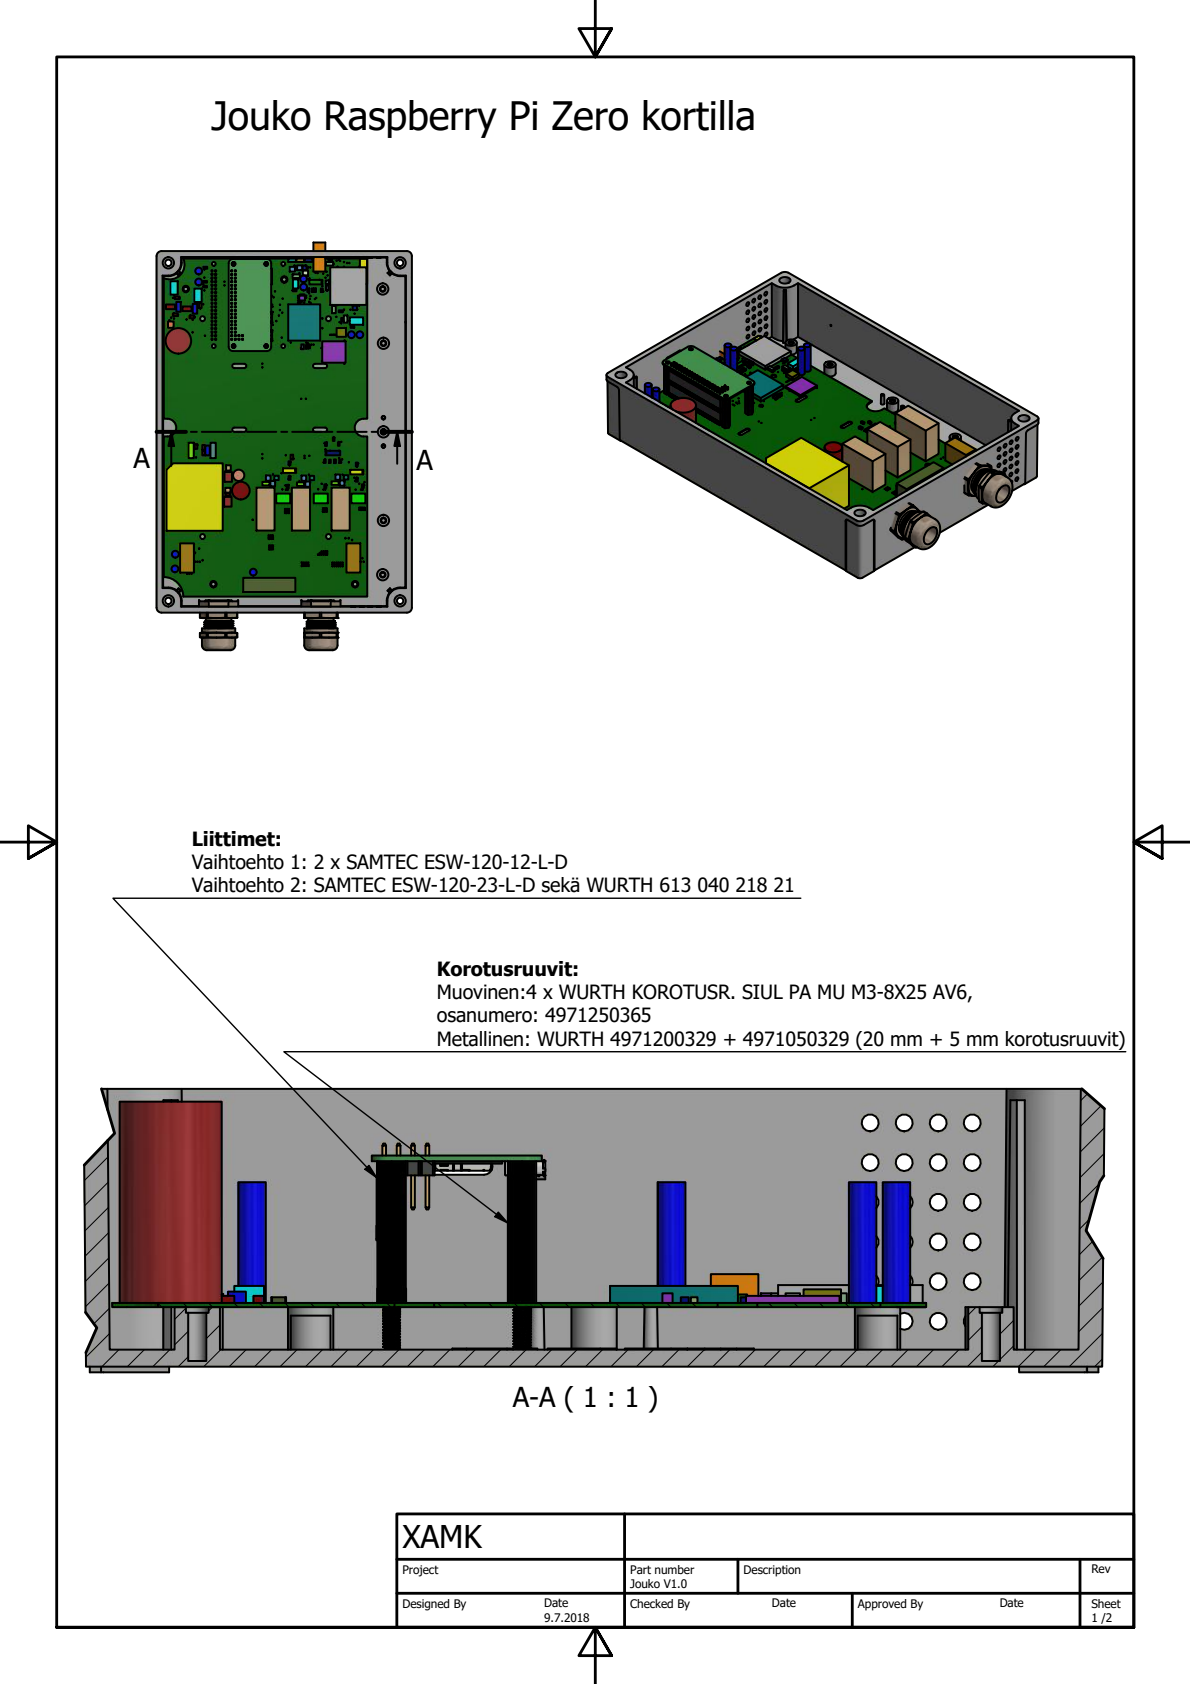
[picture p54: page 1]

Jouko Raspberry Pi Zero kortilla

Liittimet:
Vaihtoehto 1: 2 x SAMTEC ESW-120-12-L-D
Vaihtoehto 2: SAMTEC ESW-120-23-L-D sekl WURTH 613 040 218 21

Korotusruuvit:
Muovinen:4 x WURTH KOROTUSR. SIUL PA MU M3-8X25 AV6,
osanumero: 4971250365
Metallinen: WURTH 4971200329 + 4971050329 (20 mm + 5 mm korotusruuvit)

XAMK

Project | Part number Jouko V1.0 | Description | Rev

Designed By Date 9.7.2018 | Checked By Date | Approved By Date | Sheet 1 /2

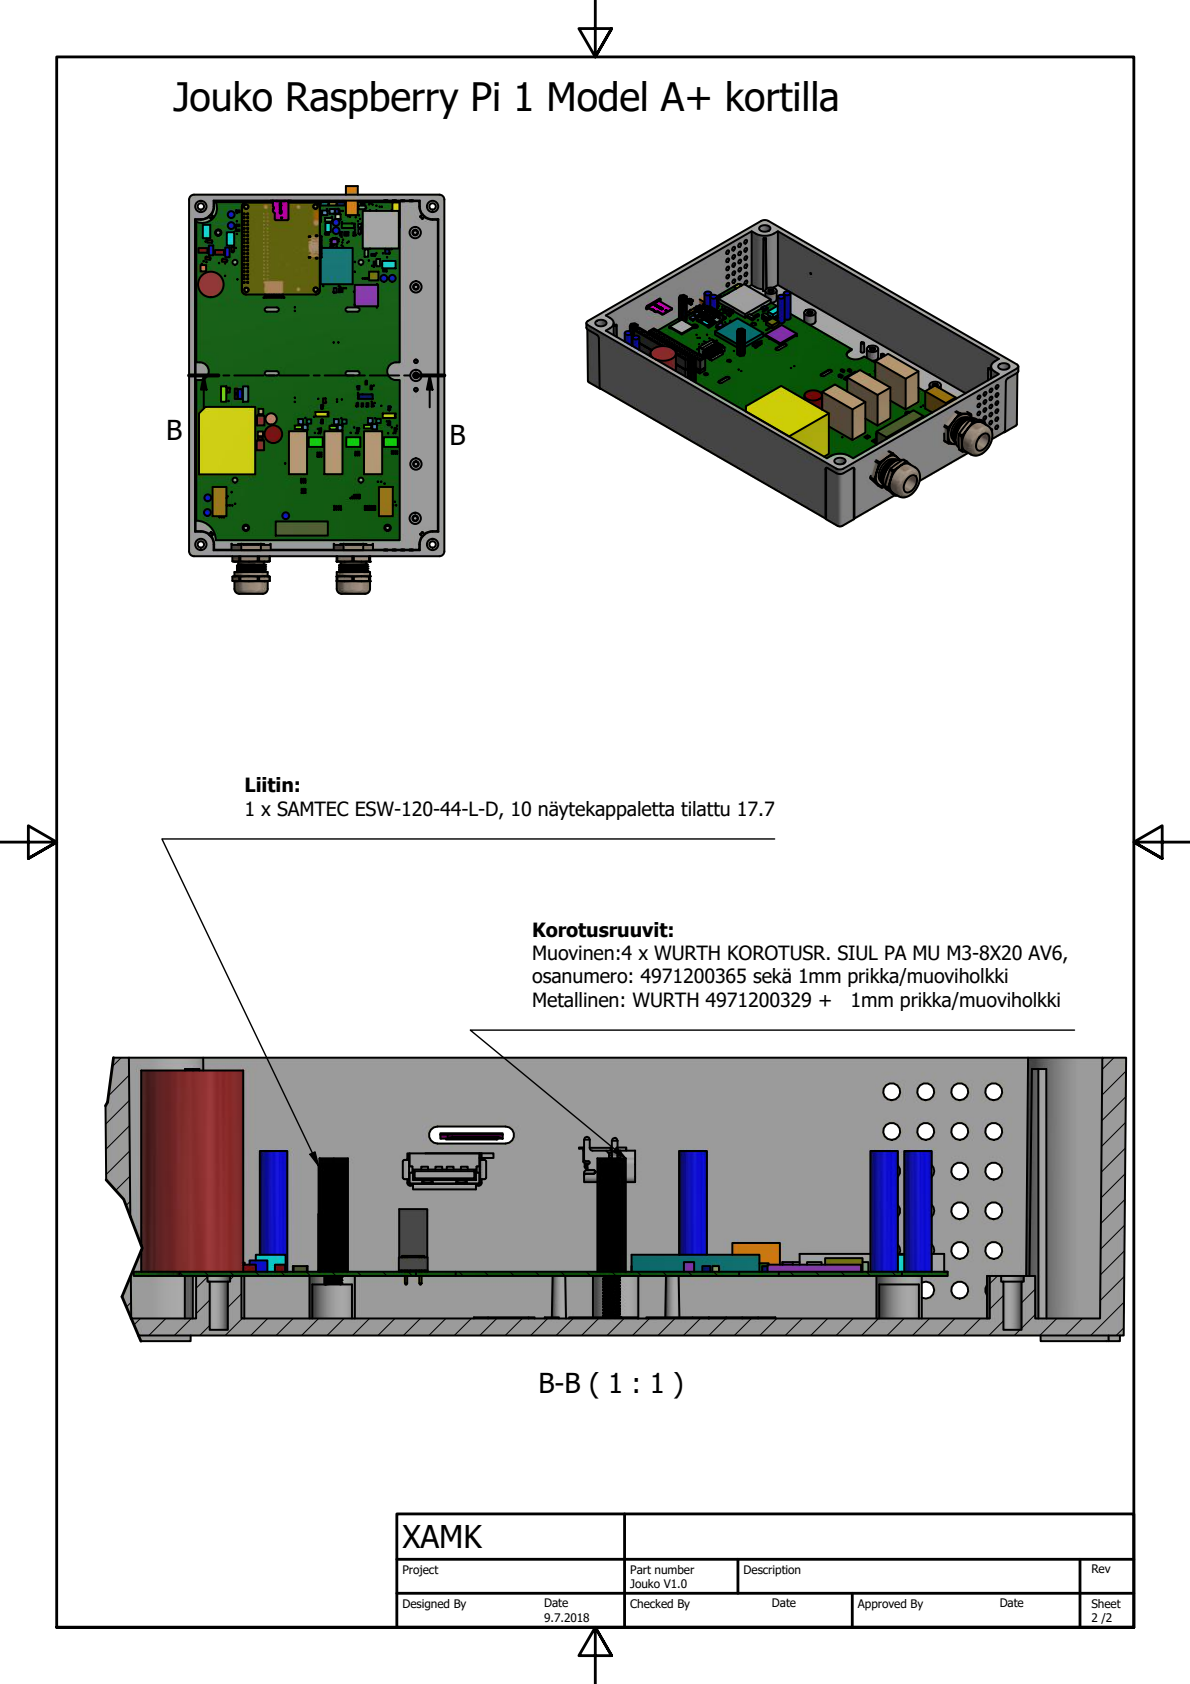
[picture p55: page 2]

Jouko Raspberry Pi 1 Model A+ kortilla

Liitin:
1 x SAMTEC ESW-120-44-L-D, 10 nlytekappaletta tilattu 17.7

Korotusruuvit:
Muovinen:4 x WURTH KOROTUSR. SIUL PA MU M3-8X20 AV6,
osanumero: 4971200365 sekl 1mm prikka/muoviholkki
Metallinen: WURTH 4971200329 + 1mm prikka/muoviholkki

XAMK

Project | Part number Jouko V1.0 | Description | Rev

Designed By Date 9.7.2018 | Checked By Date | Approved By Date | Sheet 2 /2
