Teukka/FlexHomeElPower/HW_Descriptions/Voltage Source for GSM 2G/JouKo 5 V Source EMI Shield Box Drawing.pdf

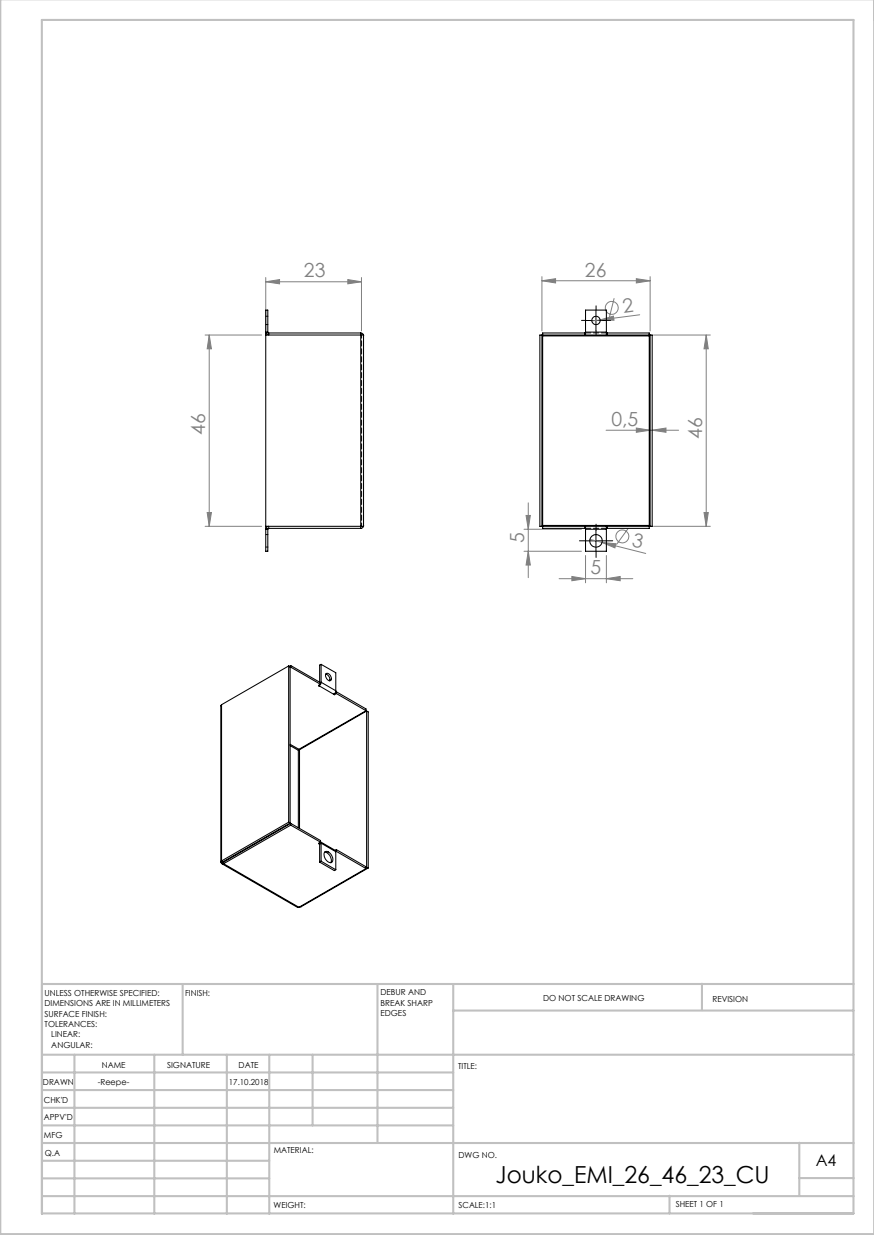
[picture p56: page 1]
SCALE:1:1; SHEET 1 OF 1; DO NOT SCALE DRAWING; REVISION; DEBUR AND BREAK SHARP; UNLESS OTHERWISE SPECIFIED:; FINISH:

DIMENSIONS ARE IN MILLIMETERS
SURFACE FINISH:
TOLERANCES:
LINEAR:
ANGULAR:

NAME | SIGNATURE | DATE | | | | TITLE:

DRAWN | -Reepe- | | 17.10.2018
CHK'D
APPV'D
MFG
Q.A | | | | MATERIAL: | DWG NO. Jouko_EMI_26_46_23_CU | A4
