Teukka/FlexHomeElPower/Manufacturing/Mechanics/XAMK FIBOX_MNX200HB Jouko päätysapluunat.pdf

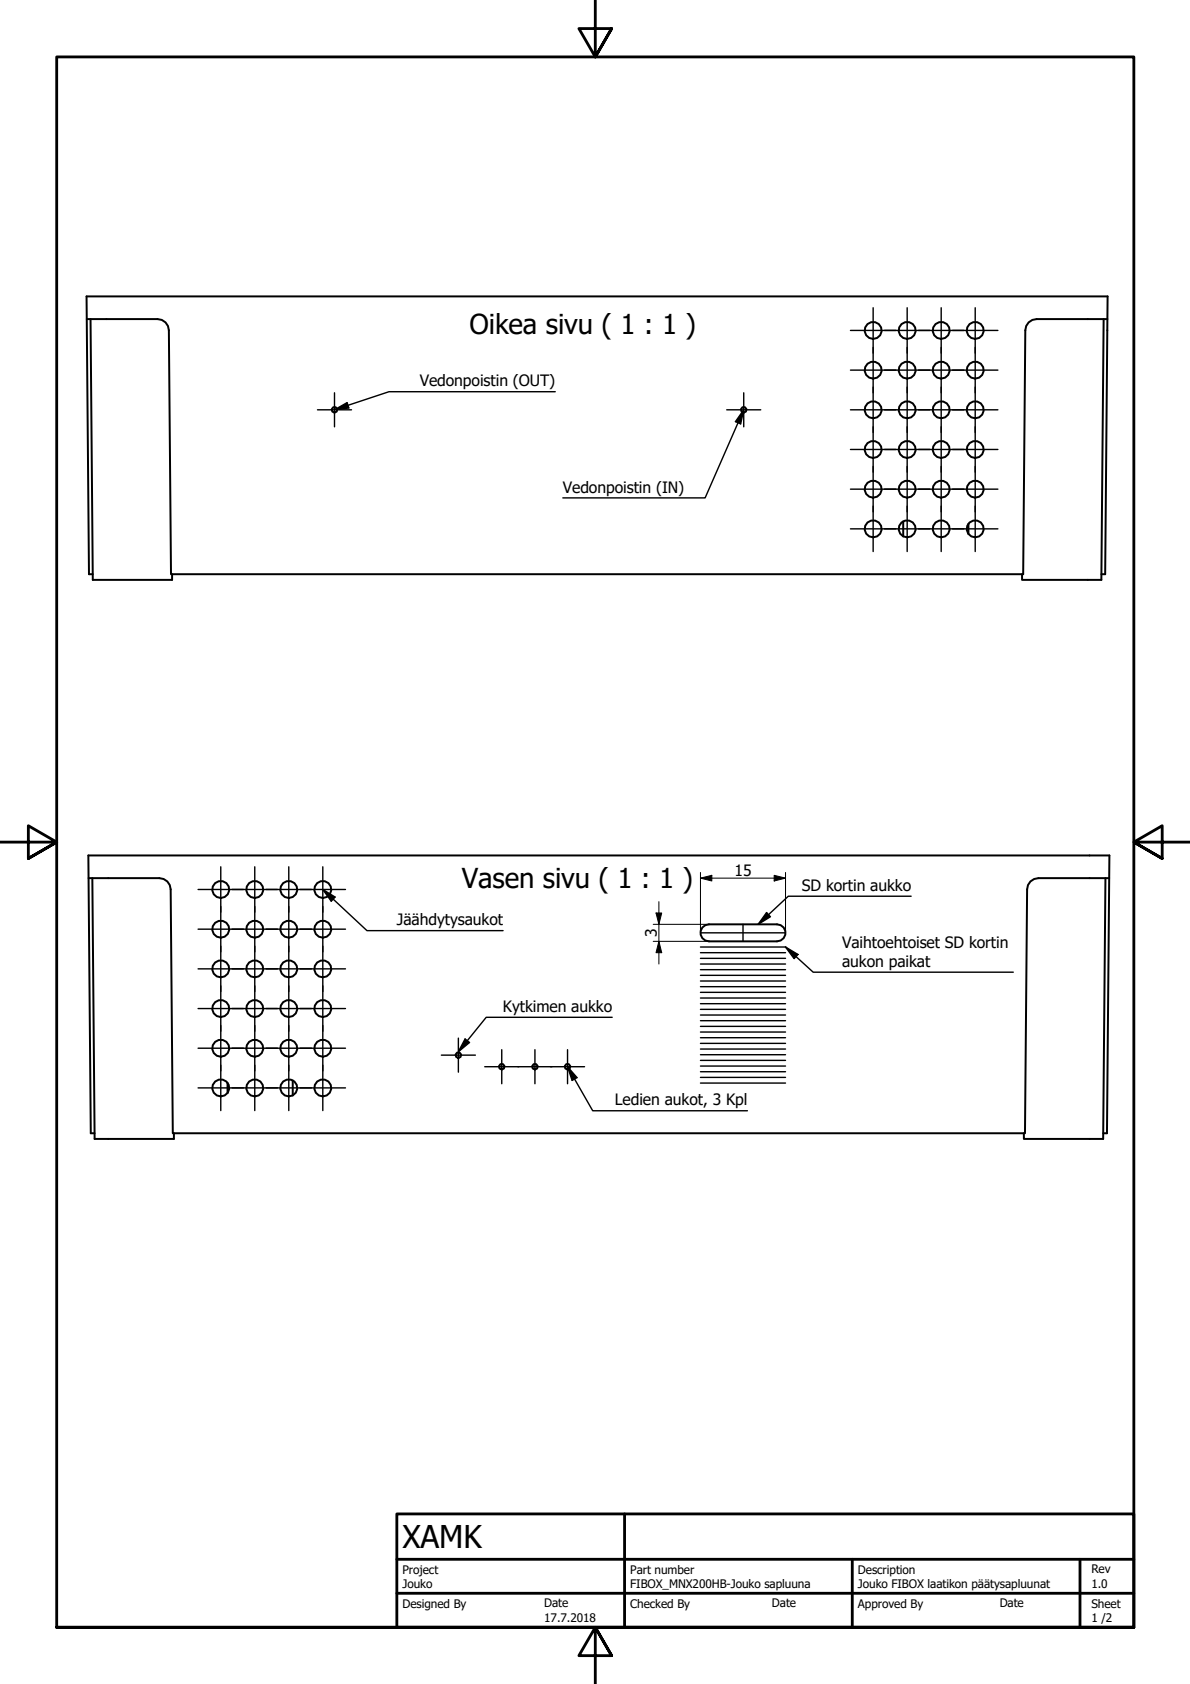
[picture p57: page 1]
Oikea sivu ( 1 : 1 ); Vasen sivu ( 1 : 1 ); Kytkimen aukko; Vedonpoistin (IN); Vedonpoistin (OUT)

SD kortin aukko

Vaihtoehtoiset SD kortin
aukon paikat

Ledien aukot, 3 Kpl

XAMK

Project Jouko | Part number FIBOX_MNX200HB-Jouko sapluuna | Description Jouko FIBOX laatikon plltysapluunat | Rev 1.0

Designed By Date 17.7.2018 | Checked By Date | Approved By Date | Sheet 1 /2

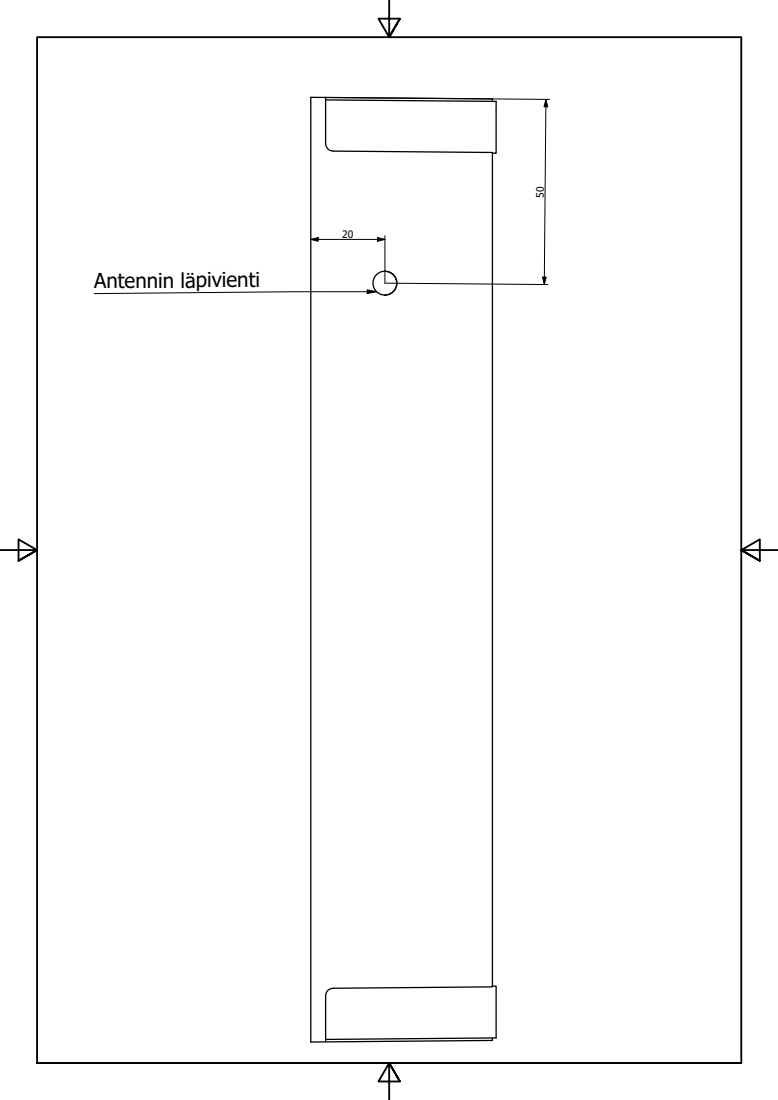
[picture p58: page 2]
