Teukka/FlexHomeElPower/Manufacturing/Electronics/Schematics/JouKo product family schematics K4159100.pdf

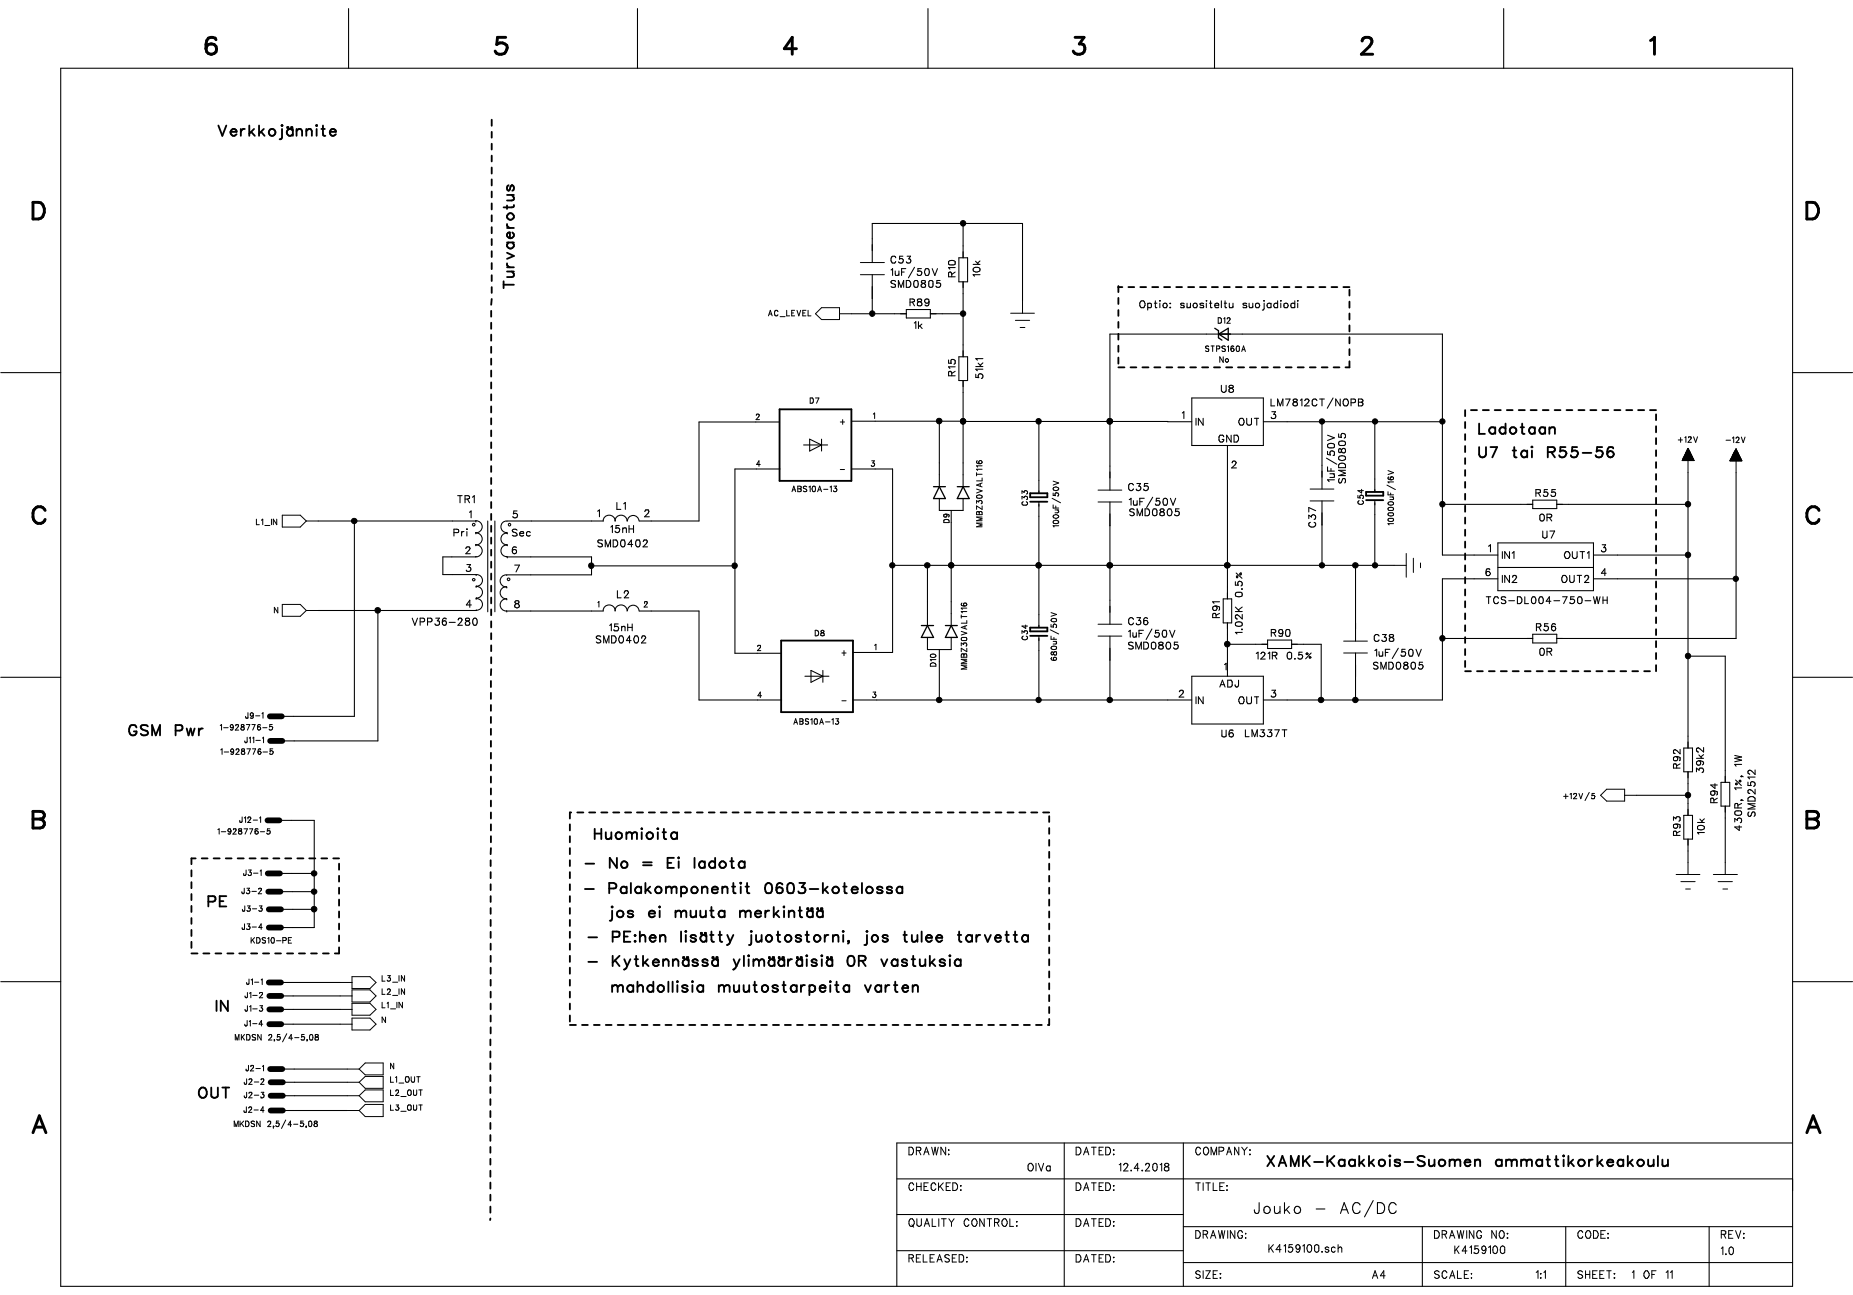
[picture p72: page 1]

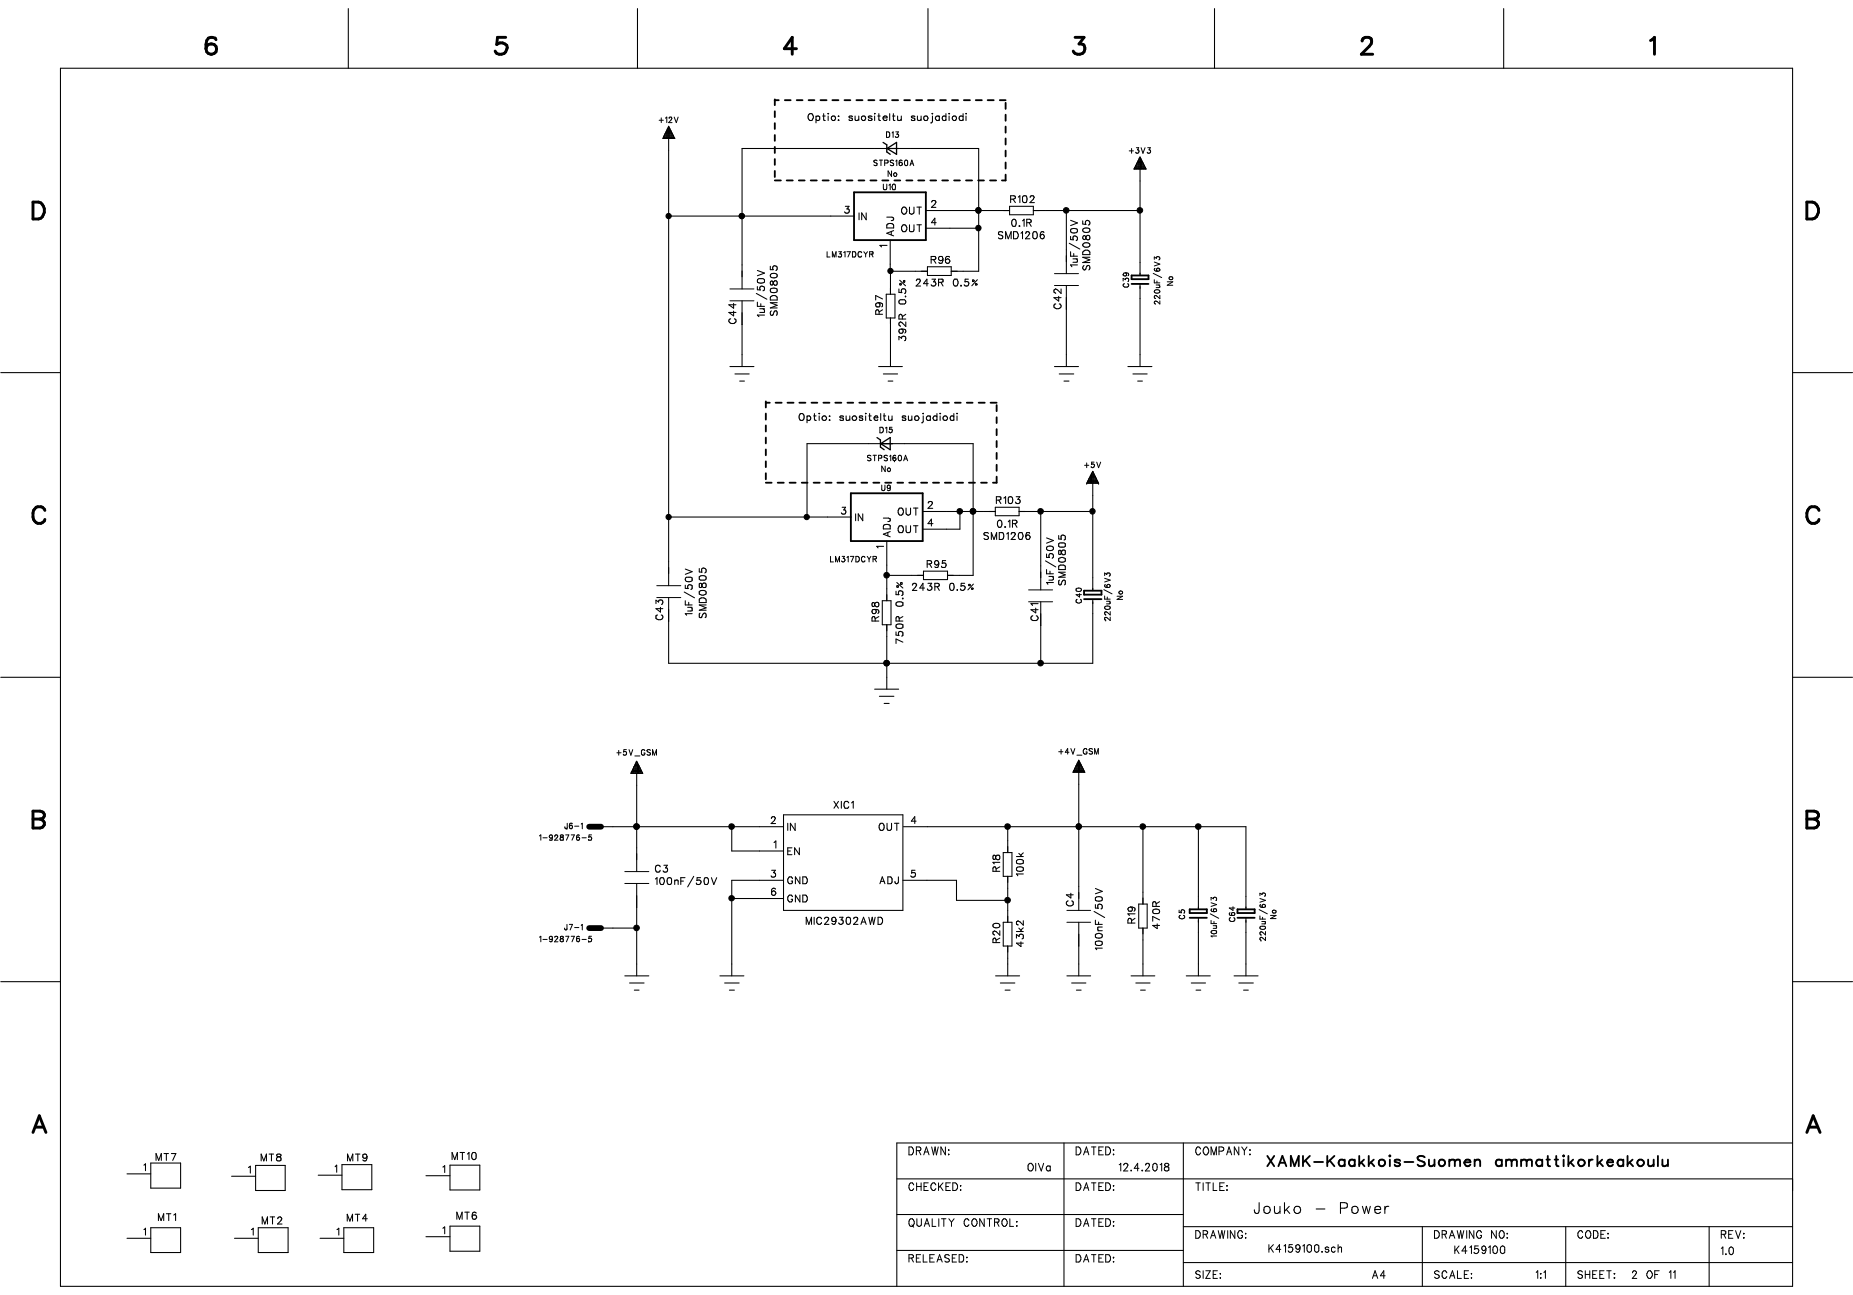
[picture p73: page 2]

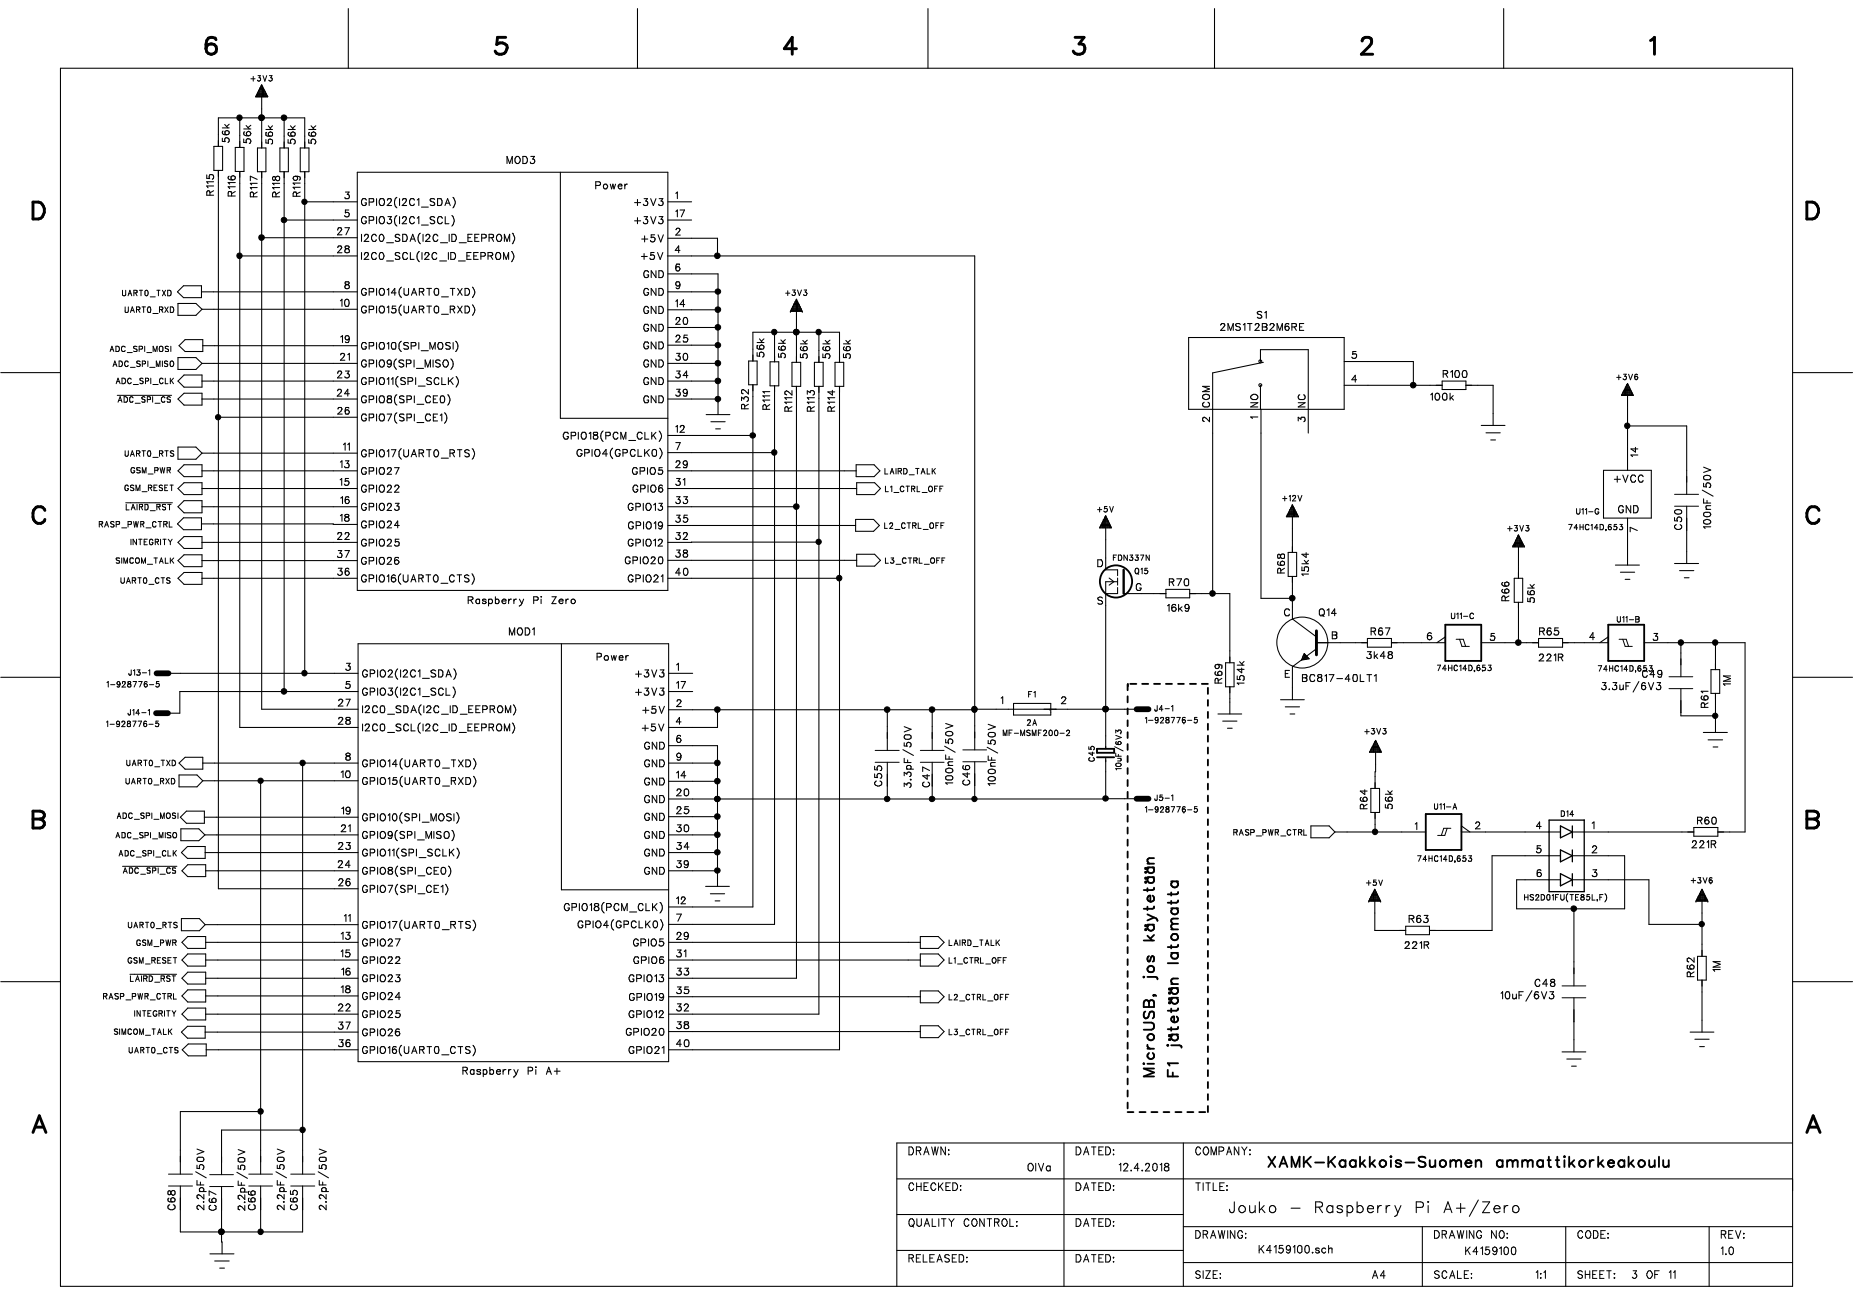
[picture p74: page 3]

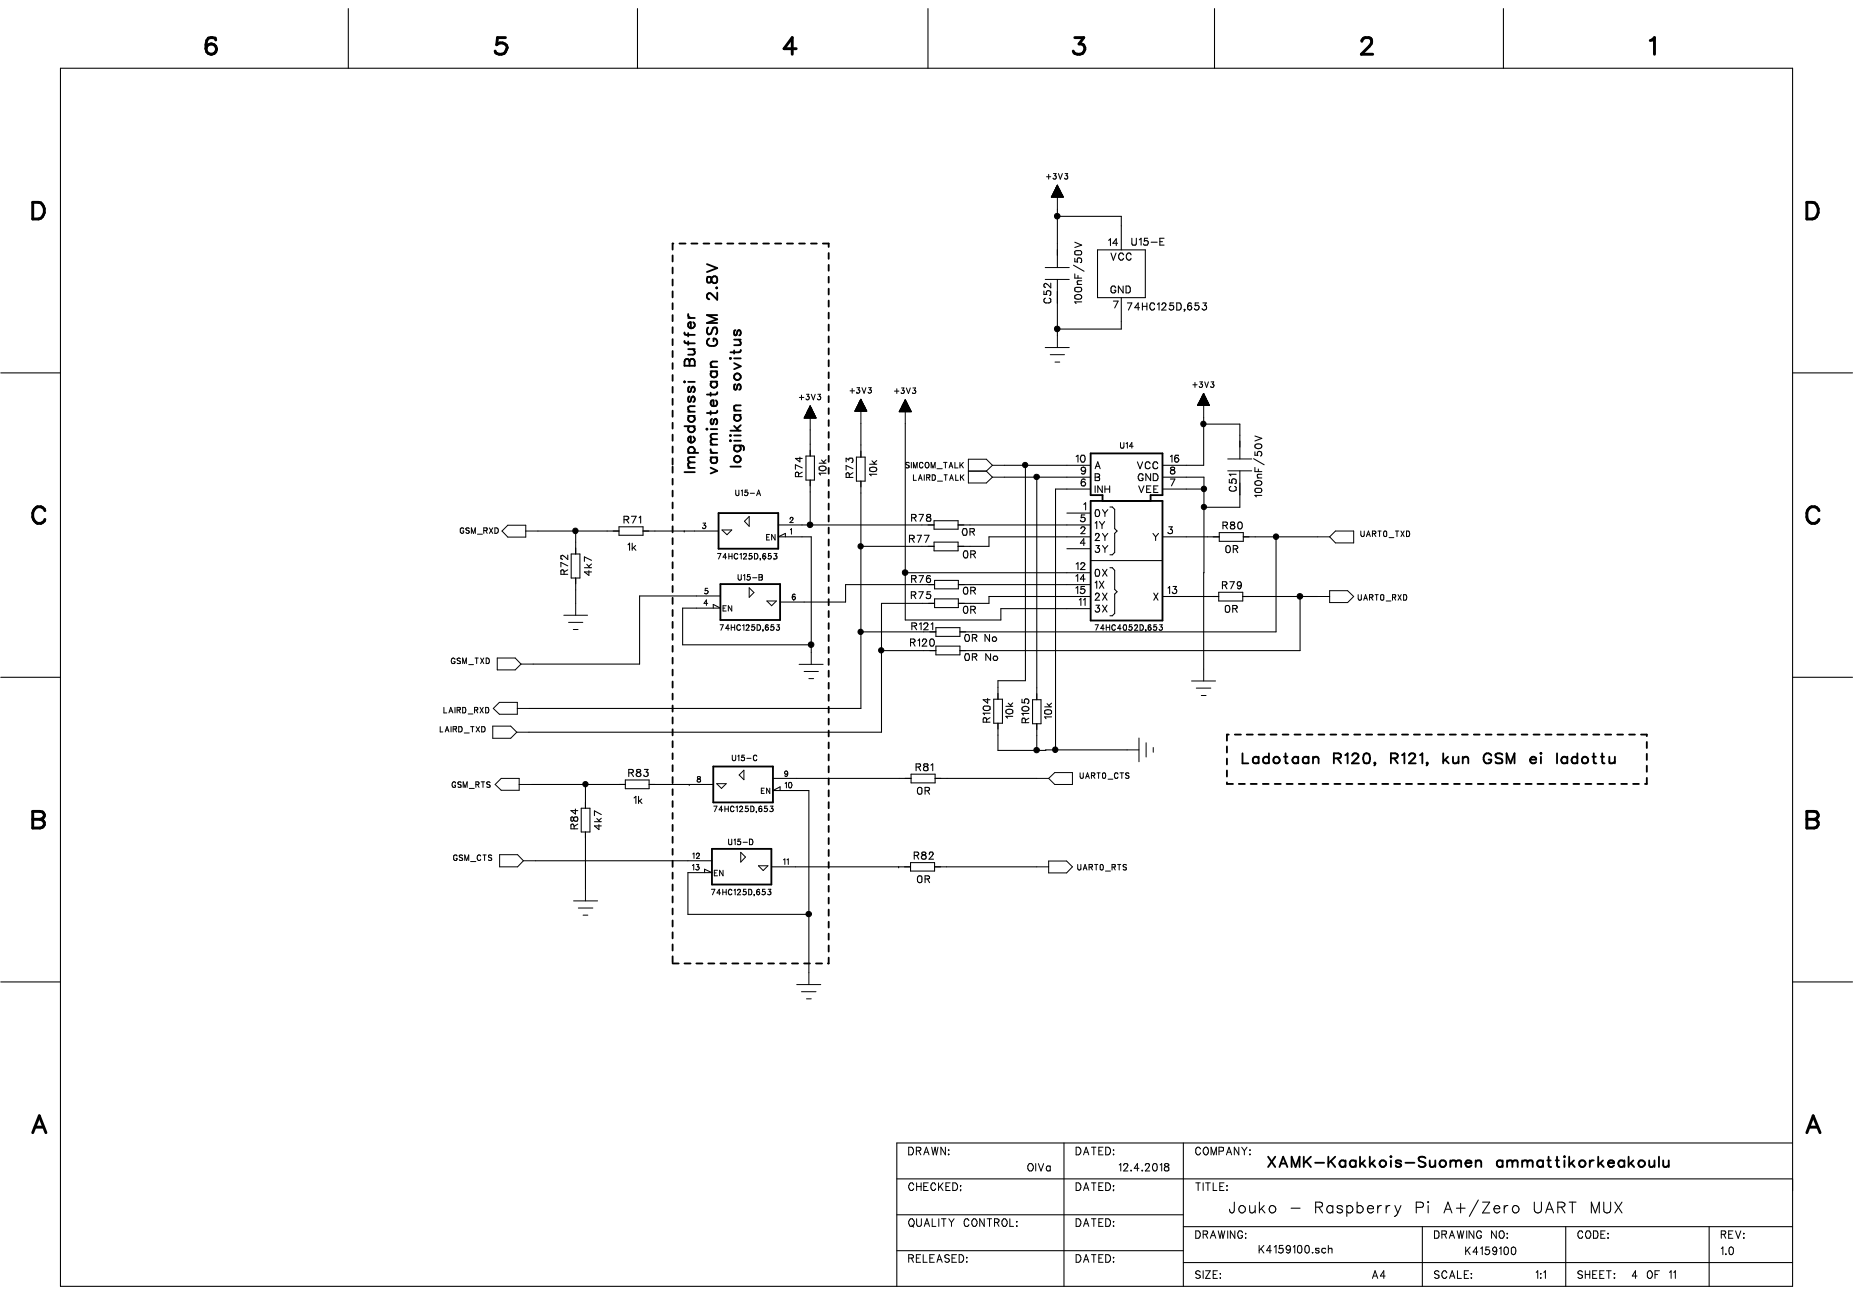
[picture p75: page 4]


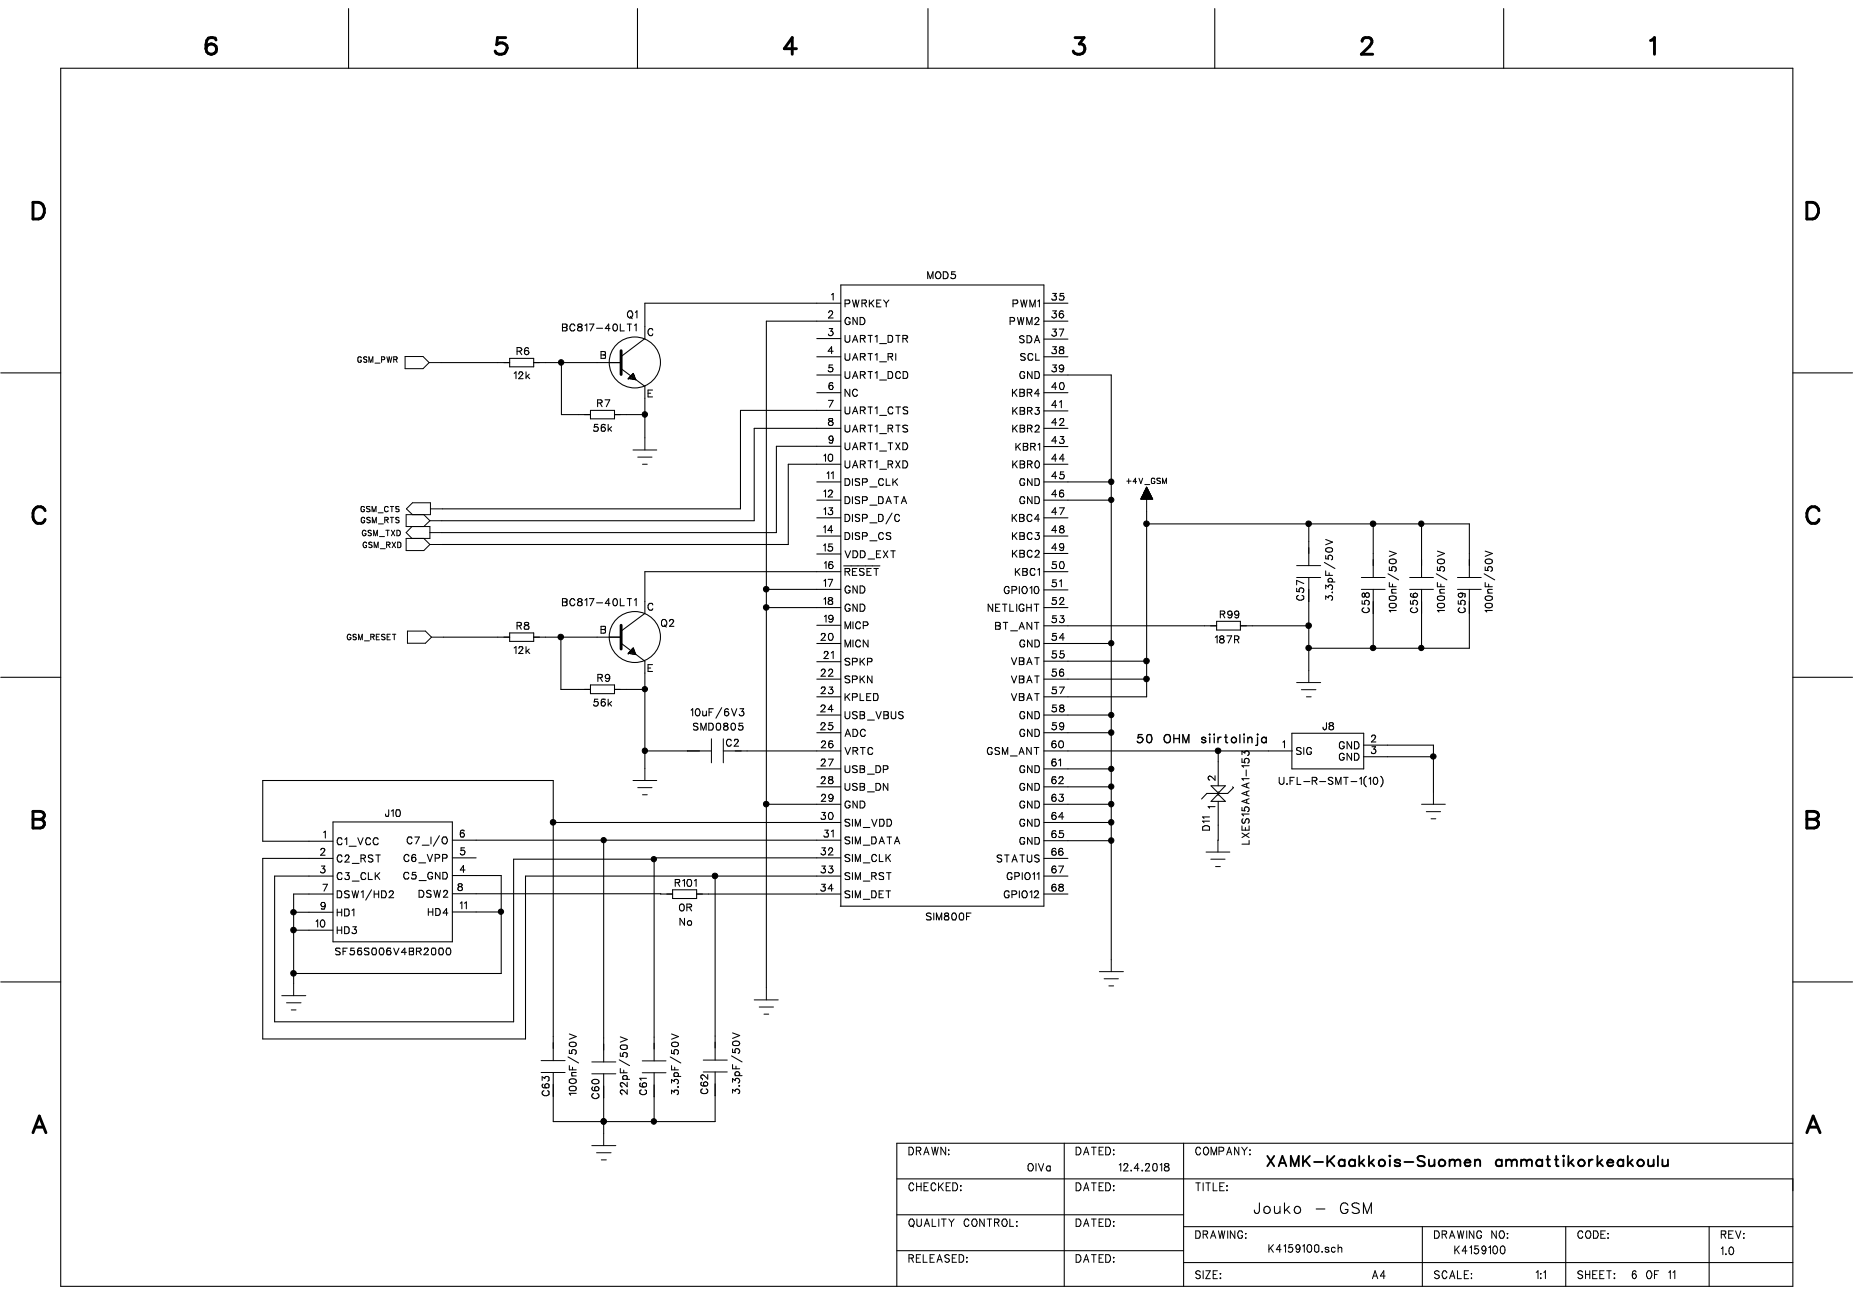
[picture p76: page 6]


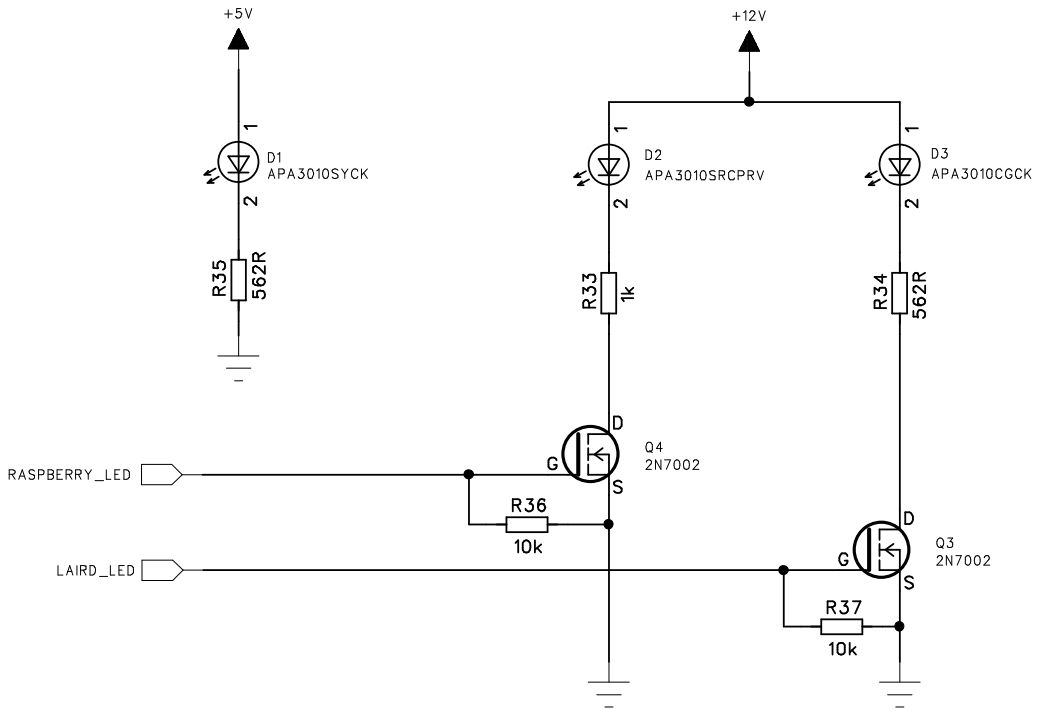
[picture p77: page 8]

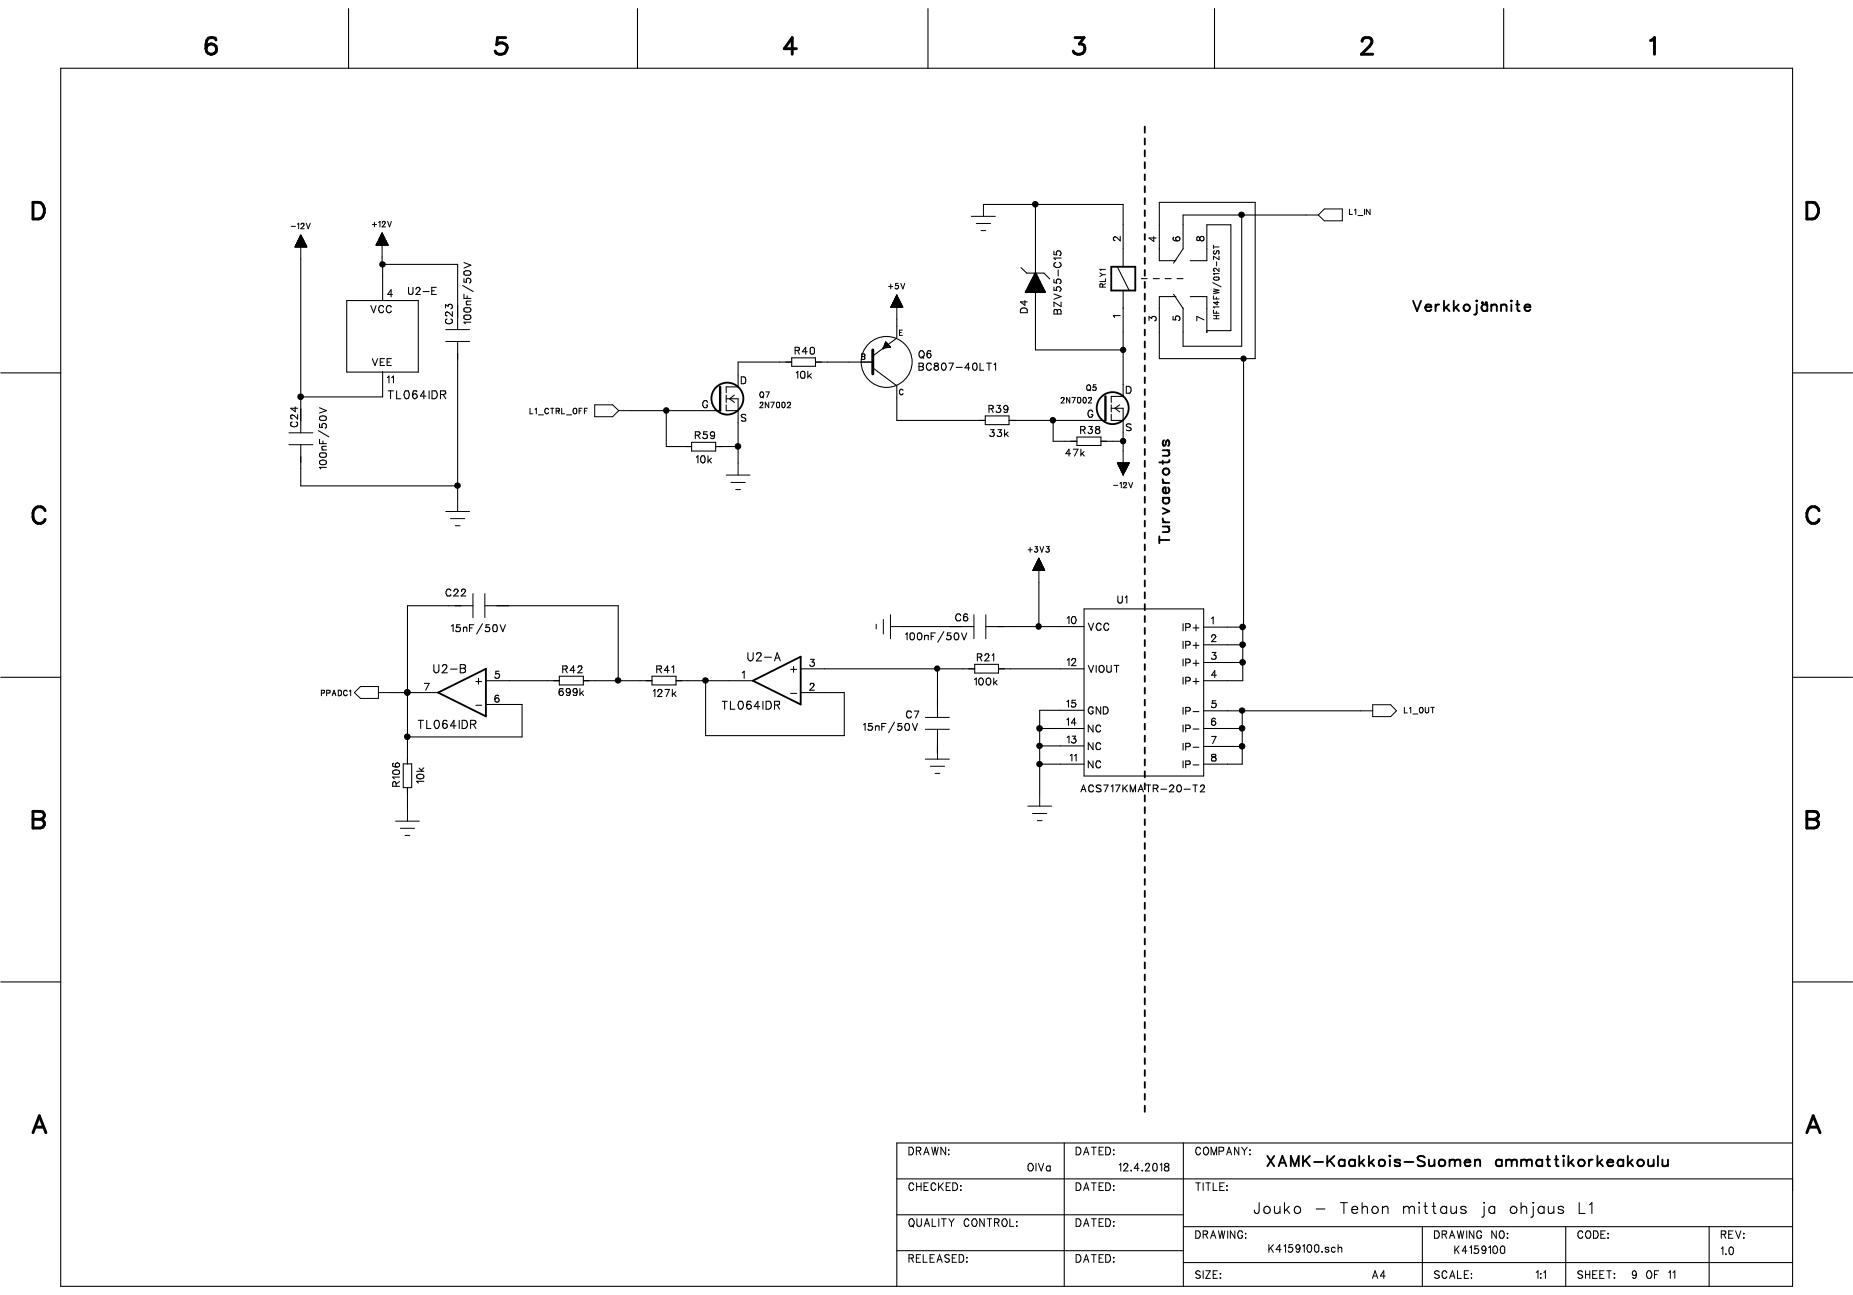
[picture p78: page 9]

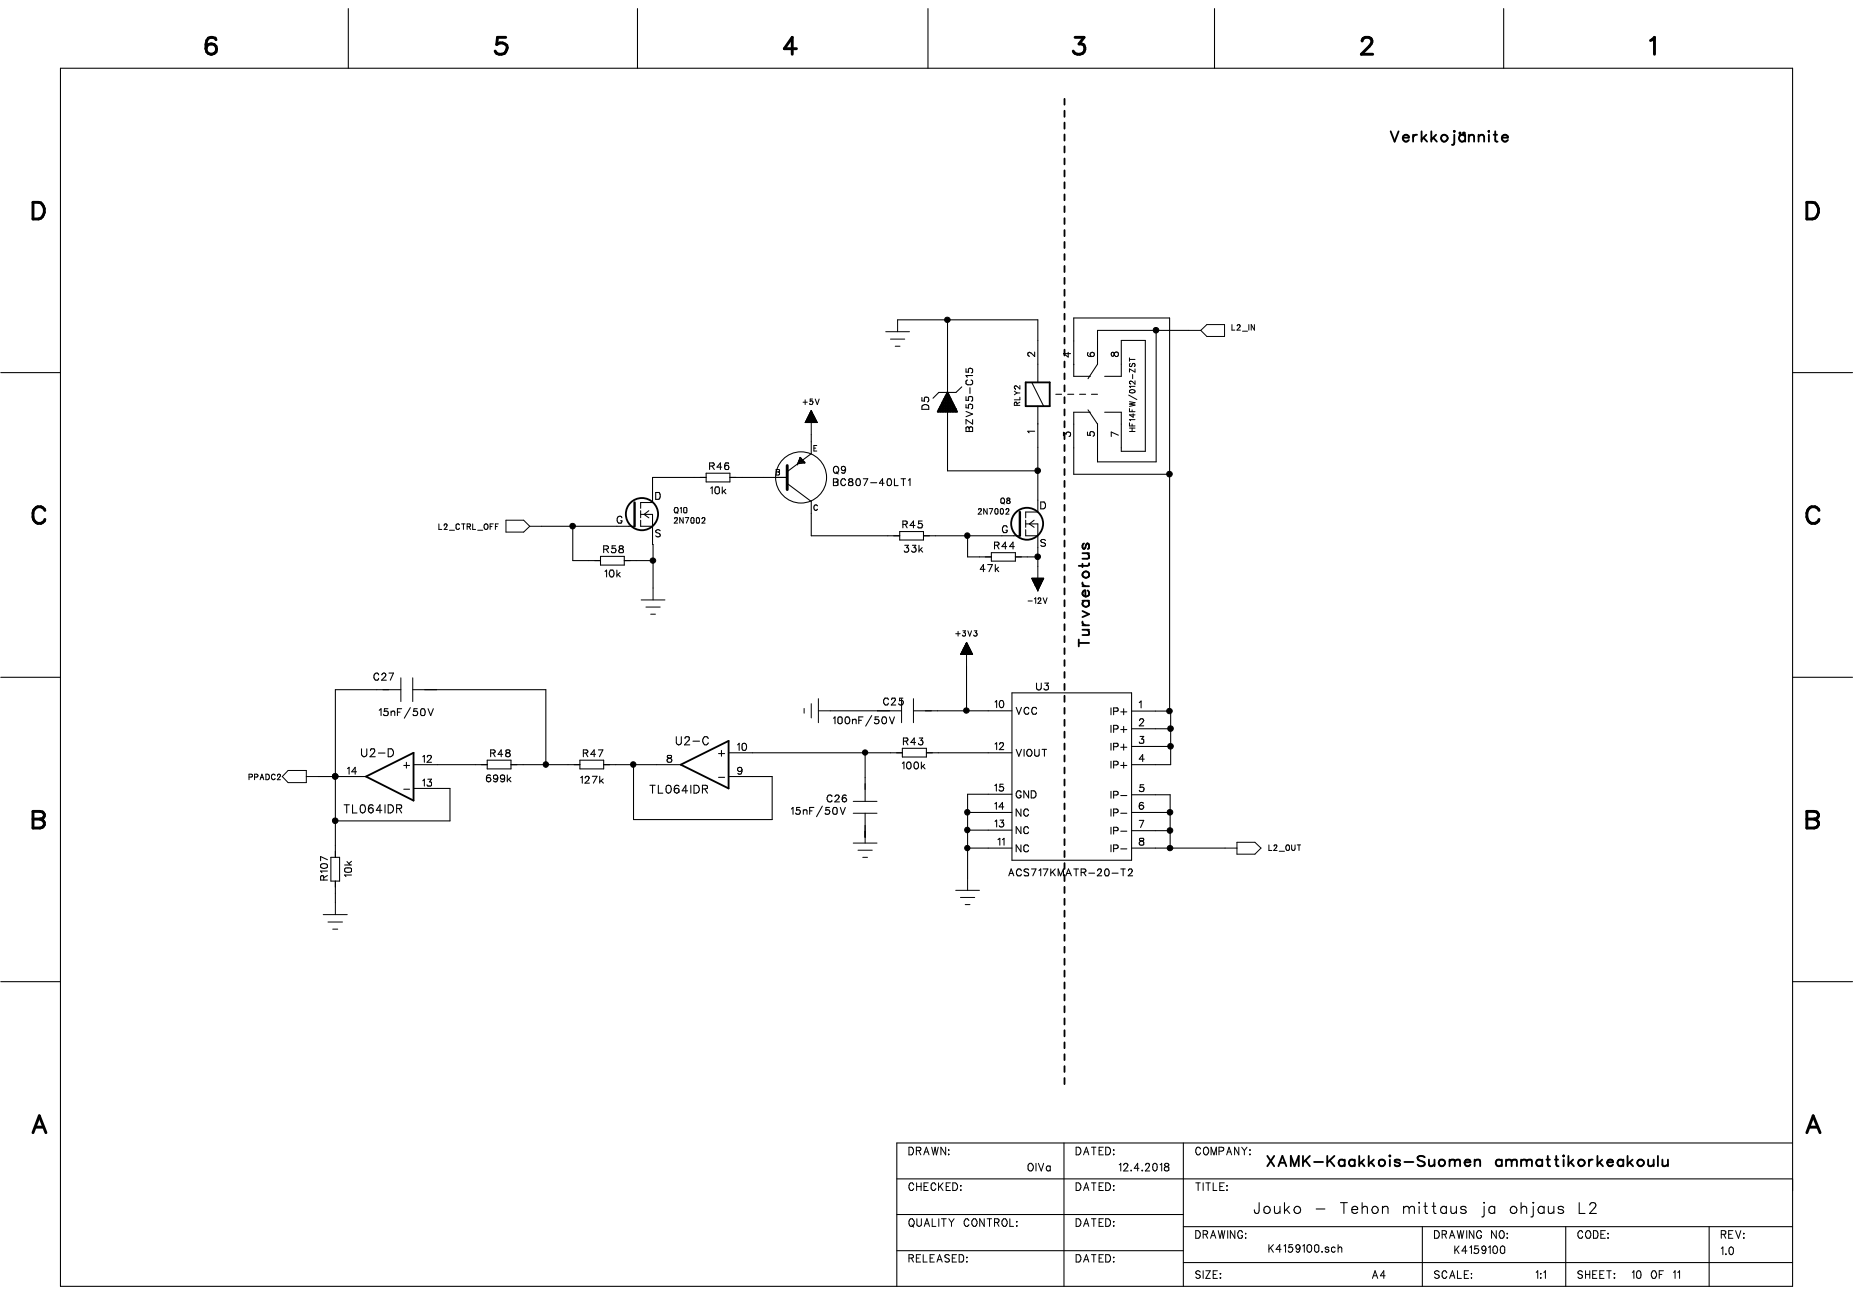
[picture p79: page 10]

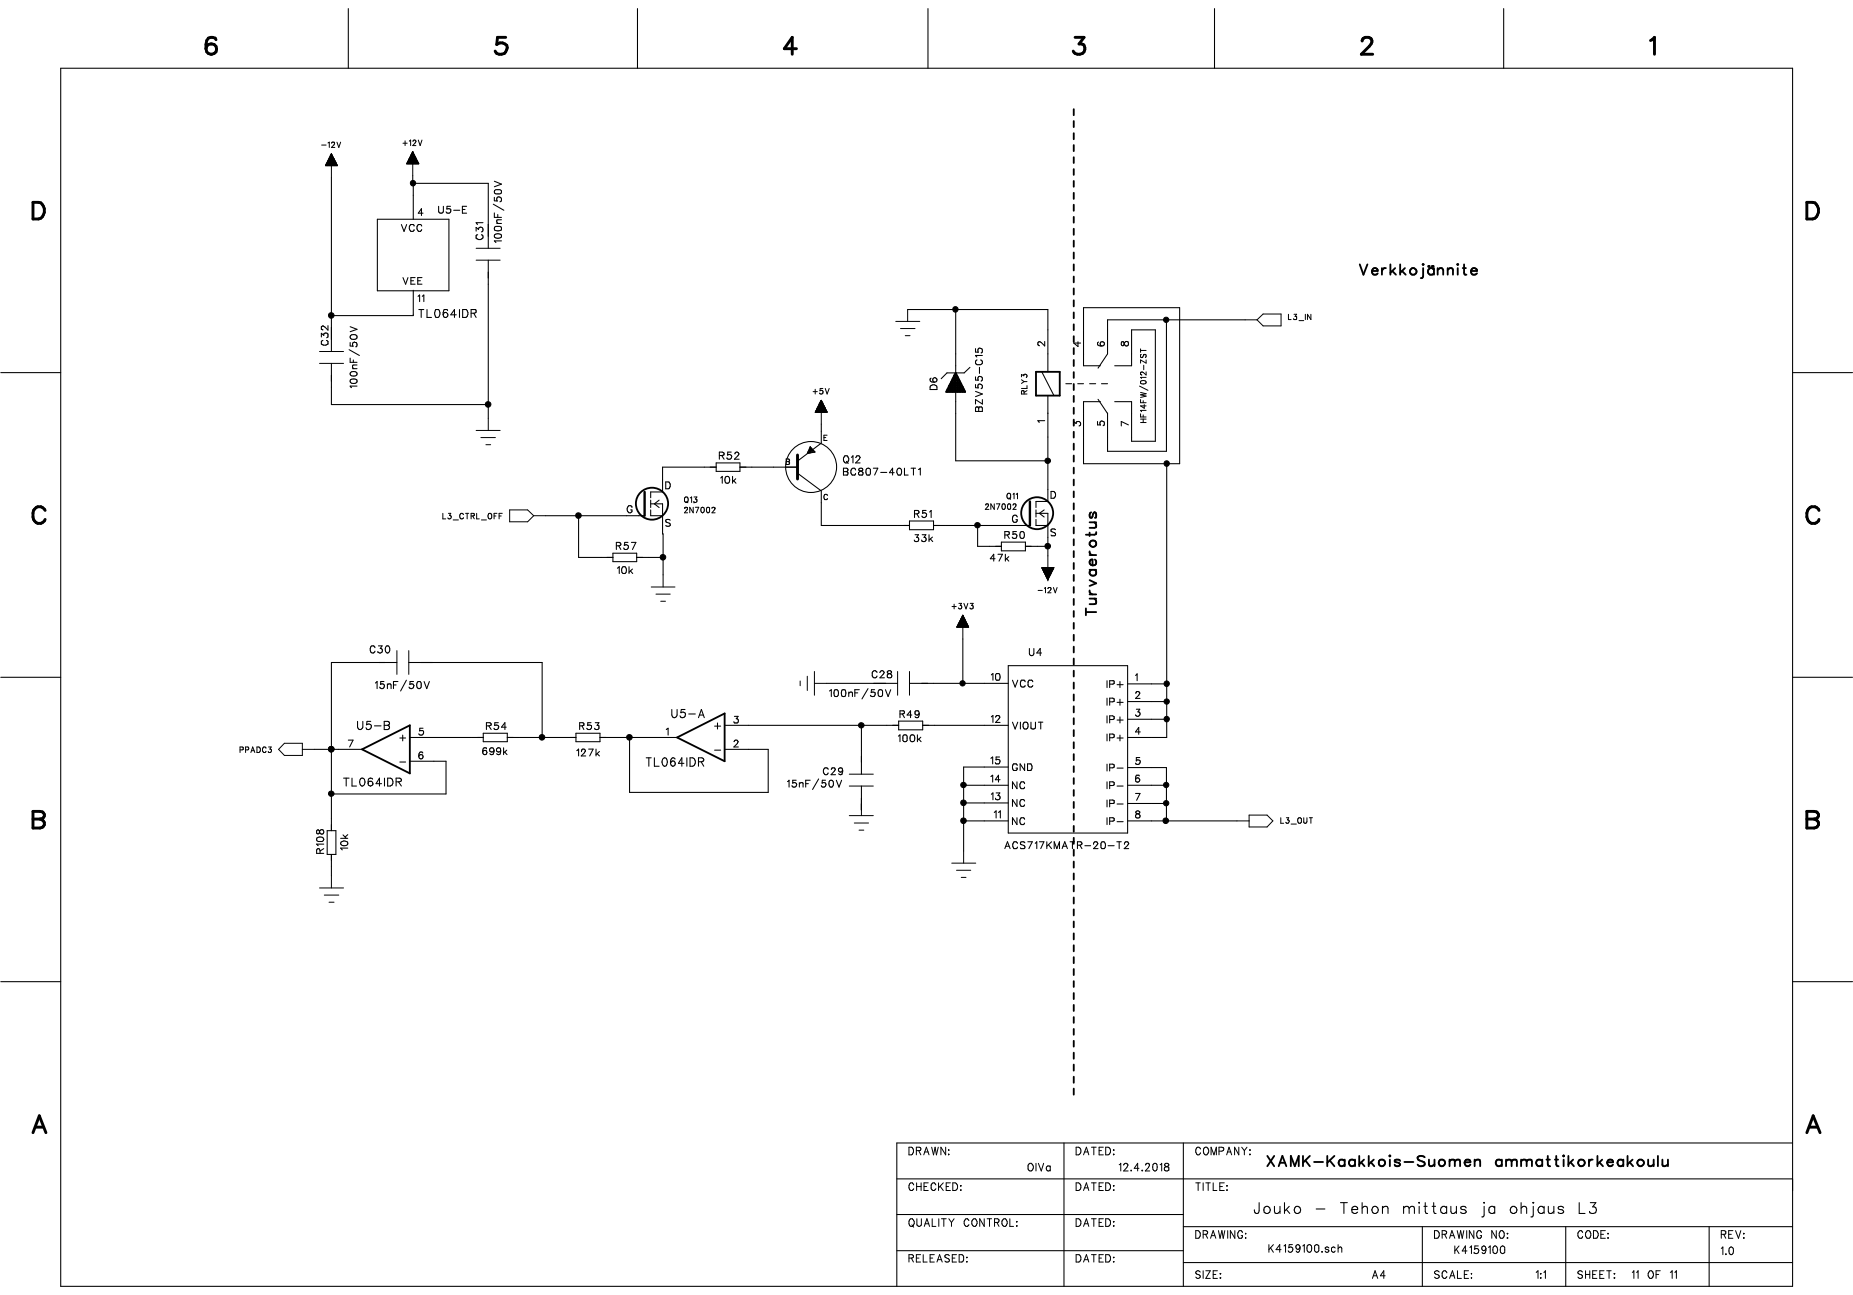
[picture p80: page 11]
