Teukka/FlexHomeElPower/Manufacturing/Electronics/Surface Mount Assembly/Osasijoittelu_P4159100.pdf

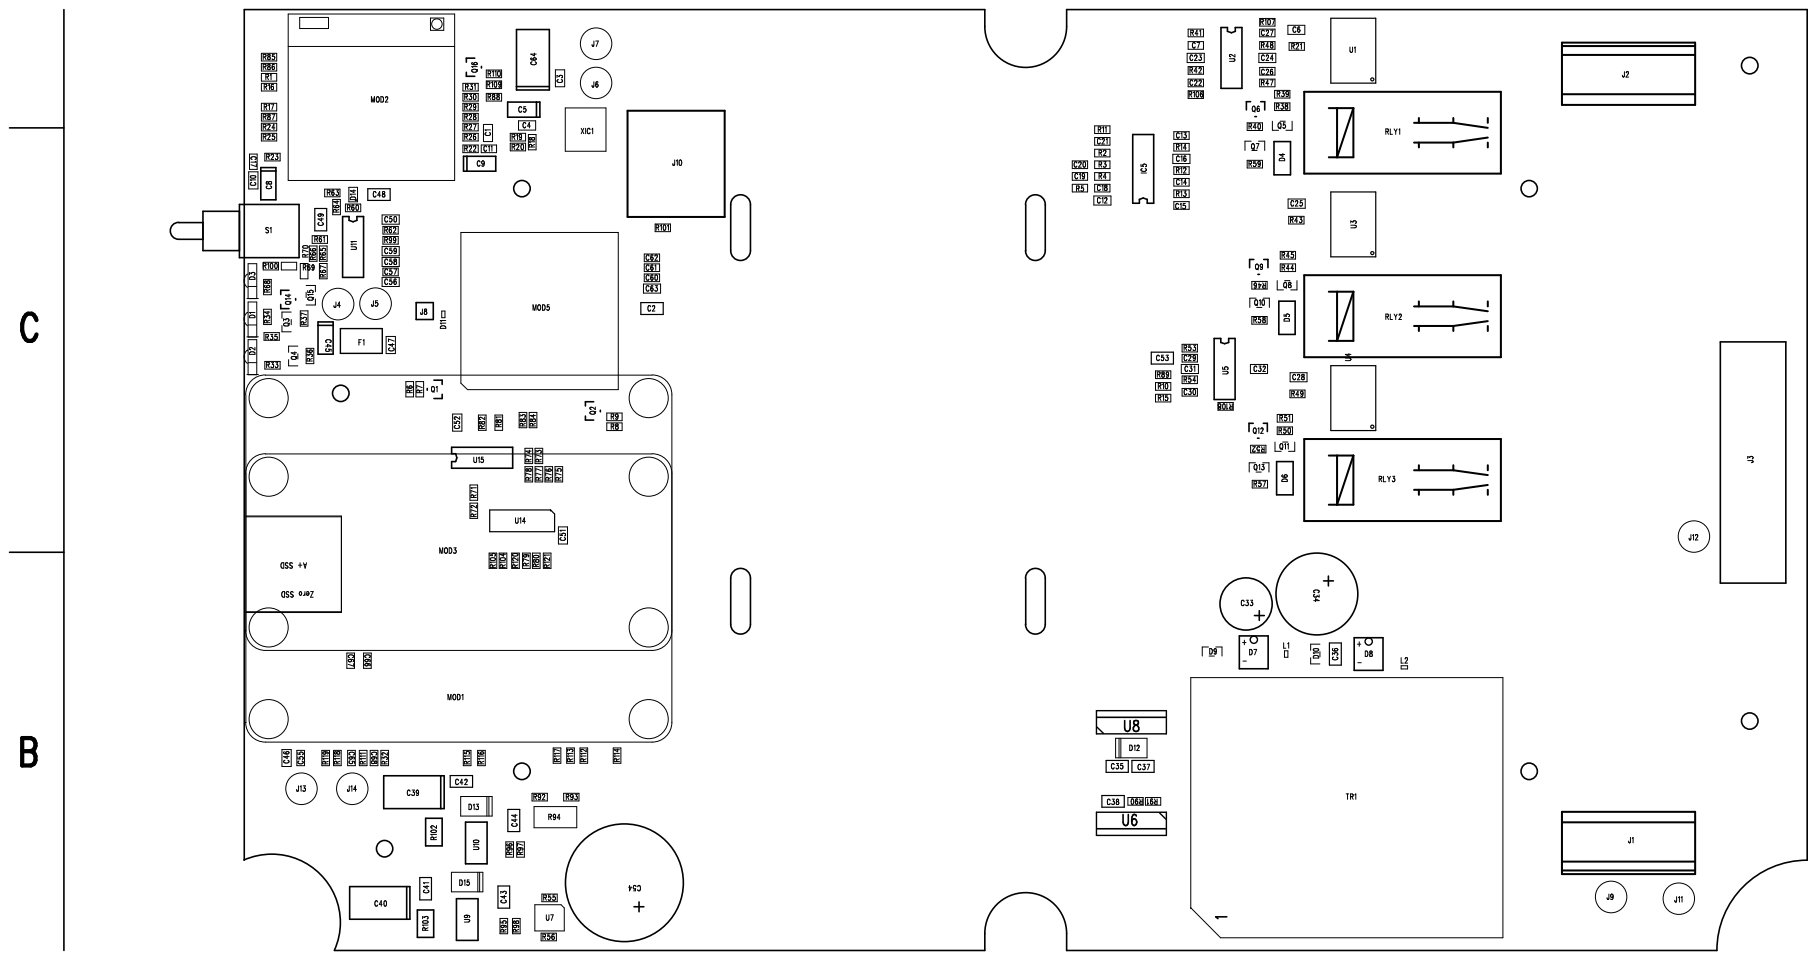
[picture p81: page 1]
