Teukka/FlexHomeElPower/Manufacturing/Electronics/Printed Circuit Board Design/Layer PDFs/Board Outline.pdf

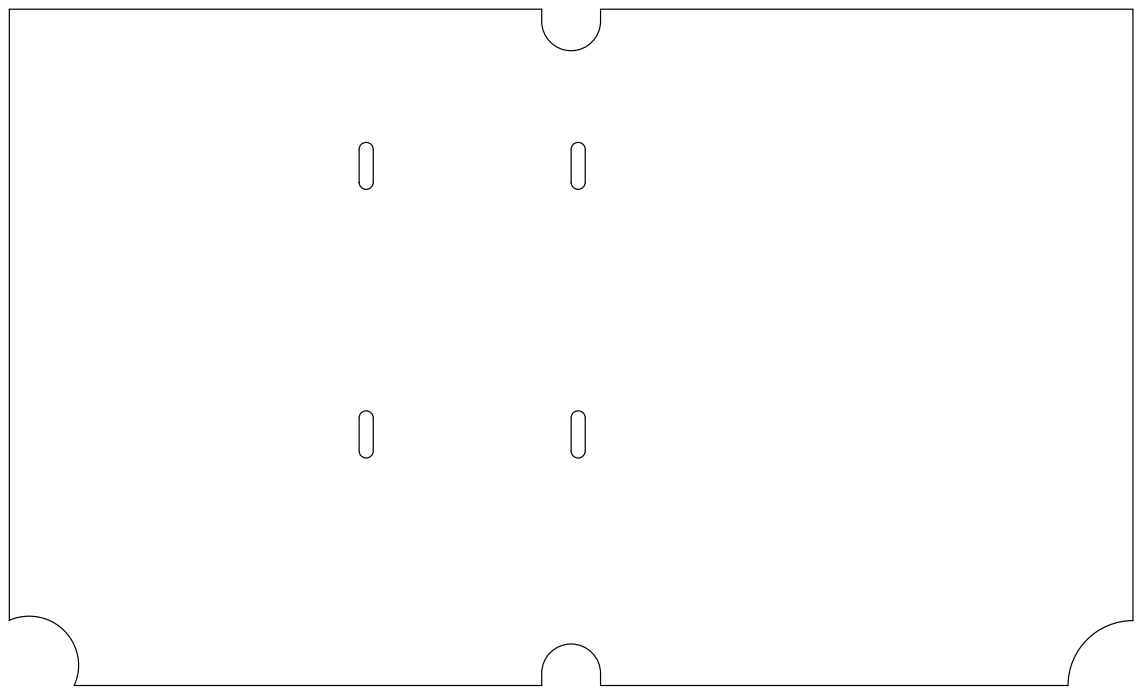
[picture p82: page 1]
