Teukka/FlexHomeElPower/Manufacturing/Electronics/Printed Circuit Board Design/Layer PDFs/Drill Drawing Top.pdf

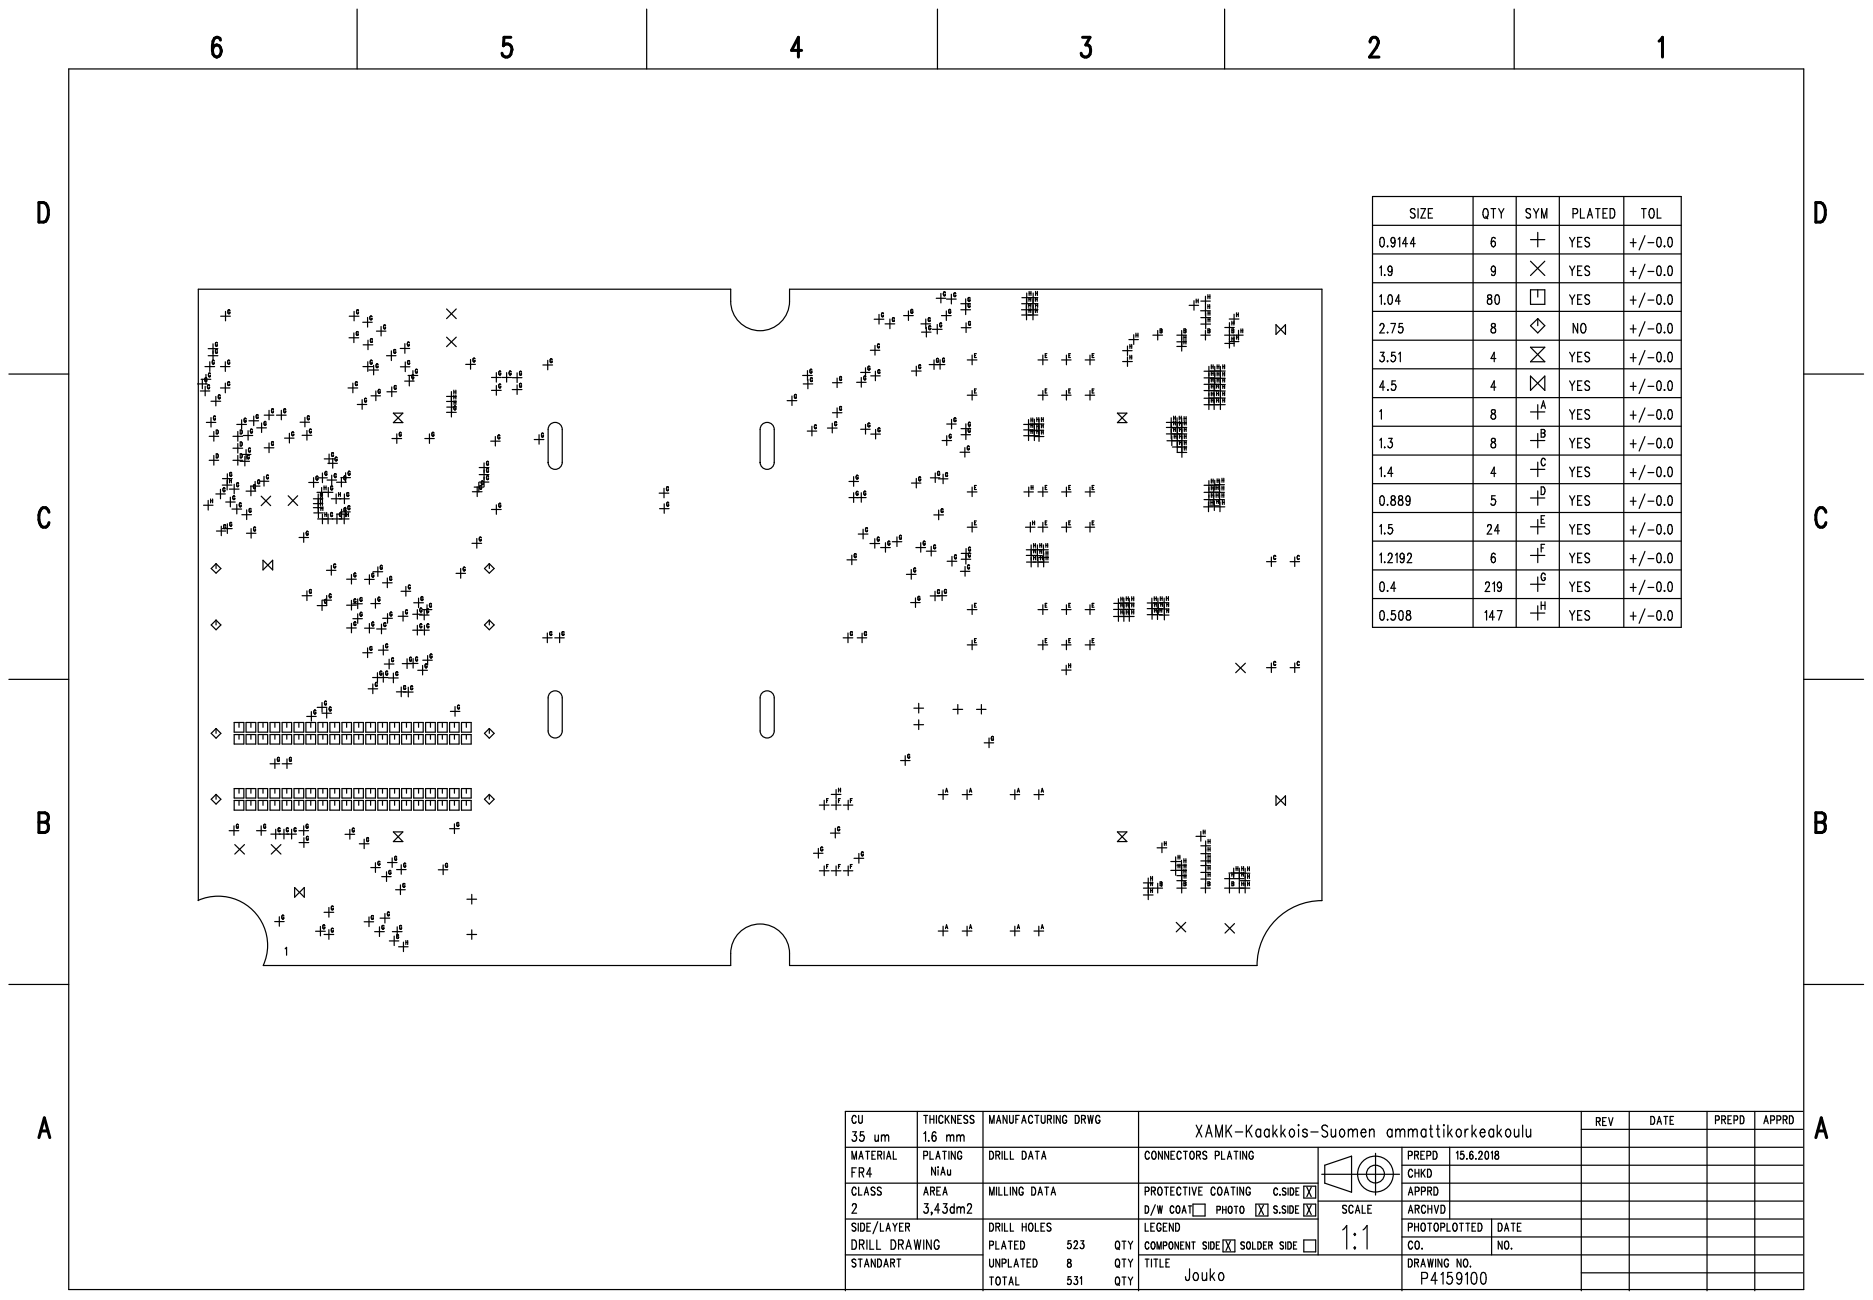
[picture p83: page 1]
