Teukka/FlexHomeElPower/Manufacturing/Electronics/Printed Circuit Board Design/Layer PDFs/JouKo Routing Bottom.pdf

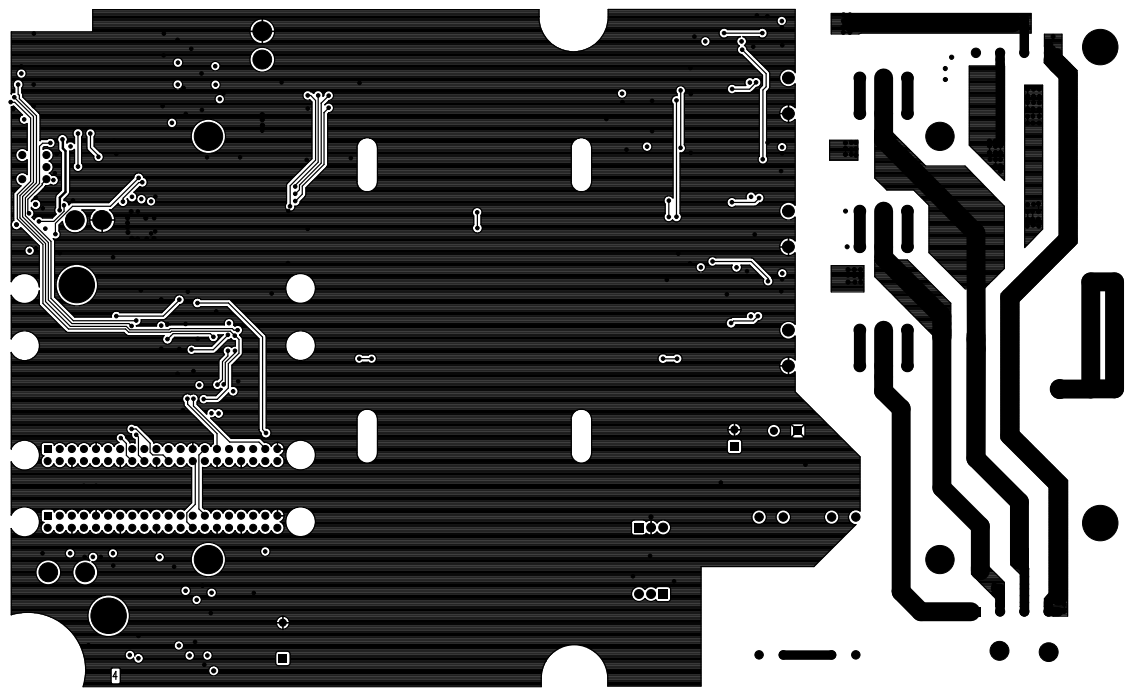
[picture p84: page 1]
