Teukka/FlexHomeElPower/Manufacturing/Electronics/Printed Circuit Board Design/Layer PDFs/JouKo Routing Top.pdf

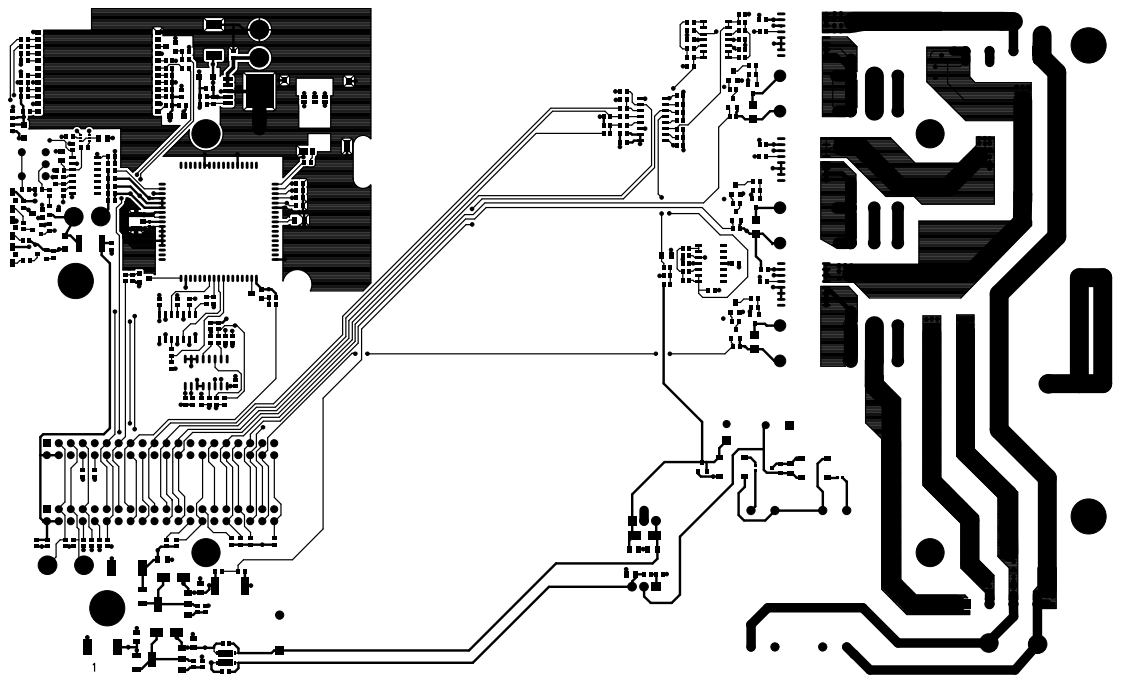
[picture p85: page 1]
