Teukka/FlexHomeElPower/Manufacturing/Electronics/Printed Circuit Board Design/Layer PDFs/JouKo Silkscreen Top.pdf

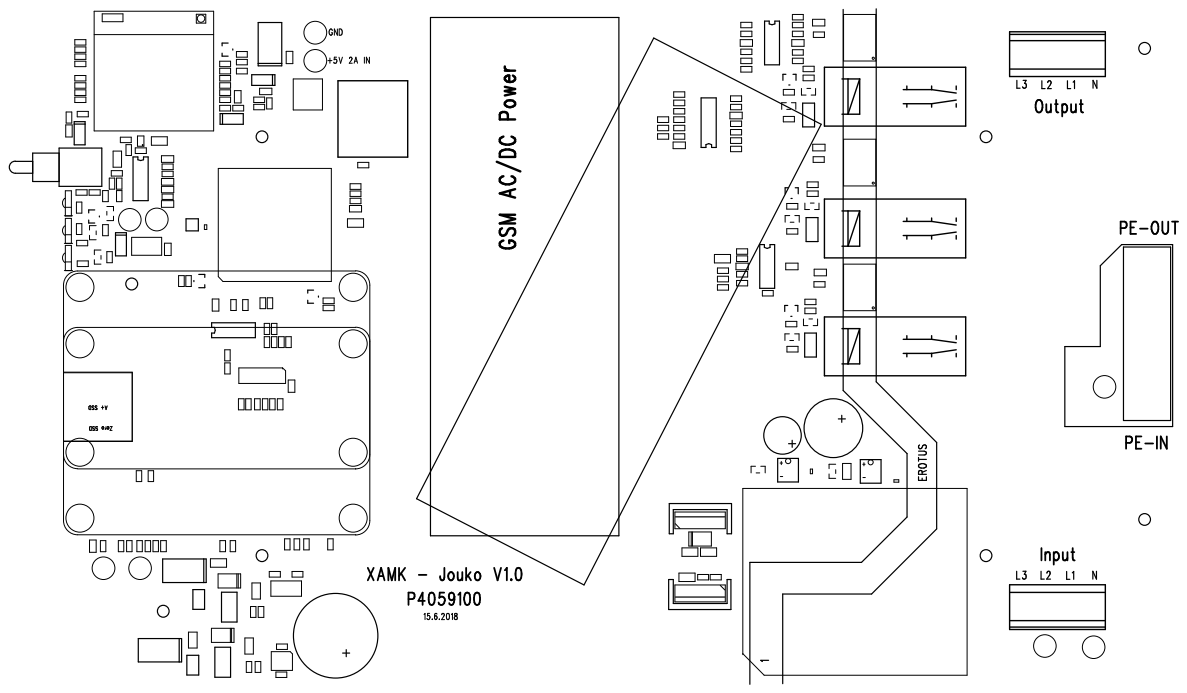
[picture p86: page 1]
