Teukka/FlexHomeElPower/Manufacturing/Electronics/Printed Circuit Board Design/Layer PDFs/Layer2_GND.pdf

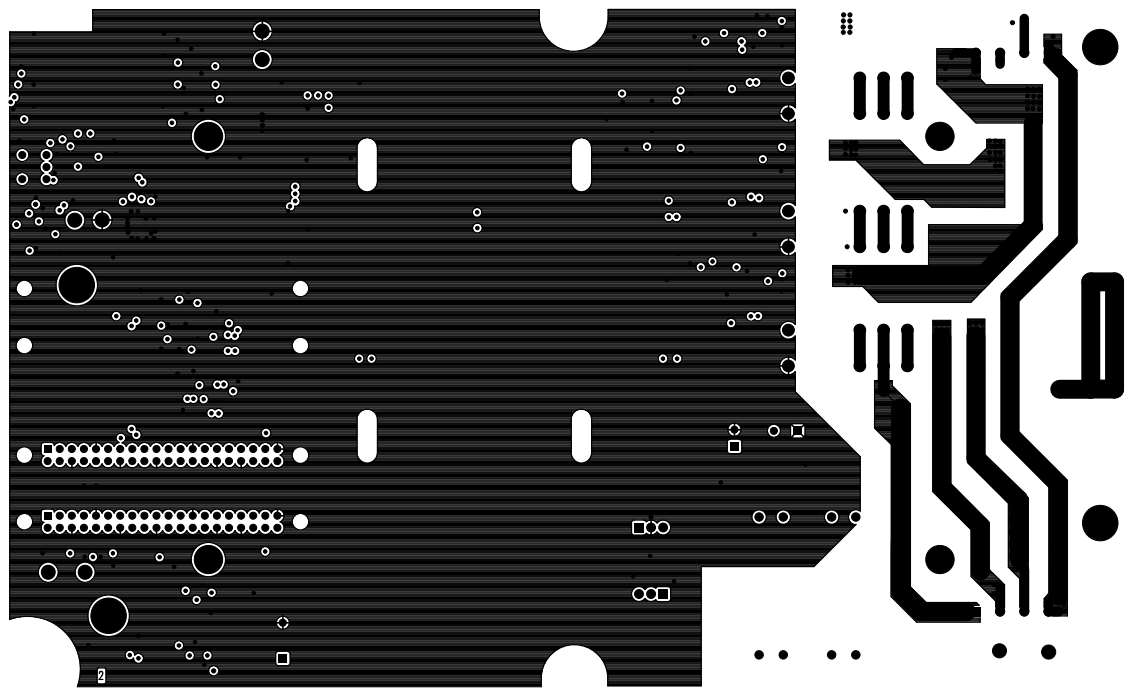
[picture p87: page 1]
