Teukka/FlexHomeElPower/Manufacturing/Electronics/Printed Circuit Board Design/Layer PDFs/Layer3_VCC.pdf

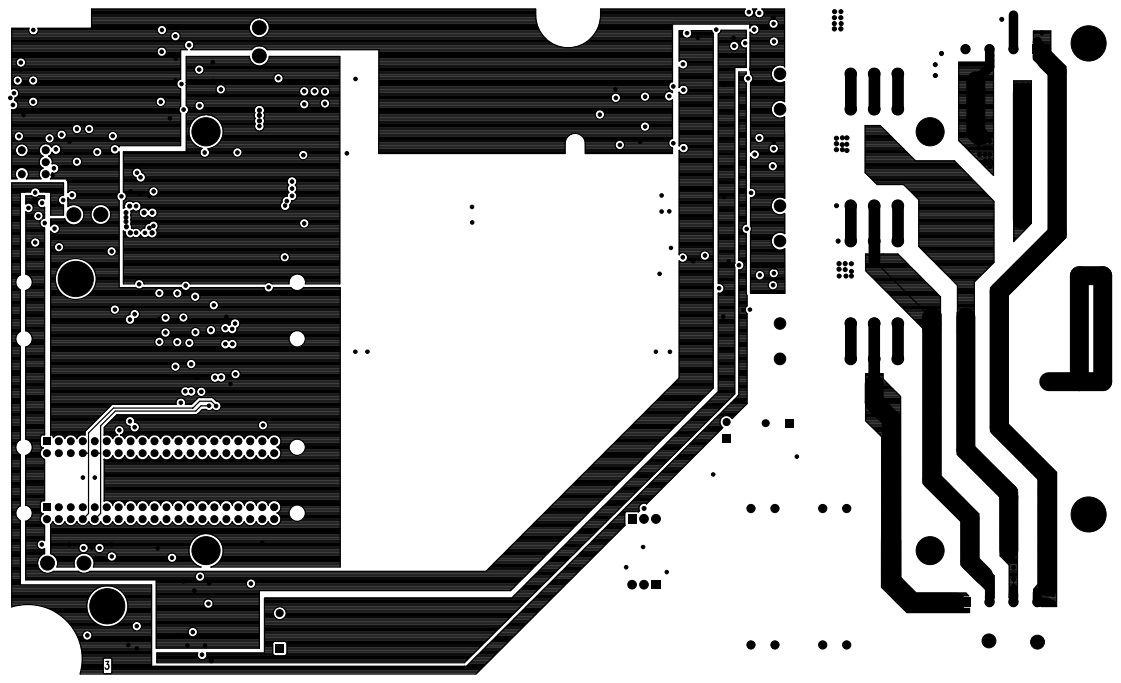
[picture p88: page 1]
