Teukka/FlexHomeElPower/Manufacturing/Electronics/Printed Circuit Board Design/Layer PDFs/Solder Mask Bottom.pdf

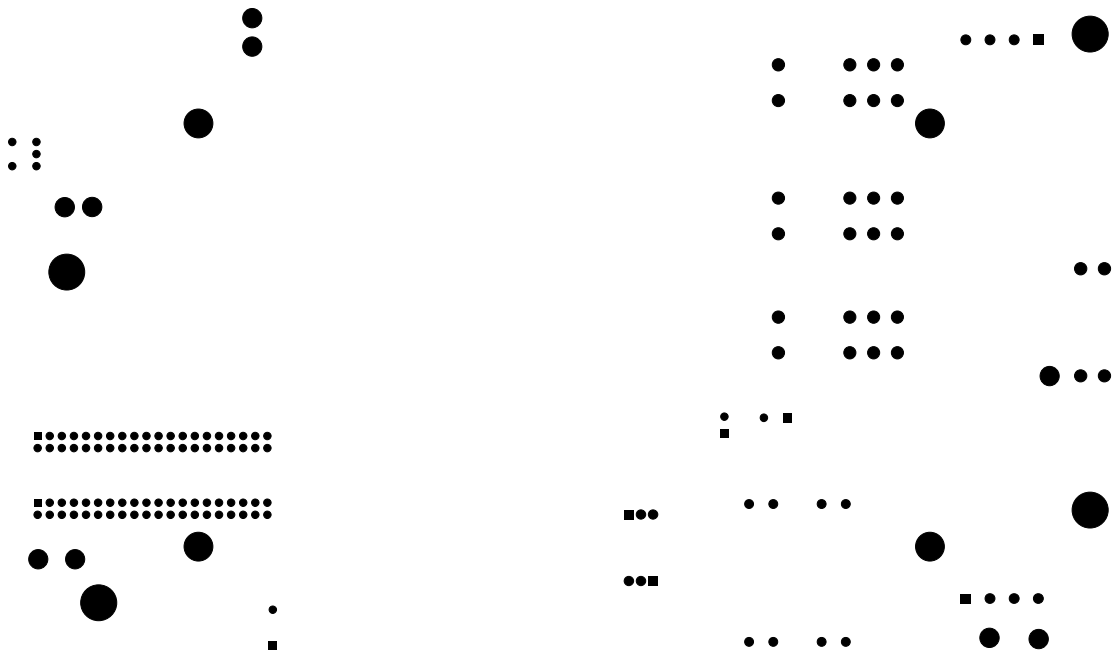
[picture p89: page 1]
