Teukka/FlexHomeElPower/Manufacturing/Electronics/Printed Circuit Board Design/Layer PDFs/Solder Mask Top.pdf

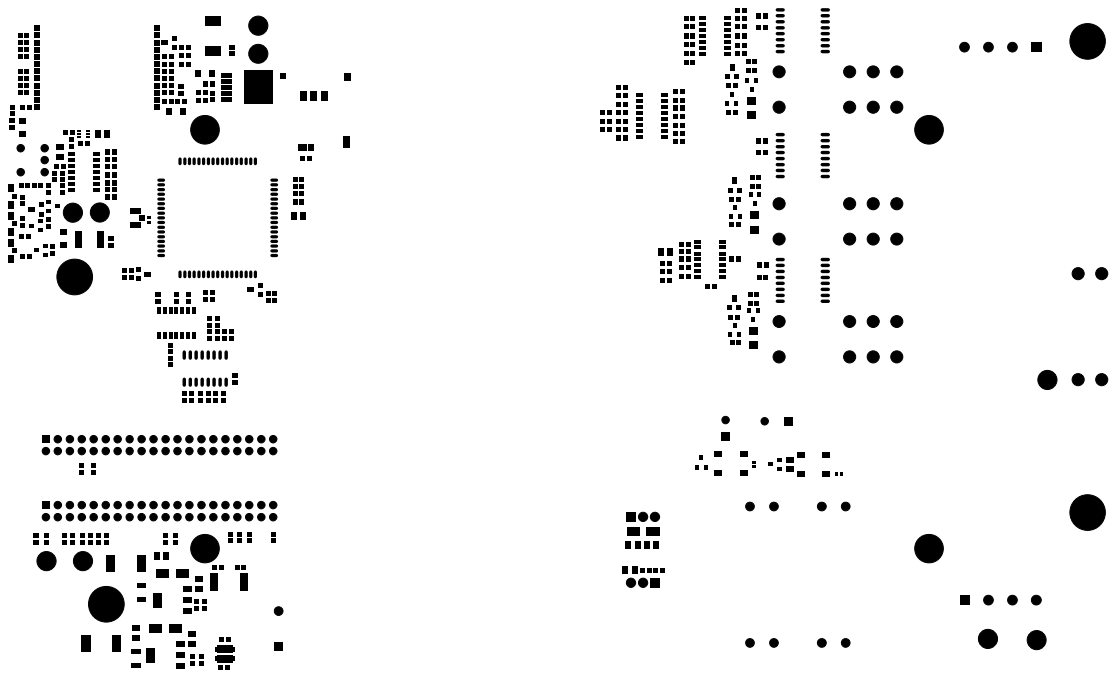
[picture p90: page 1]
