Teukka/FlexHomeElPower/Manufacturing/Electronics/Printed Circuit Board Design/Layer PDFs/Solder Paste Mask Top.pdf

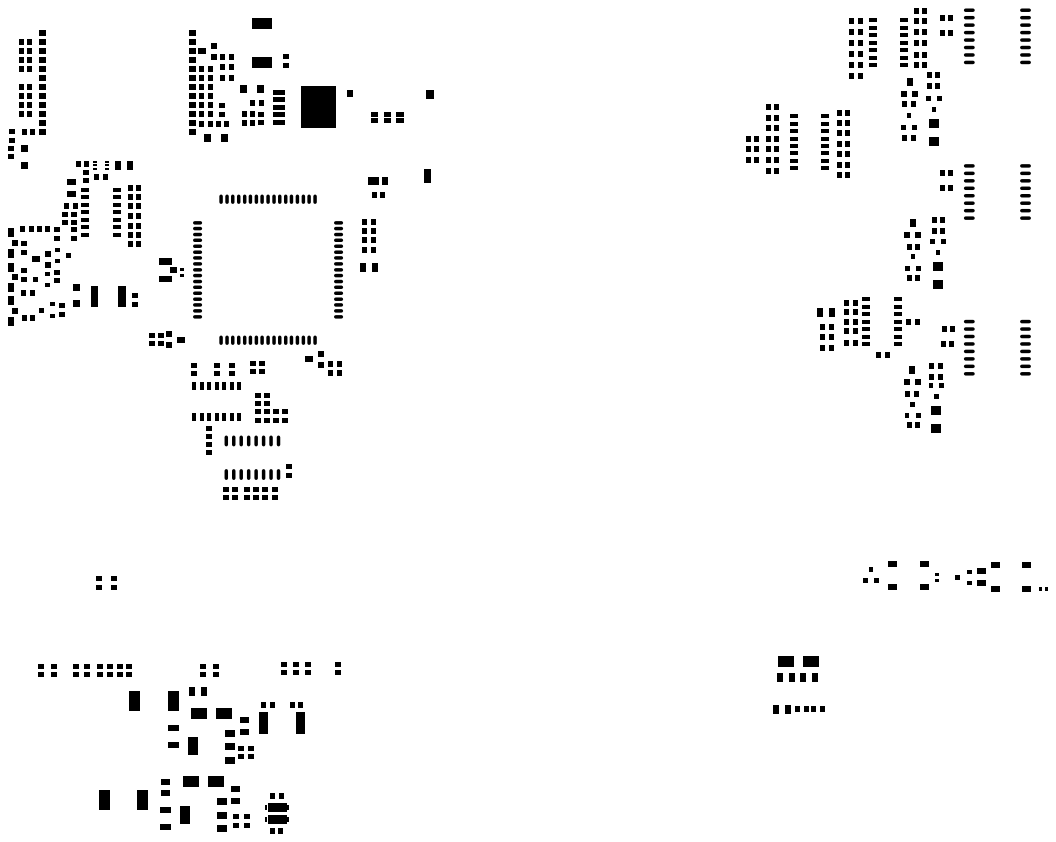
[picture p91: page 1]
