Teukka/FlexHomeElPower/(list of files, drawings)

Other design files:
Manufacturing/Electronics/Printed Circuit Board Design/P4159100.pcb
