Teukka/FlexHomeElPower/(commit log)

2018-12-19 Control Device Documents
2018-12-20 Control Device Guides as PDF files
2018-12-20 JouKo control device software - Installation guide
2018-12-20 JouKo Control Device Software Guides
2018-12-20 General and hardware documents
    [K4159100.sch, P4159100.pcb]
2018-12-20 Jouko Control Device Software documents
2019-03-19 JouKo indicator LEDs
    Description of the three indicator LEDs on JouKo device: red, yellow and green.
2020-03-10 Revised Voltage Source build-up Document
